michaellangford99/ECE47700/README.md

# ECE47700

Placeholder for eventual Github Pages display of course information
