michaellangford99/ECE47700/docs/status reports/michael_langford/wk15/progress_report_wk15.htm

IMU

This was mostly last week, but I created an algorithm to modify in real time the parameter controlling the relative trust the complementary filter has in the gyro vs. the accelerometer. It works by sensing when the length of the vector comprising the total acceleration felt by the accelerometer is greater in magnitude than 1G, indicating that noise or movement is taking place. The differential is then used to generate a correction factor to apply to the parameter ‘Alpha’ which estimates which measurement is more accurate.

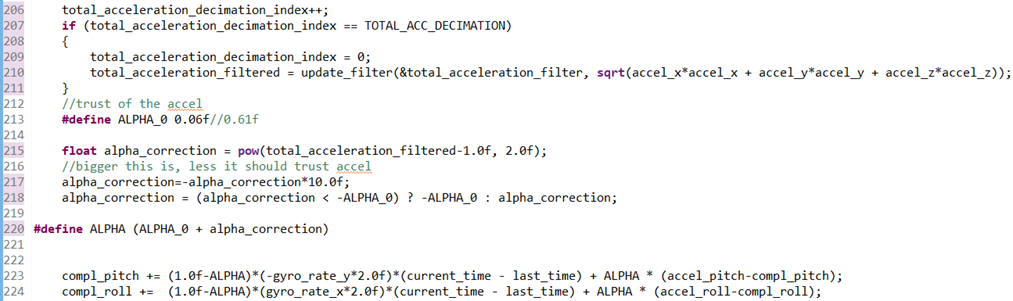
[picture p62: docs/status reports/michael_langford/wk15/progress_report_wk15_files/image002.png]
Text Description automatically generated with medium confidence


Fig. 15- 1. Source code of filter correction algorithm

In addition to the LSM6DSO, there is also an MPU6500 on the PCB, which has not as yet been used. I also wrote driver code for that this week, which wasn’t hard seeing as I already had code for it from an old project. This meant the bulk of the effort was just switching from the previous project’s SPI implementation to the current one. I then cloned the LSM6DSO driver’s calibration and sensor fusion code, and got things nearly working, and then 4

Due to my original code structure, there was no way to change or specify the CS pin, meaning that the SPI bus would blindly use the CS pin it chose on startup, rather than using different ones per device. So I created a structure that holds the IMU data that can be accessed by any other C file, as well as adding functionality and pin setup code to select which CS pin is active at that point in time, and the SPI driver will switch to using that one.

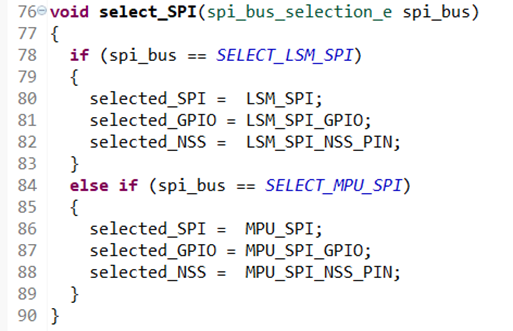
[picture p63: docs/status reports/michael_langford/wk15/progress_report_wk15_files/image004.png]


Fig. 15- 2. SPI bus selection

With this new structure working, I tried running the full PID loop + motor + radio code to test the response of the drone. Unfortunately, I noticed immediately that there was a huge issue with the noise induced in the data by the vibration from the motors running.

I found an application that can perform a real time FFT on incoming serial data, to take a look at the noise spectrum while the motors are running. I was hoping all the noise was high frequency and could be filtered, however it was broadband, and the gyro was hitting it’s max dynamic range as well.

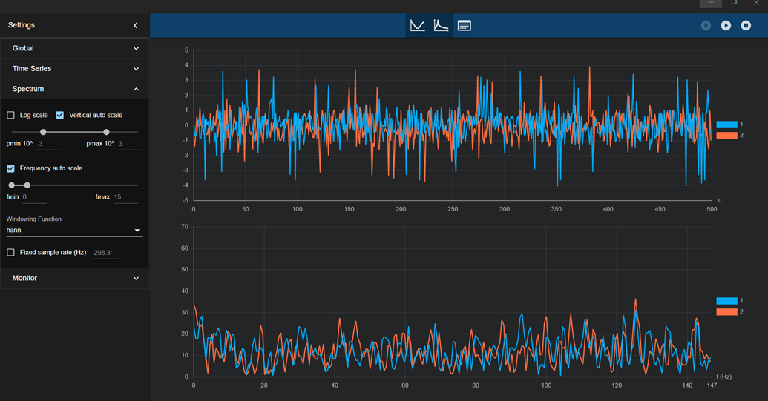
[picture p64: docs/status reports/michael_langford/wk15/progress_report_wk15_files/image006.png]


Fig. 15- 3. Serial Spectrogram

With the motors running and the drone still, the pitch and roll quickly diverged from an accurate measurement of the heading.

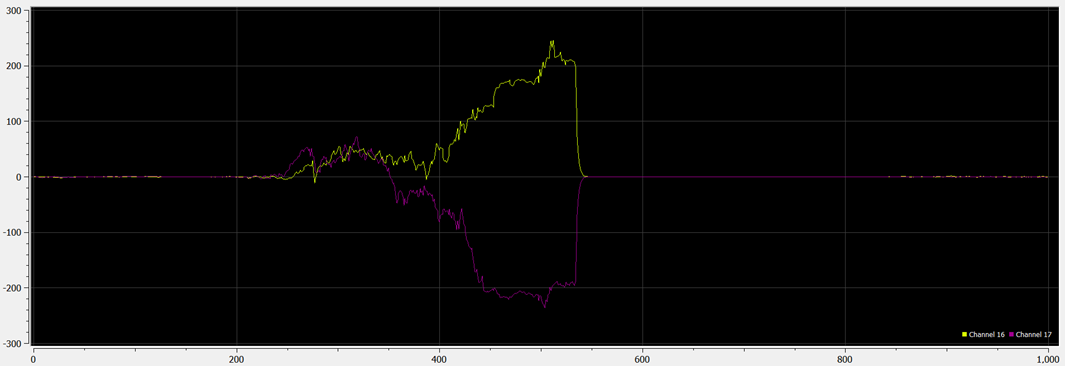
[picture p65: docs/status reports/michael_langford/wk15/progress_report_wk15_files/image008.png]


Fig. 15- 4. Very messed up gyro readings

Mechanical

In order to fix the vibration issues, I had to use an alternate mount to the original rigid mounting setup. I found a piece of soft anti-static foam, and glued the 3D printed mount onto the foam, and then onto the motor controller.

I initially just tried using O-rings at the mount points, however this wasn’t sufficient.

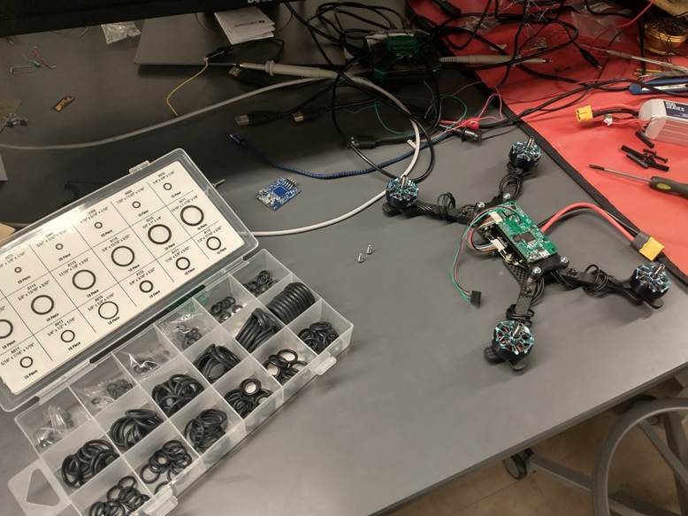
[picture p66: docs/status reports/michael_langford/wk15/progress_report_wk15_files/image010.jpg]


Fig. 15- 5. Trying to use O-rings to damped vibration

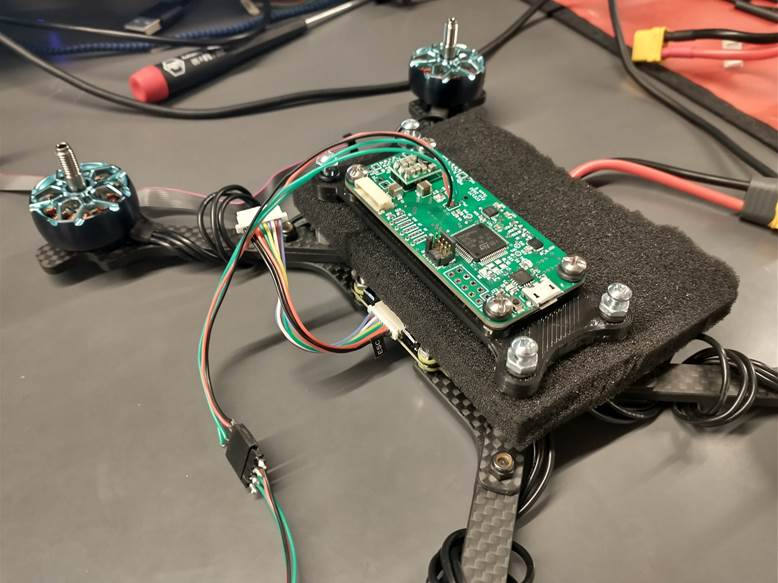
[picture p67: docs/status reports/michael_langford/wk15/progress_report_wk15_files/image011.jpg]
A circuit board with wires Description automatically generated with low confidence


Fig. 15- 6. Trying out foam

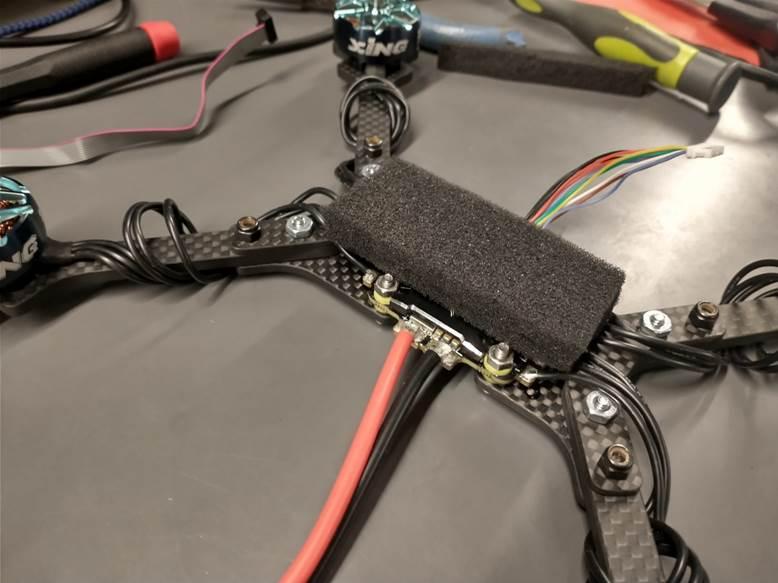
[picture p68: docs/status reports/michael_langford/wk15/progress_report_wk15_files/image012.jpg]


Fig. 15- 7. Foam sized properly

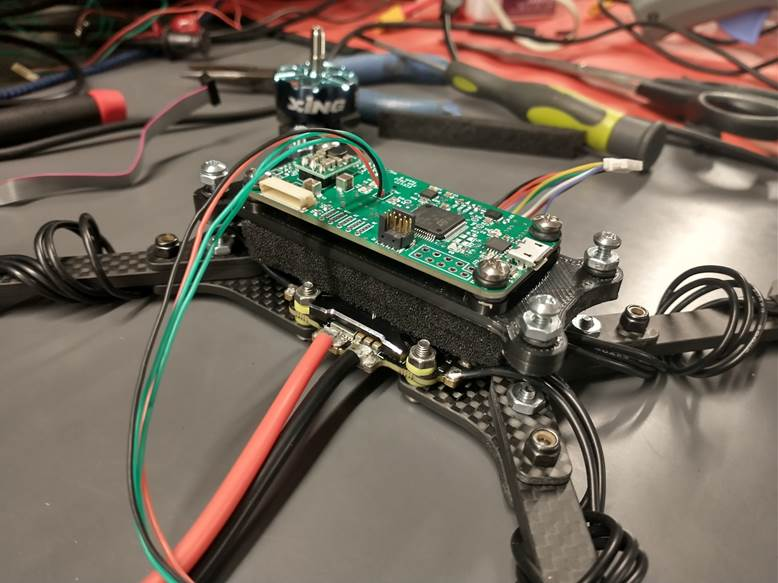
[picture p69: docs/status reports/michael_langford/wk15/progress_report_wk15_files/image014.jpg]


Fig. 15- 8. Trying foam and rubber mounts

Once I mounted the flight controller on the foam, the noise was drastically reduced, almost eliminated. Aside from some resonance rpm rates, the noise stayed within or close to the inherent variance of the sensor.

Battery

In addition to the mechanical work to avoid vibration, I also mounted the battery to the bottom of the drone using some very strong Velcro-ish stuff.

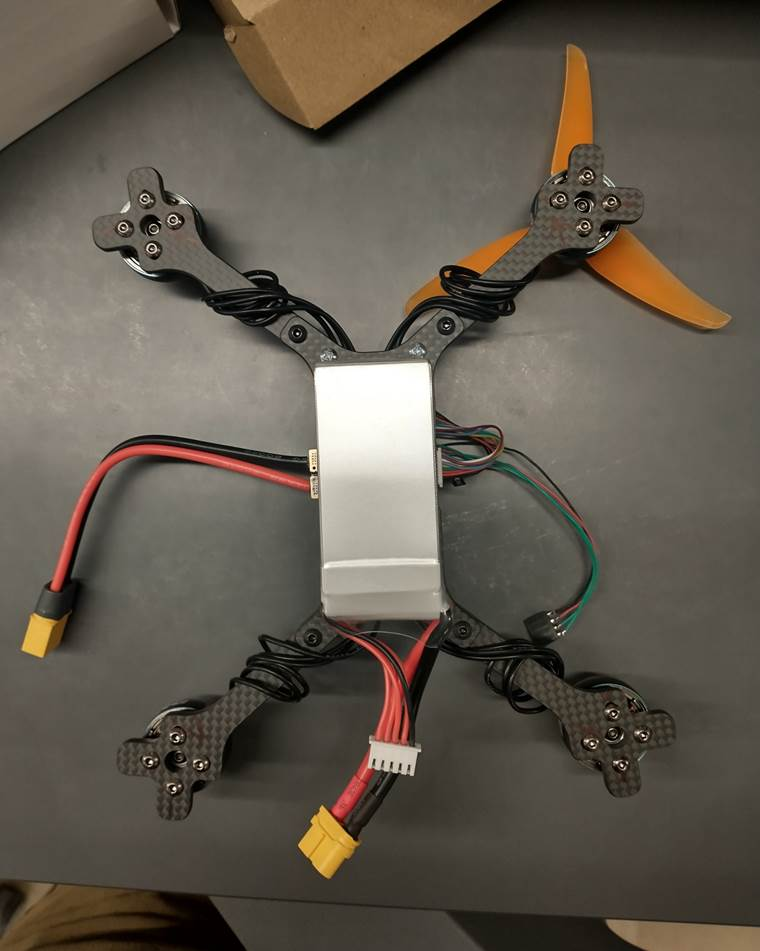
[picture p70: docs/status reports/michael_langford/wk15/progress_report_wk15_files/image015.jpg]


Fig. 15- 9. Battery mounted

As an aside, the usage of the batteries during testing finally necessitated charging, so we used a typical multi-cell LiPo charger to charge them.

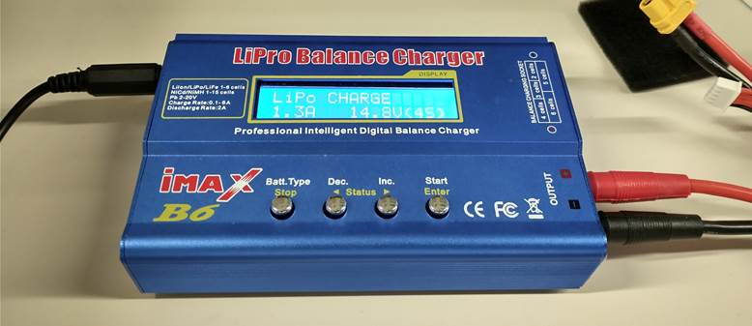
[picture p71: docs/status reports/michael_langford/wk15/progress_report_wk15_files/image016.jpg]


Fig. 15- 10. Just your average neighborhood battery charger

Radio

The radio also had to be permanently mounted, as it had been connected with a temporary connector initially. I detached the original connector and soldered the radio directly to the original wires. I then hot-glued the radio onto a nylon standoff, and glued that onto an unused part of the PCB.

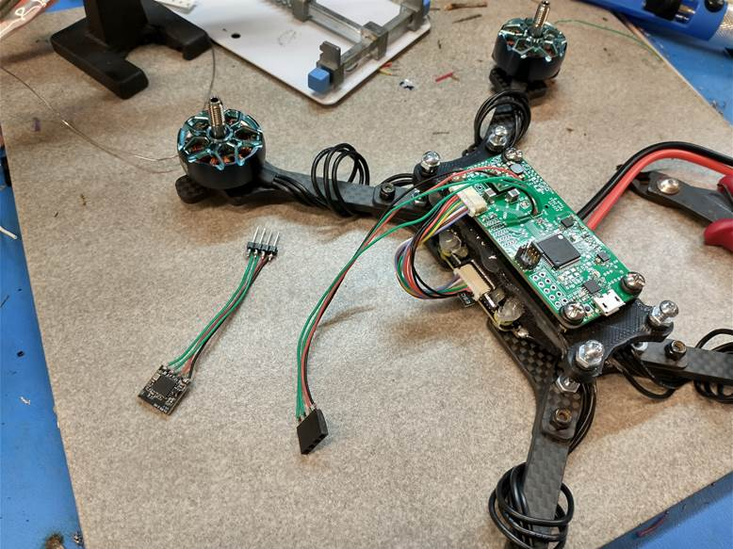
[picture p72: docs/status reports/michael_langford/wk15/progress_report_wk15_files/image017.jpg]


Fig. 15- 11. Radio before

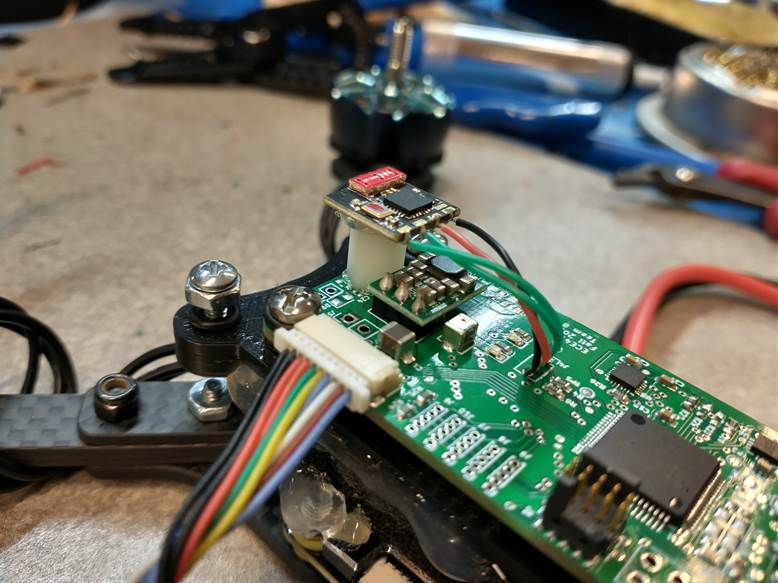
[picture p73: docs/status reports/michael_langford/wk15/progress_report_wk15_files/image018.jpg]


Fig. 15- 12. Radio after

PI UART

On the navigation computer side, Owen has been working on UART comms to and from the flight controller, so on my end I worked on completing the UART code necessary to both transmit IMU data frames as well as interpret LIDAR information and steering commands coming from the PI. We together decided upon a simple binary frame format for the transmission from the PI to the flight controller, to lessen the processing burden of having to parse any stringified data. A predefined start code ‘magic number’, a predefined structured data packet, and a CRC byte makes up the frame. There are 4 LiDAR sensors read by the PI, as well as 3 steering heading commands (yaw, pitch and roll). The LiDAR readings are 16 bits each, so 8 bytes total, and the headings are 32 bit floats, so 12 bytes total for headings. Plus the camera status, start code, and CRC, that makes 23 bytes of data. Or so we thought – the Pi was surprisingly 32 bit aligning the 3 float values sent, so in between there actually 2 bytes of zero-padding, making the actual packet length 25 bytes.



Fig. 15- 13. Pi to flight controller frame format (credit: used https://wavedrom.com/ to draw)

The code to accomplish this was very similar to the radio receiver parsing code, where it looks for valid conditions within a circular buffer. The code automatically adapts to any new definition or change to the internal packet layout, making editing and extension easy.

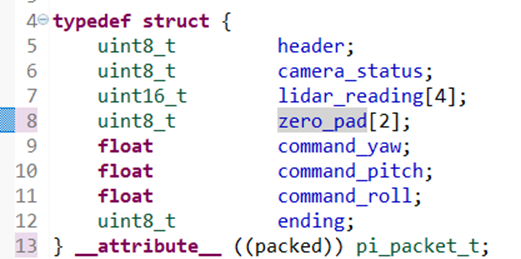
[picture p74: docs/status reports/michael_langford/wk15/progress_report_wk15_files/image030.png]


Fig. 15- 14. Pi to flight controller frame struct

To test this setup, Owen and I wired a cable between his Pi and the flight controller, sharing ground in addition to the UART RX and TX lines. I used the actual pins that will be used for the Pi once it mounts directly, to avoid any issues with changing pins.

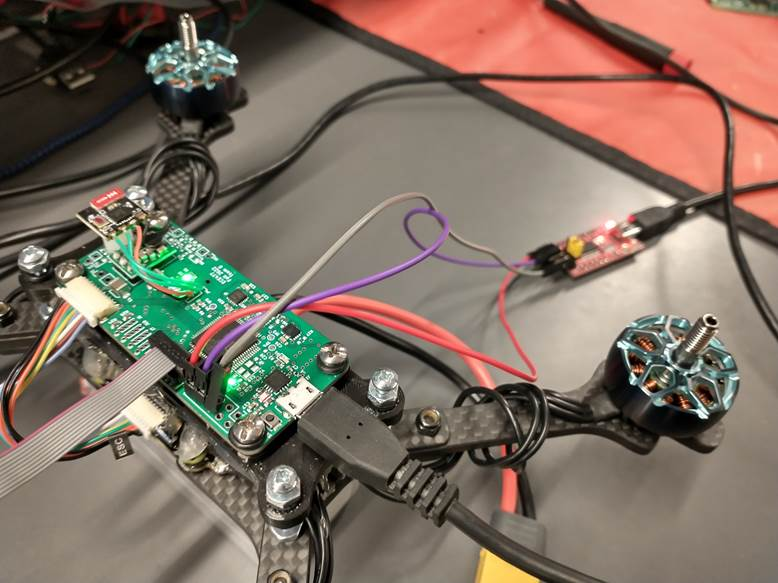
[picture p75: docs/status reports/michael_langford/wk15/progress_report_wk15_files/image031.jpg]


Fig. 15- 15. Testing Pi communication initially with FTDI

For the information transmitted from the flight controller to the Pi, we decided upon a printf string of comma separated values for yaw, pitch, roll, and any other values that become necessary. This text is very easy to for the Pi to parse, especially as it has the necessary computing power needed to parse it quickly.

Before testing with the Pi, I used an FDTI to inspect the outbound data from the Pi, and could inject commands to the flight controller and see if those commands were reflected in the output from the USB UART port.

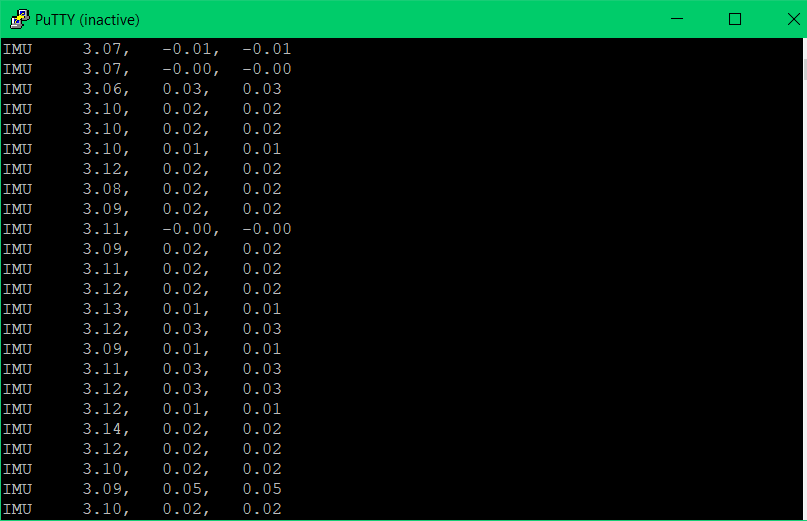
[picture p76: docs/status reports/michael_langford/wk15/progress_report_wk15_files/image032.png]


Fig. 15- 16. IMU frames from flight controller to Pi, recorded via FTDI

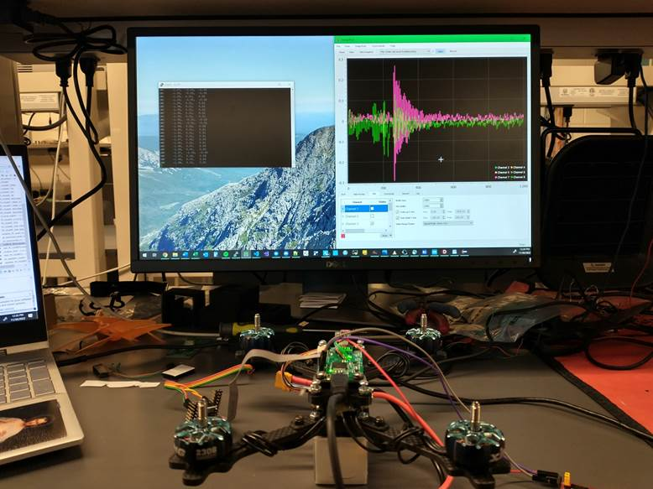
[picture p77: docs/status reports/michael_langford/wk15/progress_report_wk15_files/image033.jpg]


Fig. 15- 17. Testing IMU frame transmission to Pi. Both USB UART log (plot on right) and PI UART are active simultaneously.

Once my side was working, we integrated our hardware with a long cable to carry the serial data from board to board. I kept the FTDI listening in on the communications however to verify functionality.

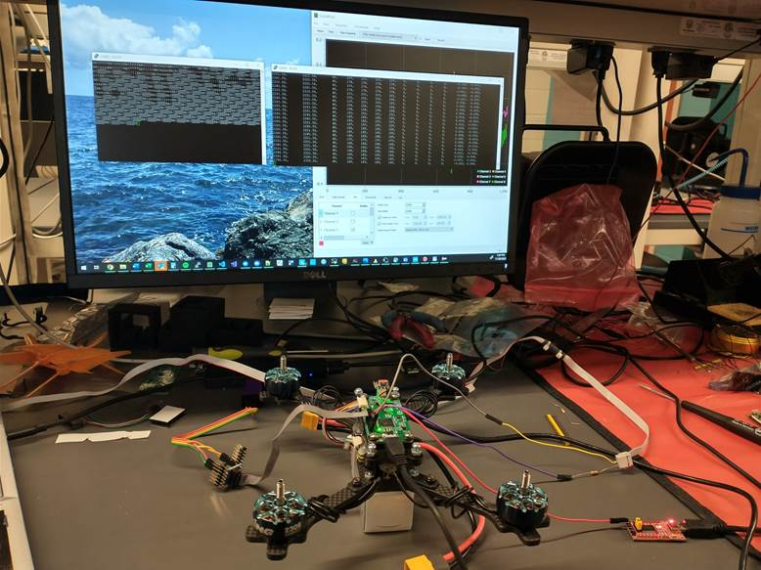
[picture p78: docs/status reports/michael_langford/wk15/progress_report_wk15_files/image034.jpg]


Fig. 15- 18. UARTs side by side. Pi UART (left) shows binary stream from Pi.

After a few kinks were worked out, the LiDAR data streamed over via the serial cable, was interpreted by the Pi UART driver, and recorded. Then this data was printed out via the main log.

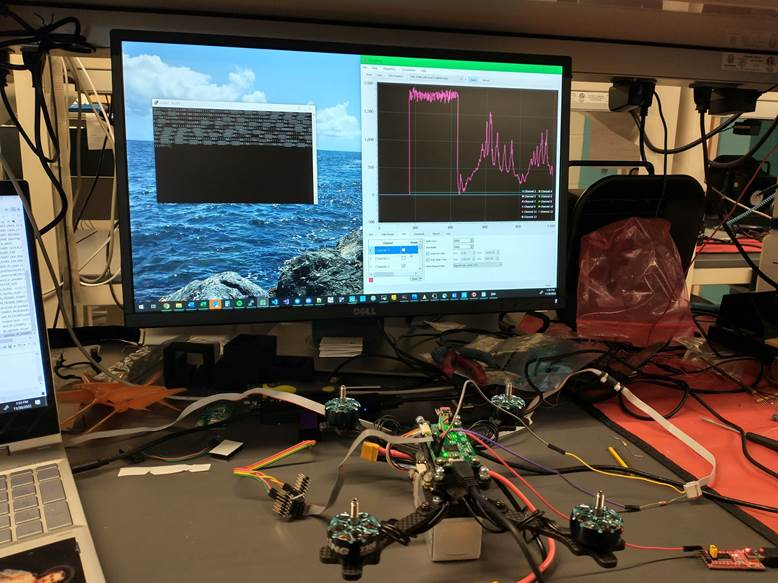
[picture p79: docs/status reports/michael_langford/wk15/progress_report_wk15_files/image038.jpg]


Fig. 15- 19. LiDAR data finally streaming through from PI

Motors

This week I also switched to using OneShot125 correctly and running it at maximum data rate, around 3.8kHz, rather than the previous 400Hz.



Fig. 15- 20. Oneshot125 Timing diagram.

After testing the PID loops with the motors running, and readying the drone for test flights, I needed to ensure that the propellers on the drone were spinning the correct direction. The torque induced from the motors rotating is very significant, and if the motors spin the wrong direction this torque will not be counteracted and will spin the drone out of control.

For this reason, half the motors have to spin counterclockwise and half clockwise. However, if just any two are chosen, then when the drone attempts to counteract an imbalance in pitch or roll, it may change the speeds of the motor pair that spins in the same direction, resulting in a torque differential, and then spin. Thus, it must have the motors on a diagonal with each other spin in the same direction. Thus when any pair of motors on a side changes speeds, both the CCW spinning motor and the CW spinning motor will change speeds equally, resulting in net zero torque.

Switching motor spin direction can be as simple as swapping two wires in the motor hookup, however I wanted to avoid this as I had already had enough of a painful experience soldering the motors the first time.

Instead of soldering again, it is possible to reprogram the ESC settings to change its pulse order so that the motor spins in reverse of its original direction. This is usually a really simple process for people with commercially available flight controllers with popular software onboard, less so for me with a custom flight controller. Most flight controllers have a feature that allows the flight controller to act as a pass-through reprogrammer for the ESC.

As my poor little flight controller can’t do that, I had to dig around online for other solutions. Apparently, it is possible to use an Arduino nano and some prebaked hex files to get it to act as a programmer. This was very poorly documented, so it took a lot of trial and error and hair-pulling.

I want to include the details of this process in this progress report to serve as a more permanent record of how I got this to work.

First, I acquired an Arduino Nano that was in storage. I then installed the necessary CH340 UART to USB drivers, and connected the Nano.

Next, I created a cable to go between the JST ESC connector and the breadboard with the Nano. This was a huge pain with the pitch of the pins, but I got it to work eventually.

I then flashed the Nano via the BLHeli_32 configurator software:

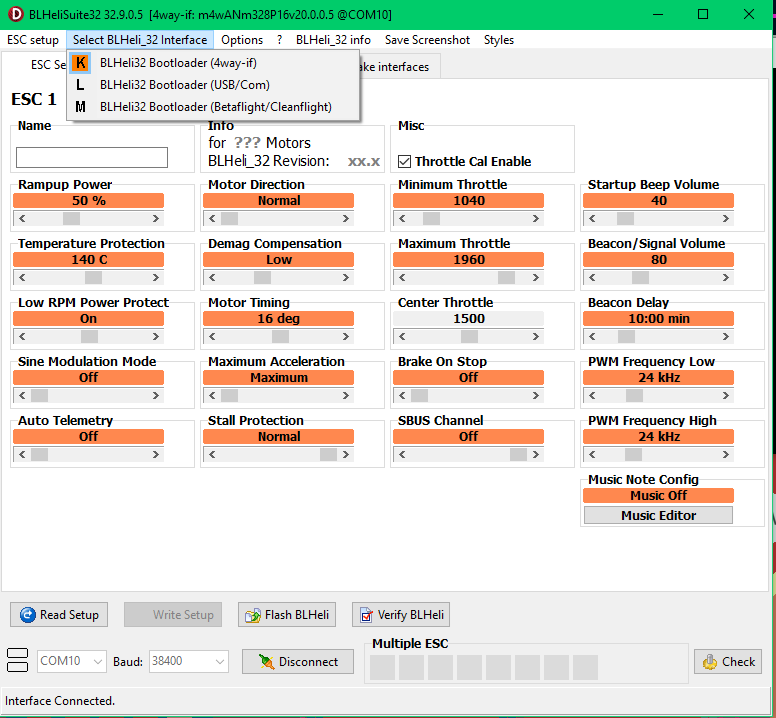
[picture p80: docs/status reports/michael_langford/wk15/progress_report_wk15_files/image042.png]


Fig. 15- 21. BLHeli_32 Configurator

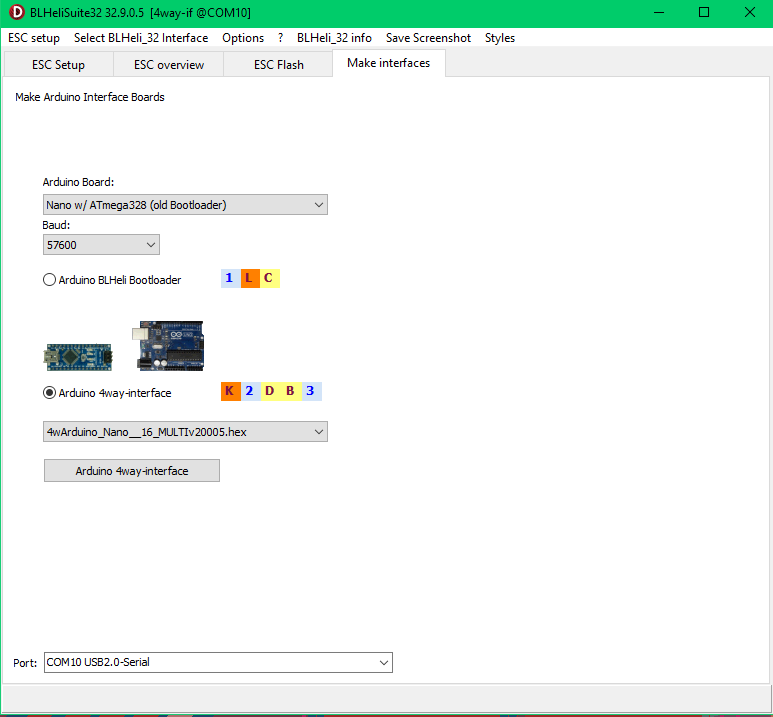
[picture p81: docs/status reports/michael_langford/wk15/progress_report_wk15_files/image044.png]


Fig. 15- 22. Flashing the Nano. Select 'Arduino 4-way-interface' and the correct board.

Next, I had to determine the correct pins on the Nano to hook up the ESC PWM pins to. After (a lot of) hunting around, I found a document identifying for which Arduino board the pins I aught to use, especially for a 4 channel ESC. Seeing as I was using a Nano, this indicated I should use D3,4,5, & 6.

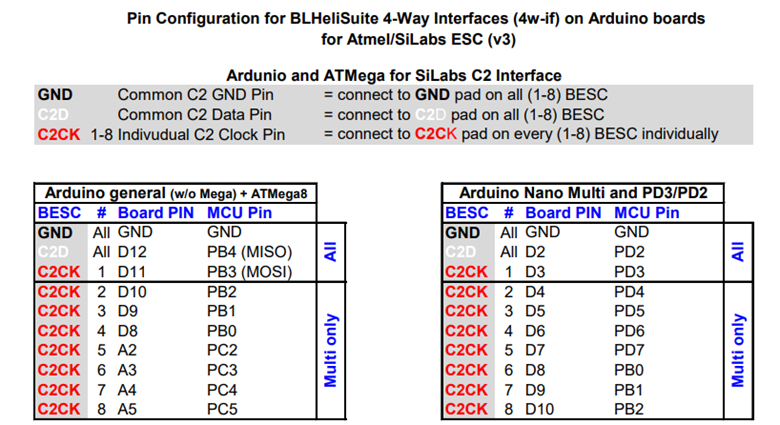
[picture p82: docs/status reports/michael_langford/wk15/progress_report_wk15_files/image048.png]
Table Description automatically generated


Fig. 15- 23. BLHeli32 Pin options for Arduino

After wiring everything up, my setup was as shown.

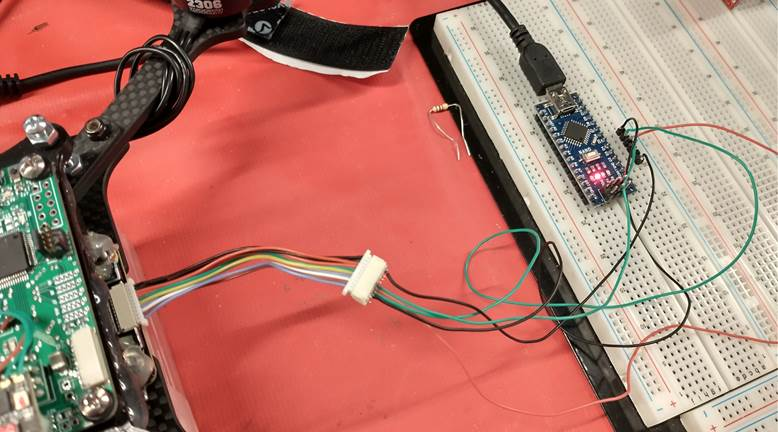
[picture p83: docs/status reports/michael_langford/wk15/progress_report_wk15_files/image050.jpg]


Fig. 15- 24. Connection from ESC to Nano

Once the wiring was set up properly, I was able to connect to the Nano and then to the ESCs.

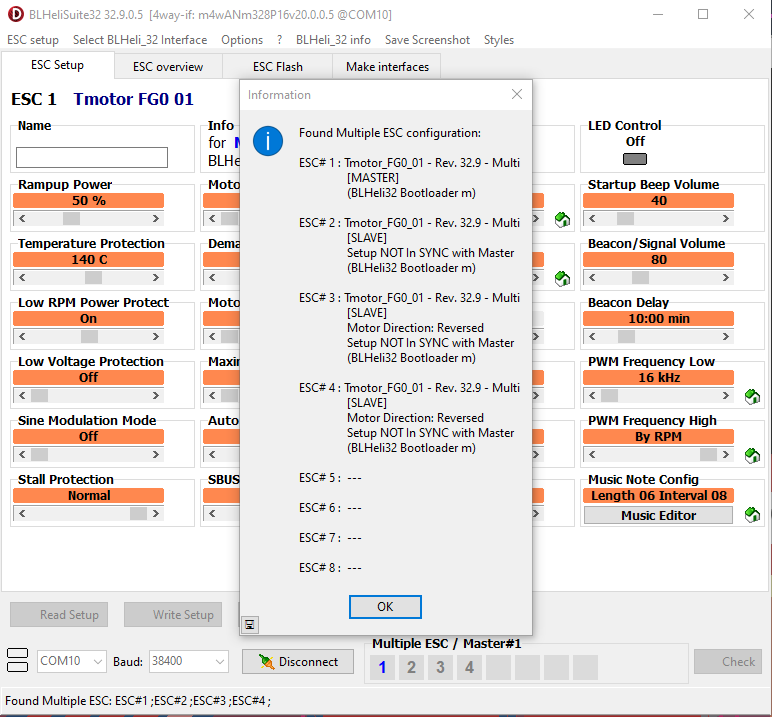
[picture p84: docs/status reports/michael_langford/wk15/progress_report_wk15_files/image052.png]


Fig. 15- 25. BLHeli_32 identifying each of the ESCs on the 4 channel ESC.

With all the ESCs communicating with the configuration software, I was able to identify which motor was connected to which channel, and swap the direction on the needed motor channels.

I then recorded the spin directions on tape to help me keep track of each channel and it’s direction and therefore it’s torque.

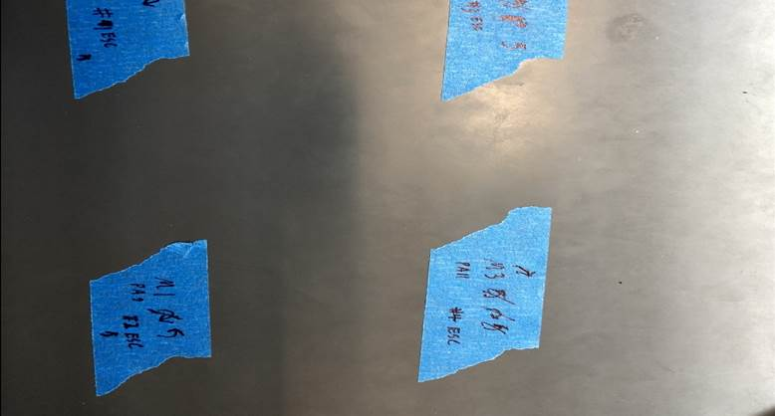
[picture p85: docs/status reports/michael_langford/wk15/progress_report_wk15_files/image060.jpg]


Fig. 15- 26. Recording spin direction

Not mentioned this week due to length:

Safety and arming code

Startup log

PID loop improvements

Motor LPF with hanning window

MATLAB

LIDAR wiring
