michaellangford99/ECE47700/docs/JLCPCB Invoice Team 8.pdf

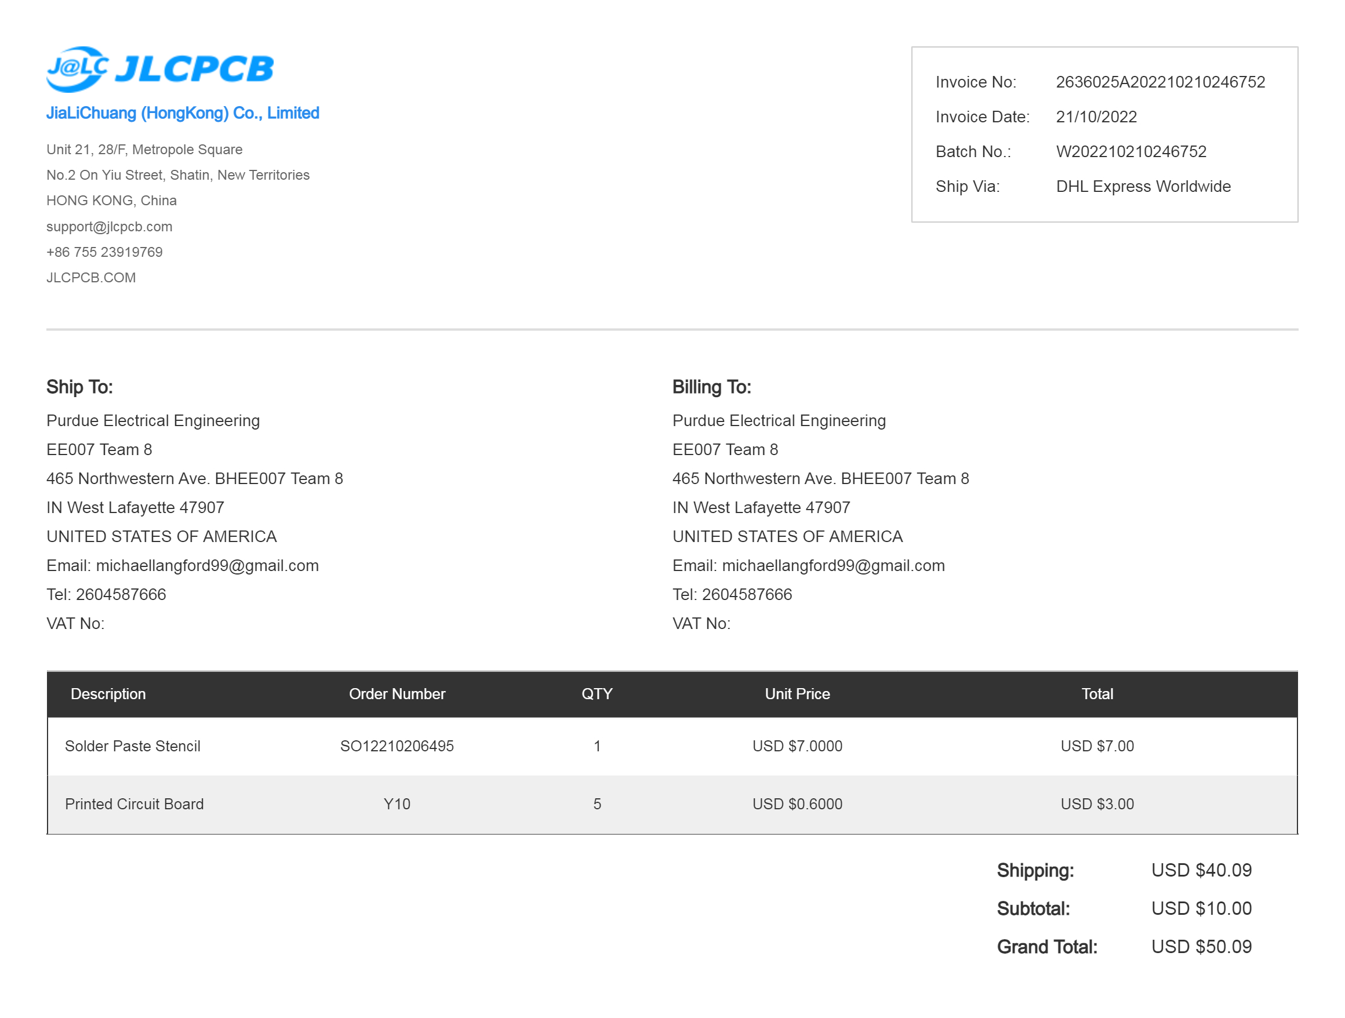
[picture p274: figure]
