michaellangford99/ECE47700/docs/Rough diagram.pdf

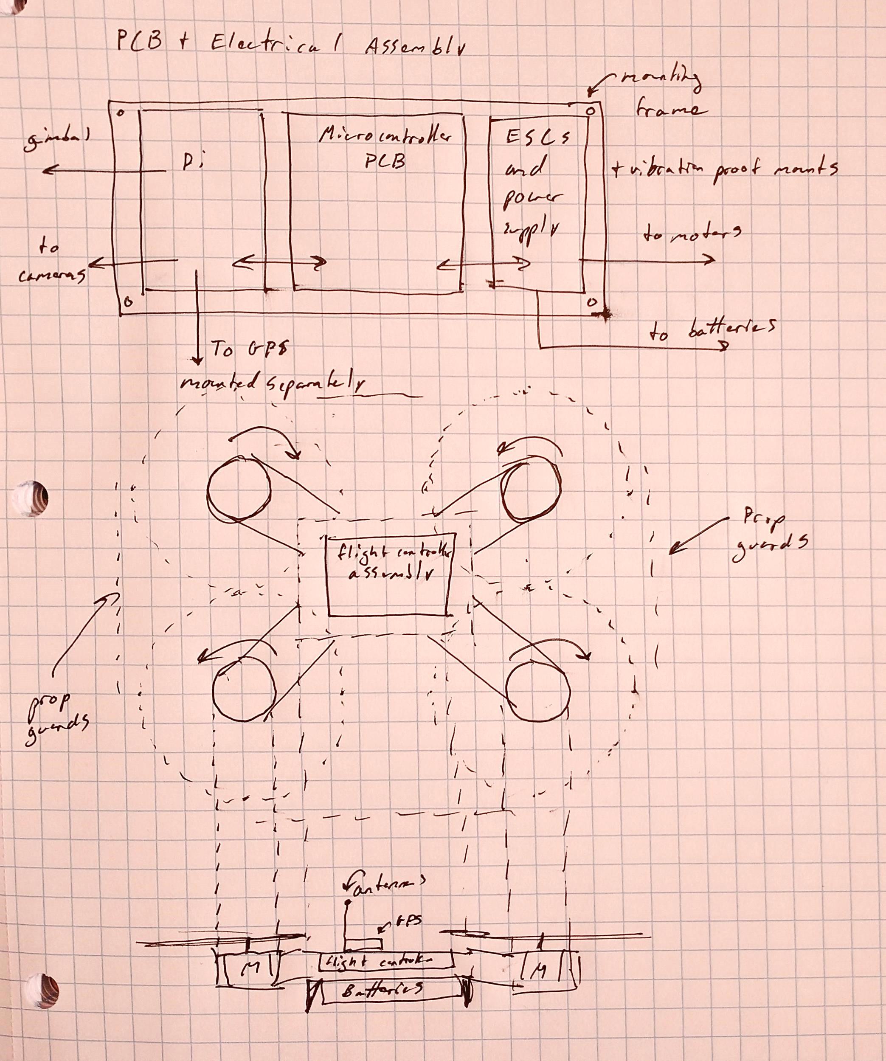
[picture p275: page 1]
