michaellangford99/ECE47700/docs/status reports/michael_langford/schedule.png

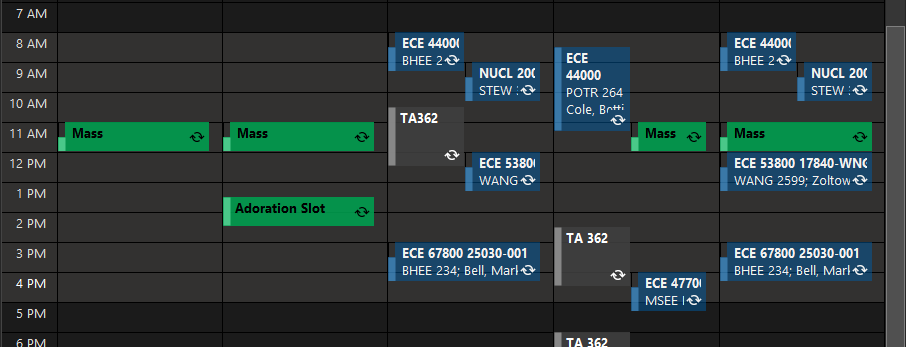
docs/status reports/michael_langford/schedule.png
