michaellangford99/ECE47700/docs/status reports/michael_langford/wk2/pi camera.png

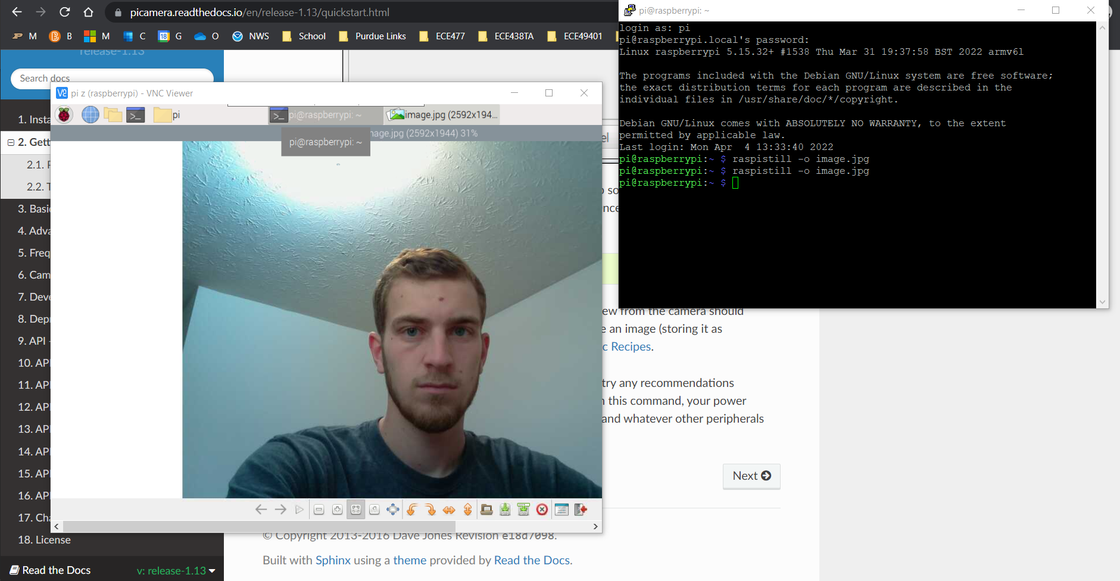
docs/status reports/michael_langford/wk2/pi camera.png
