michaellangford99/ECE47700/docs/status reports/michael_langford/wk3/status_report_wk_3_files/image003.jpg

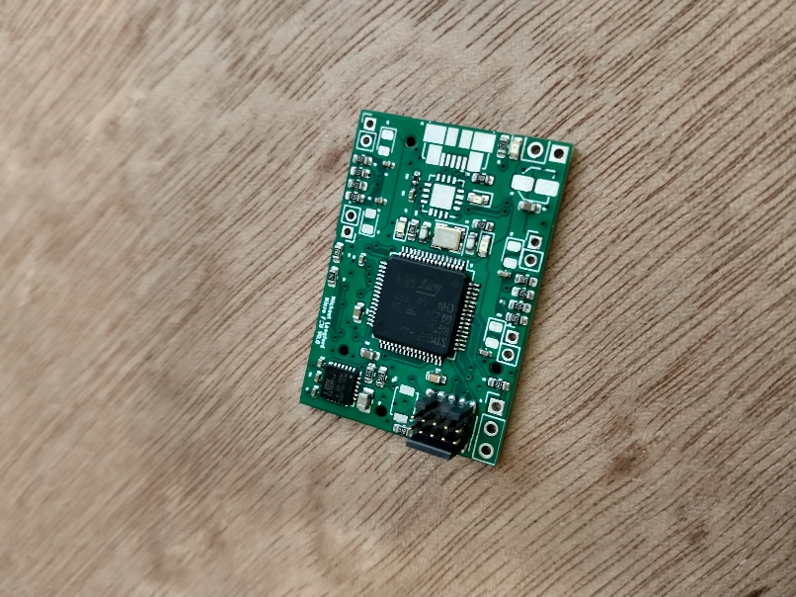
docs/status reports/michael_langford/wk3/status_report_wk_3_files/image003.jpg
