michaellangford99/ECE47700/docs/status reports/michael_langford/wk4/87c77367-0a1b-4ee4-83c8-37e8803b4461.png

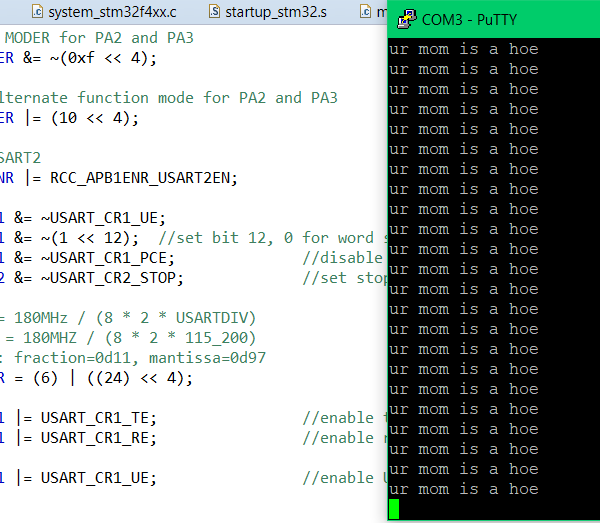
docs/status reports/michael_langford/wk4/87c77367-0a1b-4ee4-83c8-37e8803b4461.png
