michaellangford99/ECE47700/docs/status reports/michael_langford/wk4/progress_report_wk4_files/image013.png

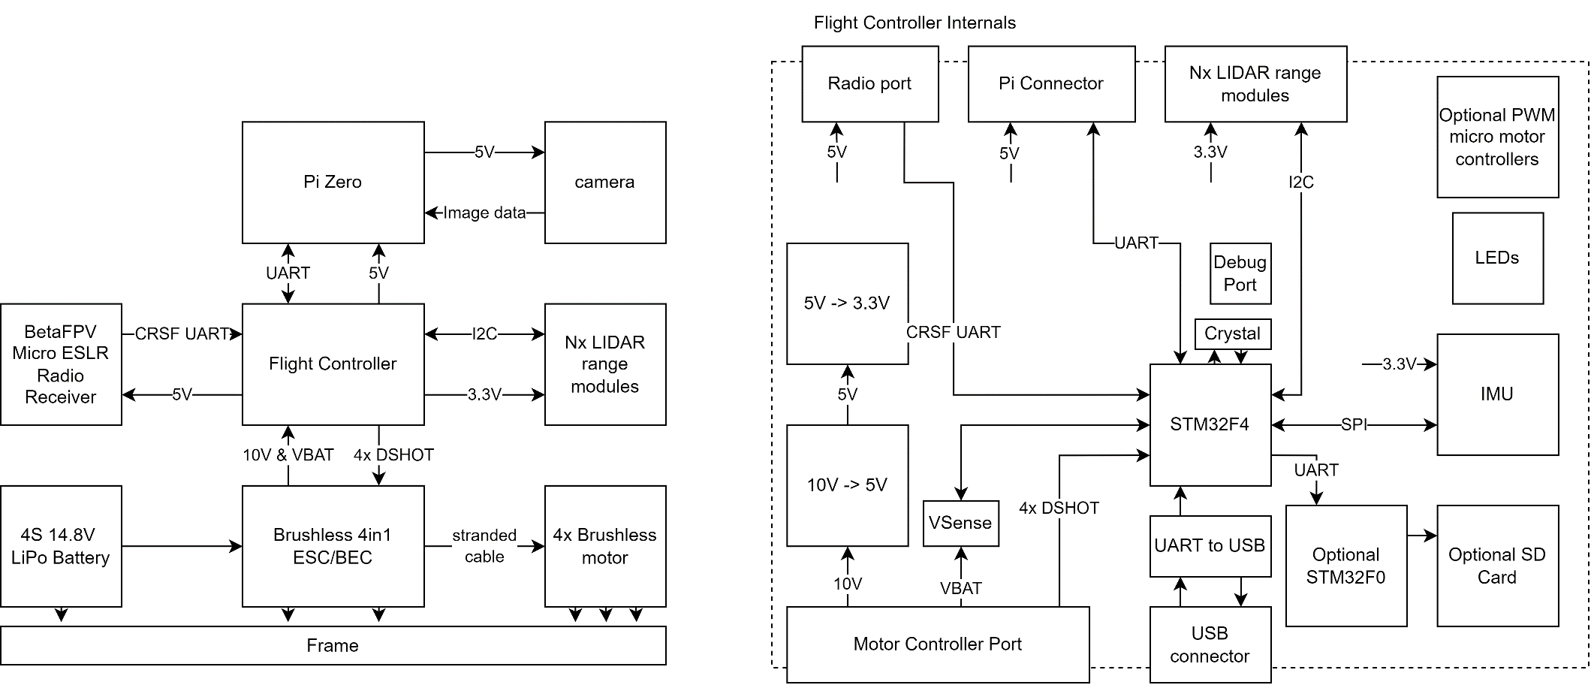
docs/status reports/michael_langford/wk4/progress_report_wk4_files/image013.png
