michaellangford99/ECE47700/docs/status reports/michael_langford/wk5/getting there.png

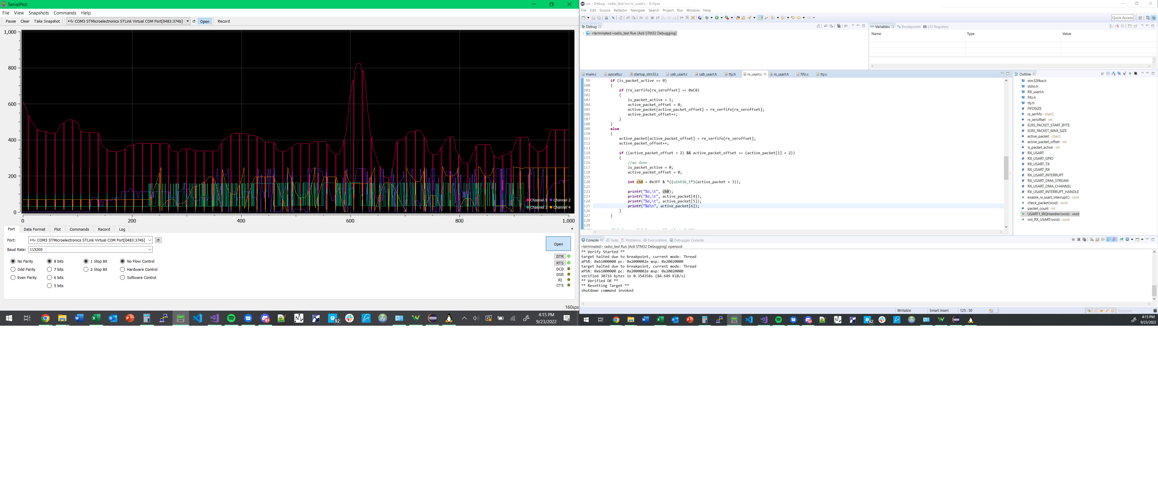
docs/status reports/michael_langford/wk5/getting there.png
