michaellangford99/ECE47700/docs/status reports/michael_langford/wk5/progress_report_wk5_files/image024.jpg

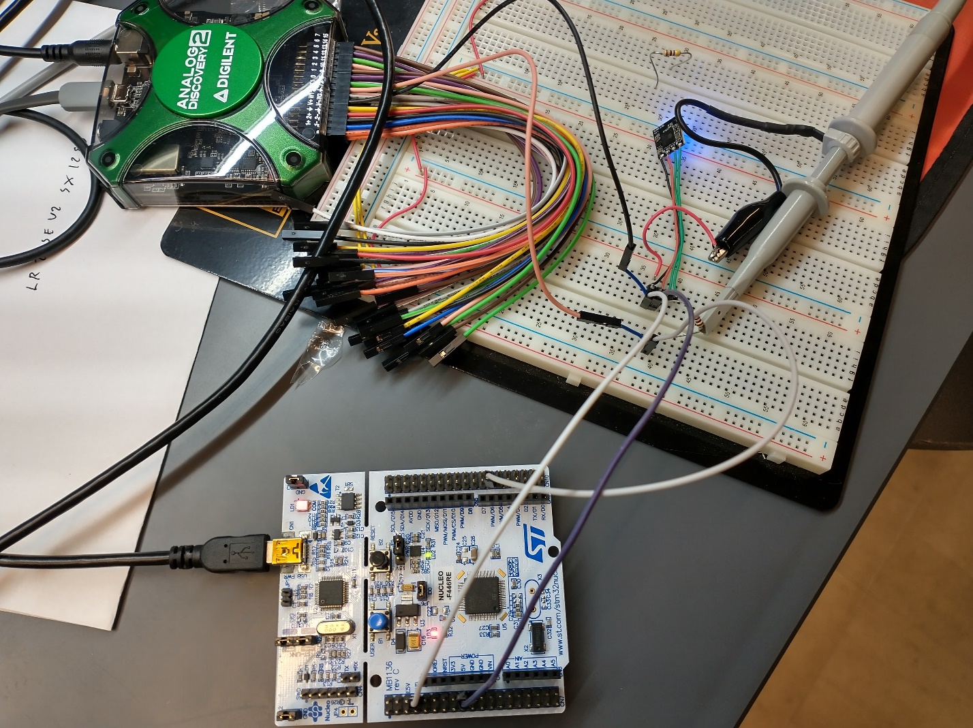
docs/status reports/michael_langford/wk5/progress_report_wk5_files/image024.jpg
