michaellangford99/ECE47700/docs/status reports/michael_langford/wk6/progress_report_wk6_files/image007.jpg

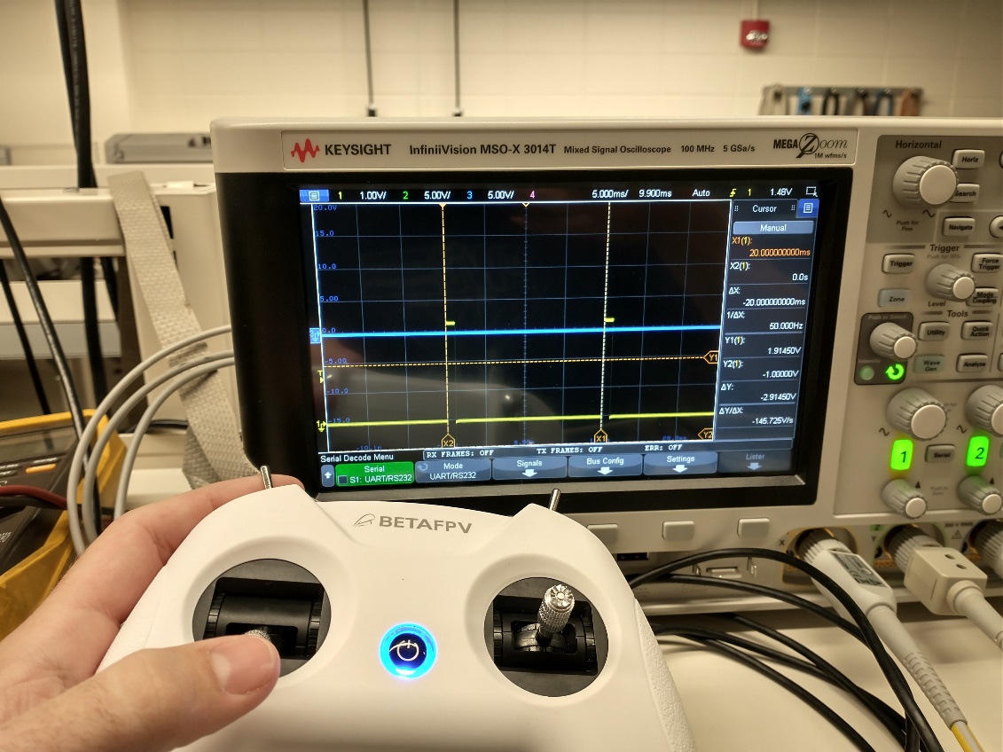
docs/status reports/michael_langford/wk6/progress_report_wk6_files/image007.jpg
