michaellangford99/ECE47700/docs/status reports/michael_langford/wk6/Untitled.png

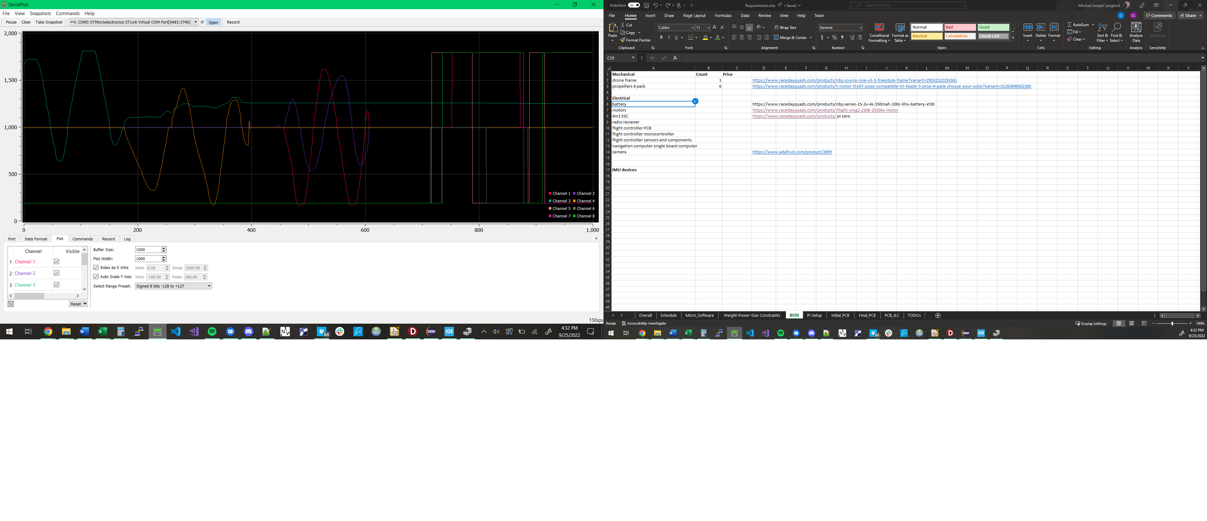
docs/status reports/michael_langford/wk6/Untitled.png
