michaellangford99/ECE47700/docs/status reports/michael_langford/wk10/Screenshot 2022-10-25 192858.png

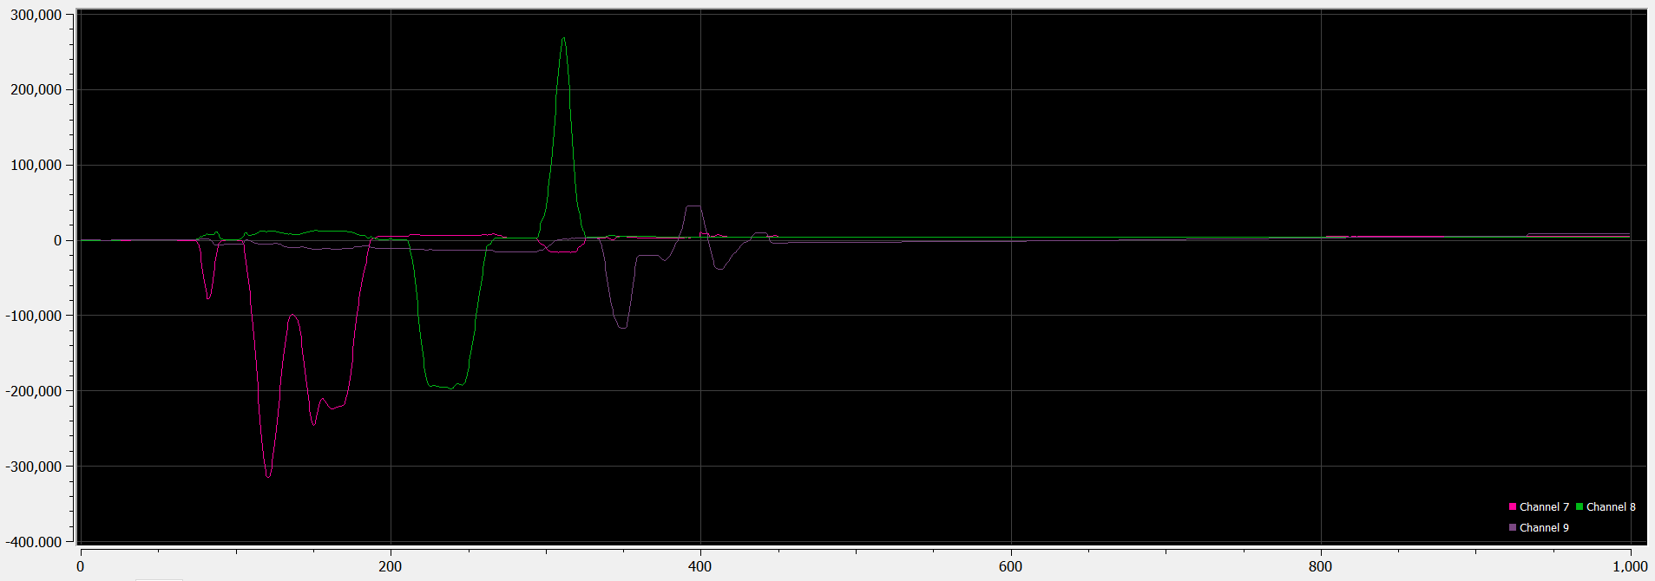
docs/status reports/michael_langford/wk10/Screenshot 2022-10-25 192858.png
