michaellangford99/ECE47700/docs/status reports/michael_langford/wk11/pics/IMG_20221031_231807015_HDR.jpg

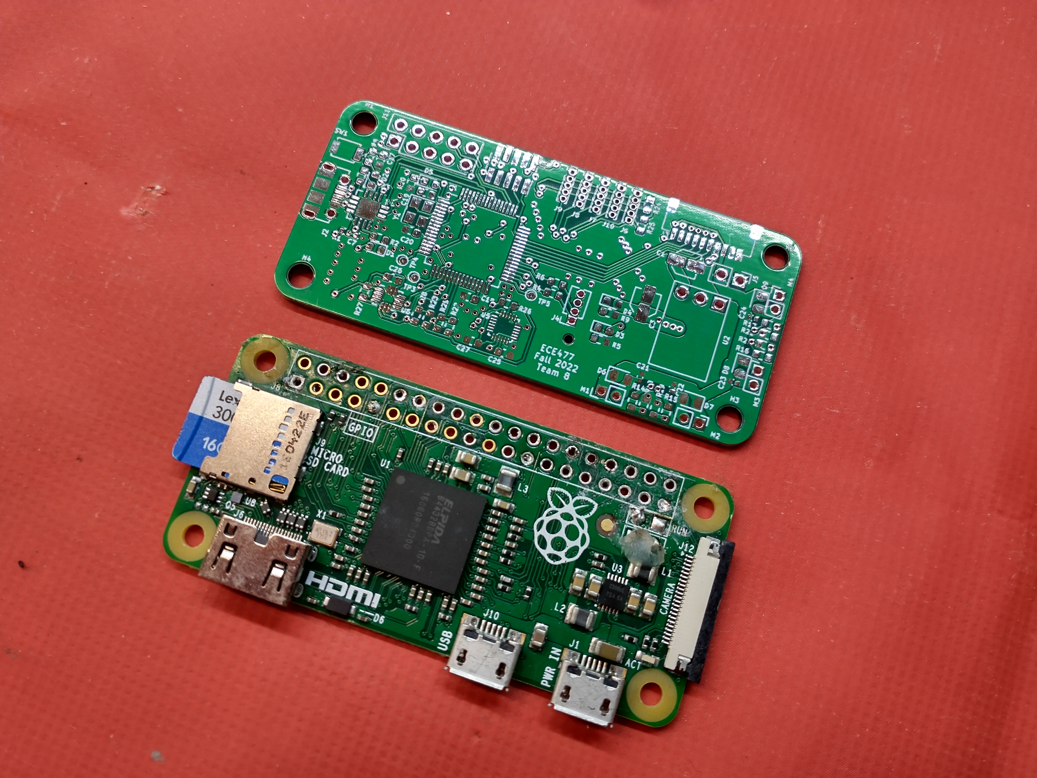
docs/status reports/michael_langford/wk11/pics/IMG_20221031_231807015_HDR.jpg
