michaellangford99/ECE47700/docs/status reports/michael_langford/wk11/pics/IMG_20221101_115827406_HDR.jpg

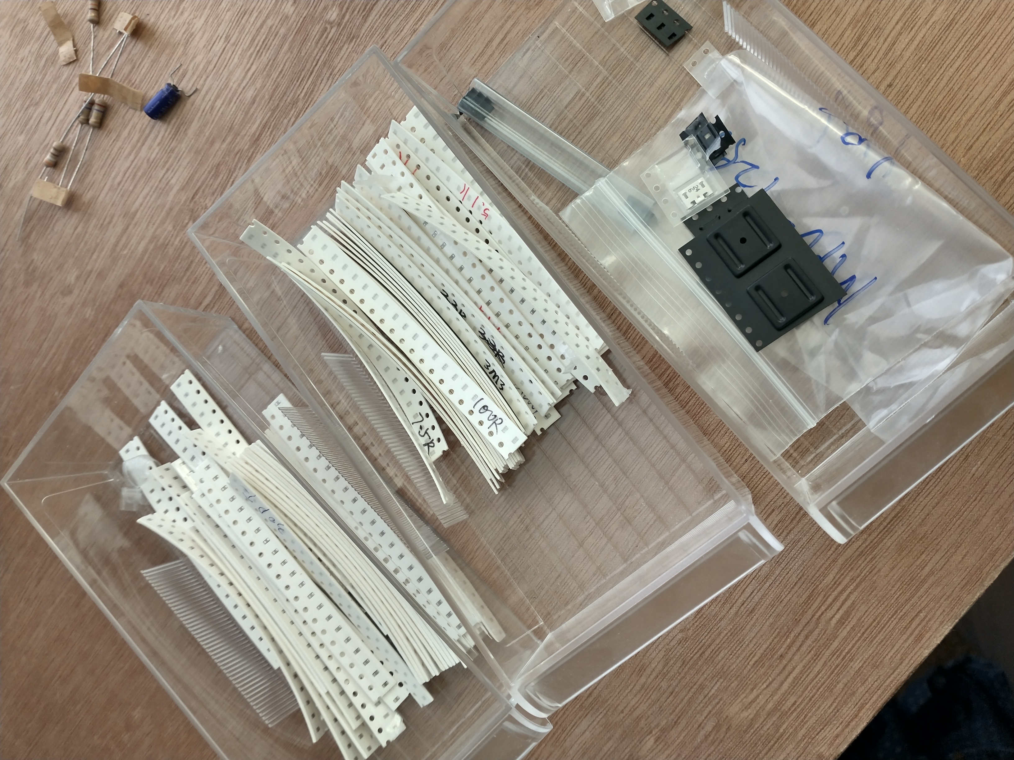
docs/status reports/michael_langford/wk11/pics/IMG_20221101_115827406_HDR.jpg
