michaellangford99/ECE47700/docs/status reports/michael_langford/wk11/pics/IMG_20221101_165526396_HDR.jpg

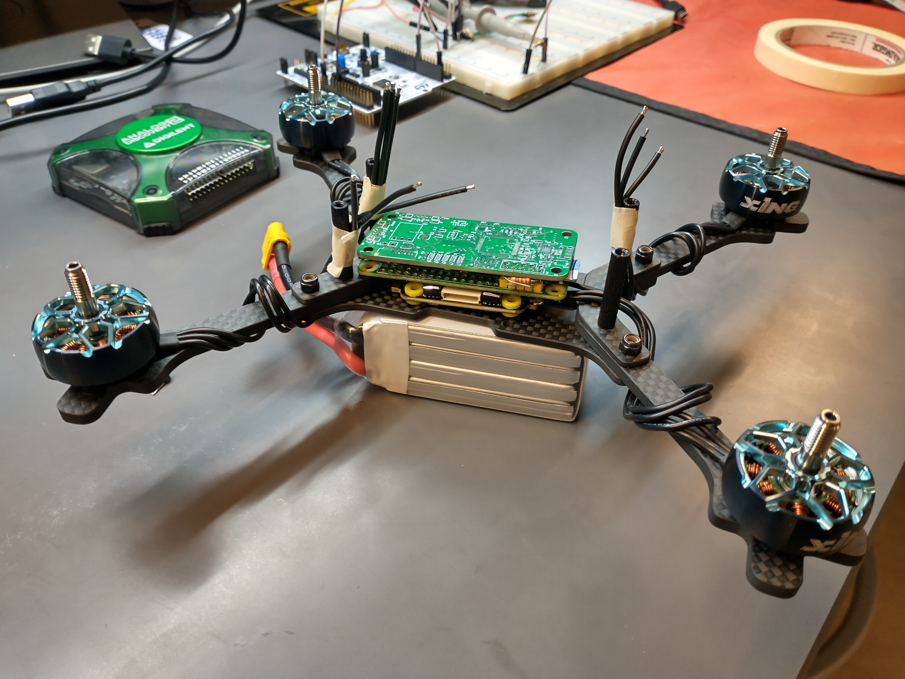
docs/status reports/michael_langford/wk11/pics/IMG_20221101_165526396_HDR.jpg
