michaellangford99/ECE47700/docs/status reports/michael_langford/wk11/progress_report_wk11_files/image011.jpg

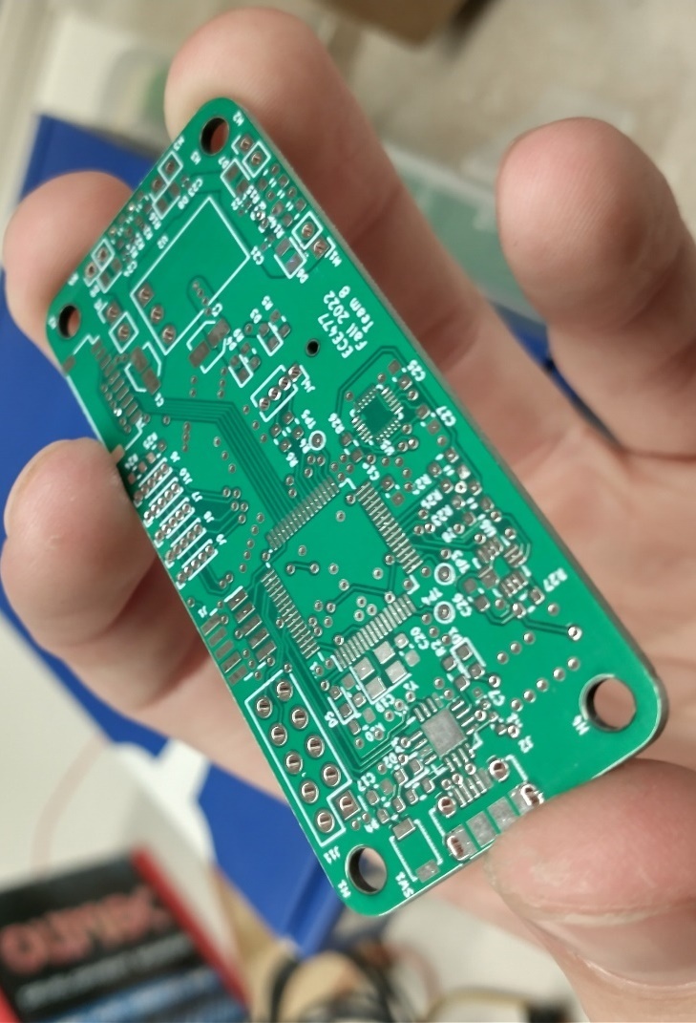
docs/status reports/michael_langford/wk11/progress_report_wk11_files/image011.jpg
