michaellangford99/ECE47700/docs/status reports/michael_langford/wk12/Photos-001 (3)/IMG_20221109_131756544_HDR.jpg

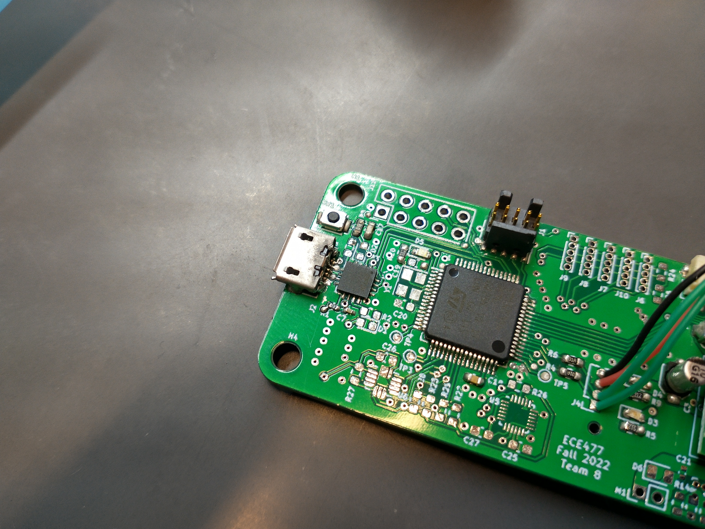
docs/status reports/michael_langford/wk12/Photos-001 (3)/IMG_20221109_131756544_HDR.jpg
