michaellangford99/ECE47700/docs/status reports/michael_langford/wk12/Photos-001 (3)/IMG_20221110_134909605_HDR.jpg

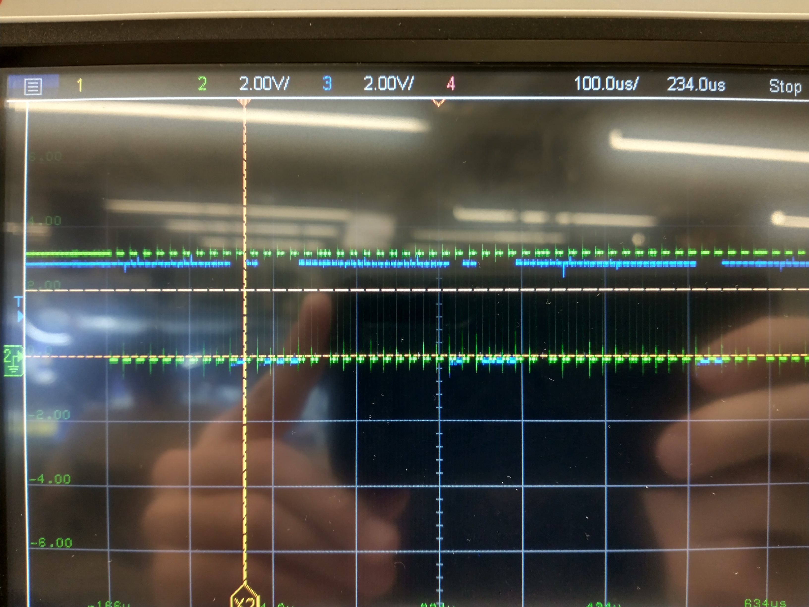
docs/status reports/michael_langford/wk12/Photos-001 (3)/IMG_20221110_134909605_HDR.jpg
