michaellangford99/ECE47700/docs/status reports/michael_langford/wk13/freq_response.png

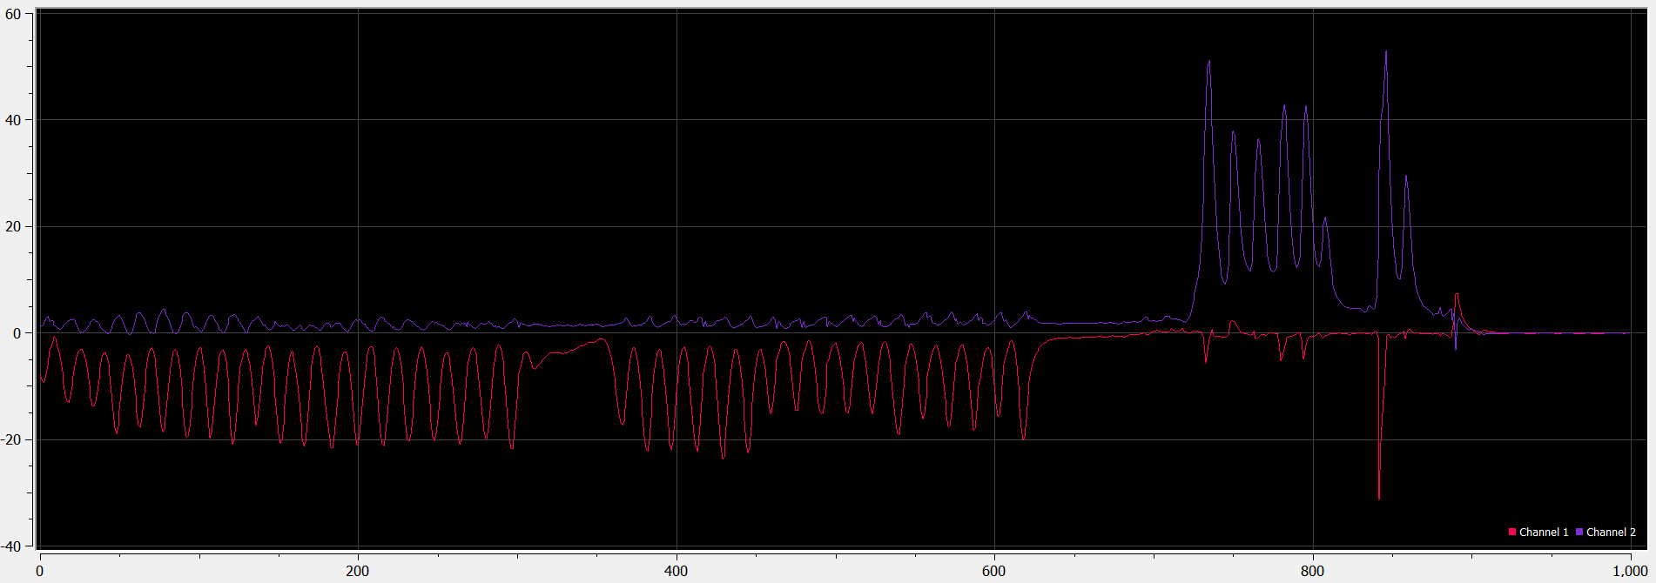
docs/status reports/michael_langford/wk13/freq_response.png
