michaellangford99/ECE47700/docs/status reports/michael_langford/wk13/Photos-001/IMG_20221116_102439111_HDR.jpg

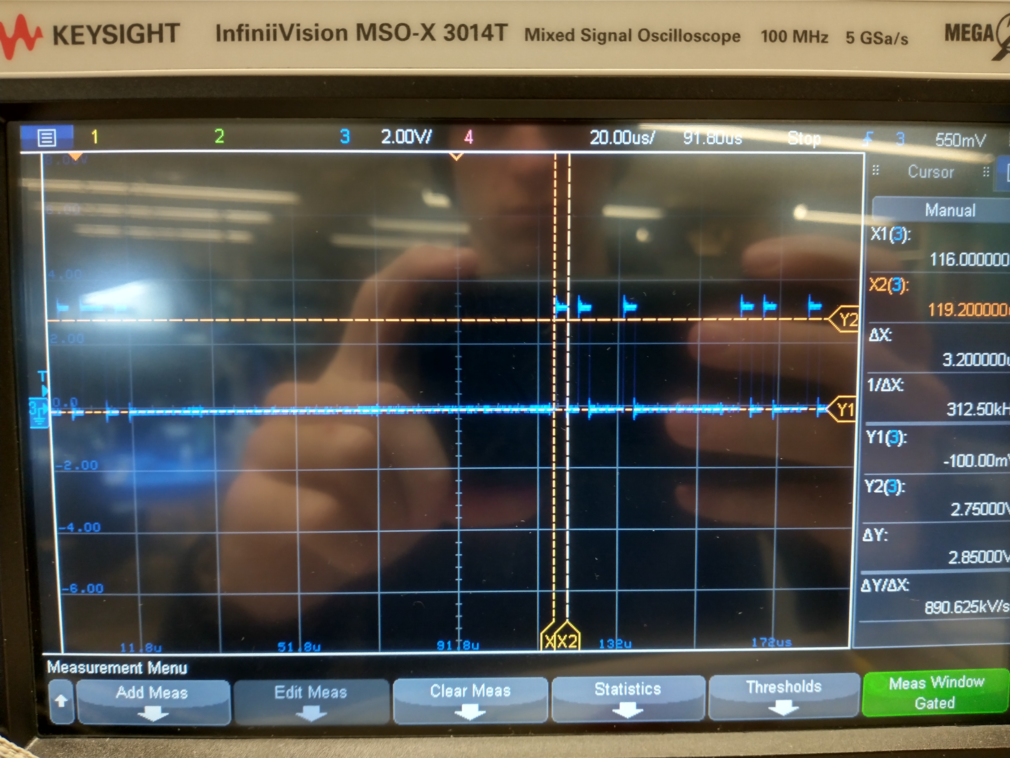
docs/status reports/michael_langford/wk13/Photos-001/IMG_20221116_102439111_HDR.jpg
