michaellangford99/ECE47700/docs/status reports/michael_langford/wk13/Photos-001/IMG_20221116_114551532_HDR.jpg

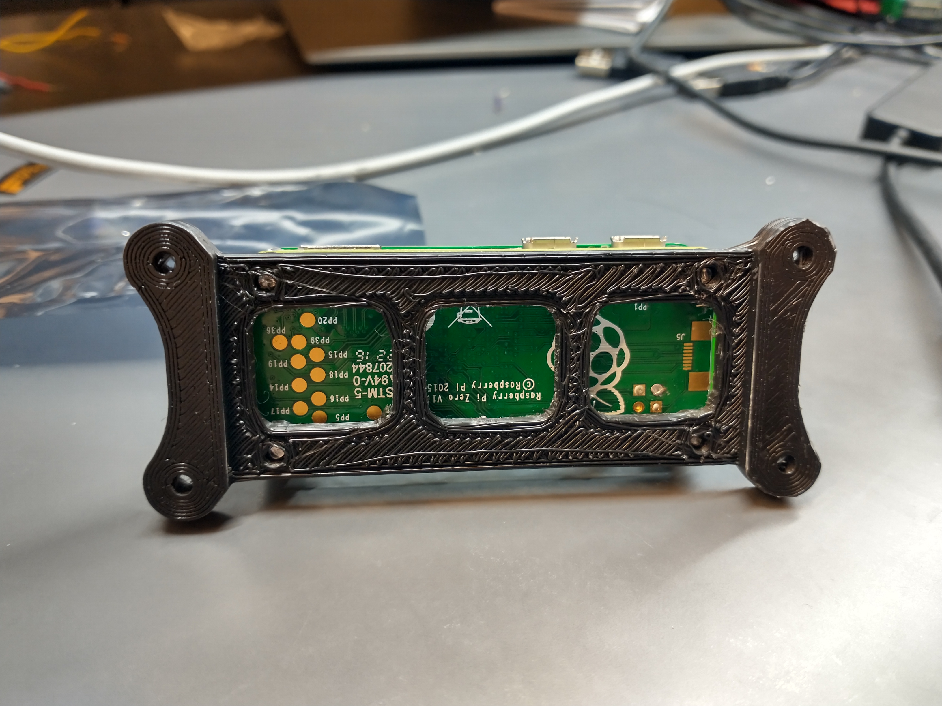
docs/status reports/michael_langford/wk13/Photos-001/IMG_20221116_114551532_HDR.jpg
