michaellangford99/ECE47700/docs/status reports/michael_langford/wk13/progress_report_wk13_files/image025.jpg

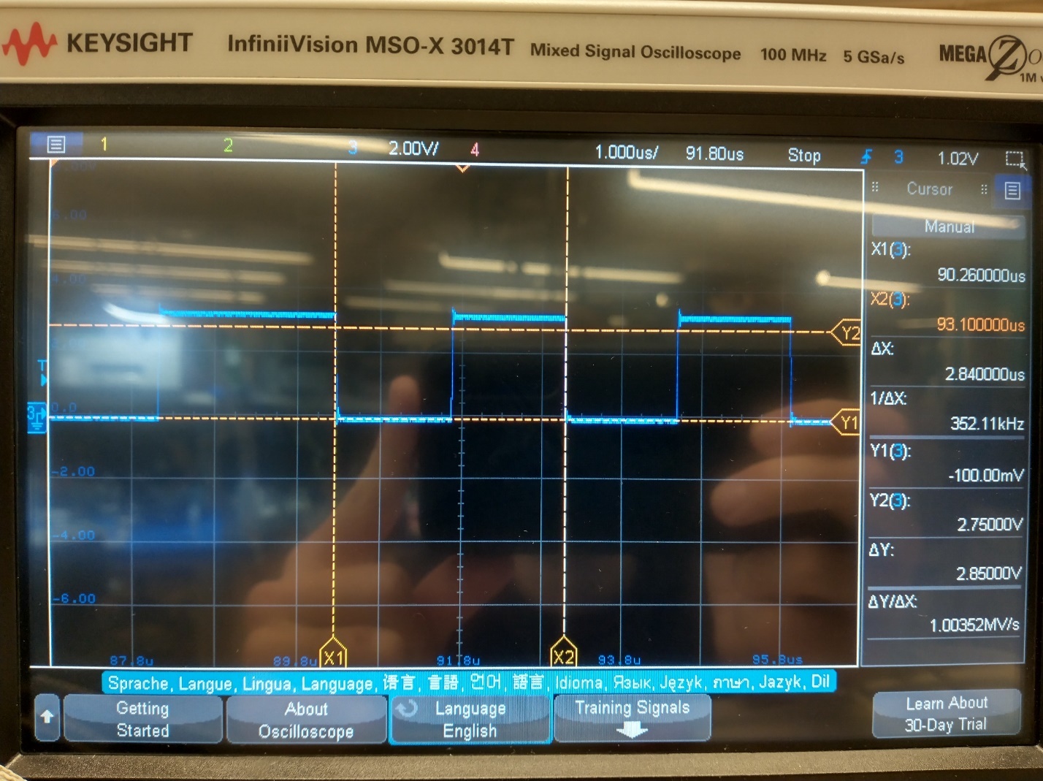
docs/status reports/michael_langford/wk13/progress_report_wk13_files/image025.jpg
