michaellangford99/ECE47700/docs/status reports/michael_langford/wk13/progress_report_wk13_files/image029.png

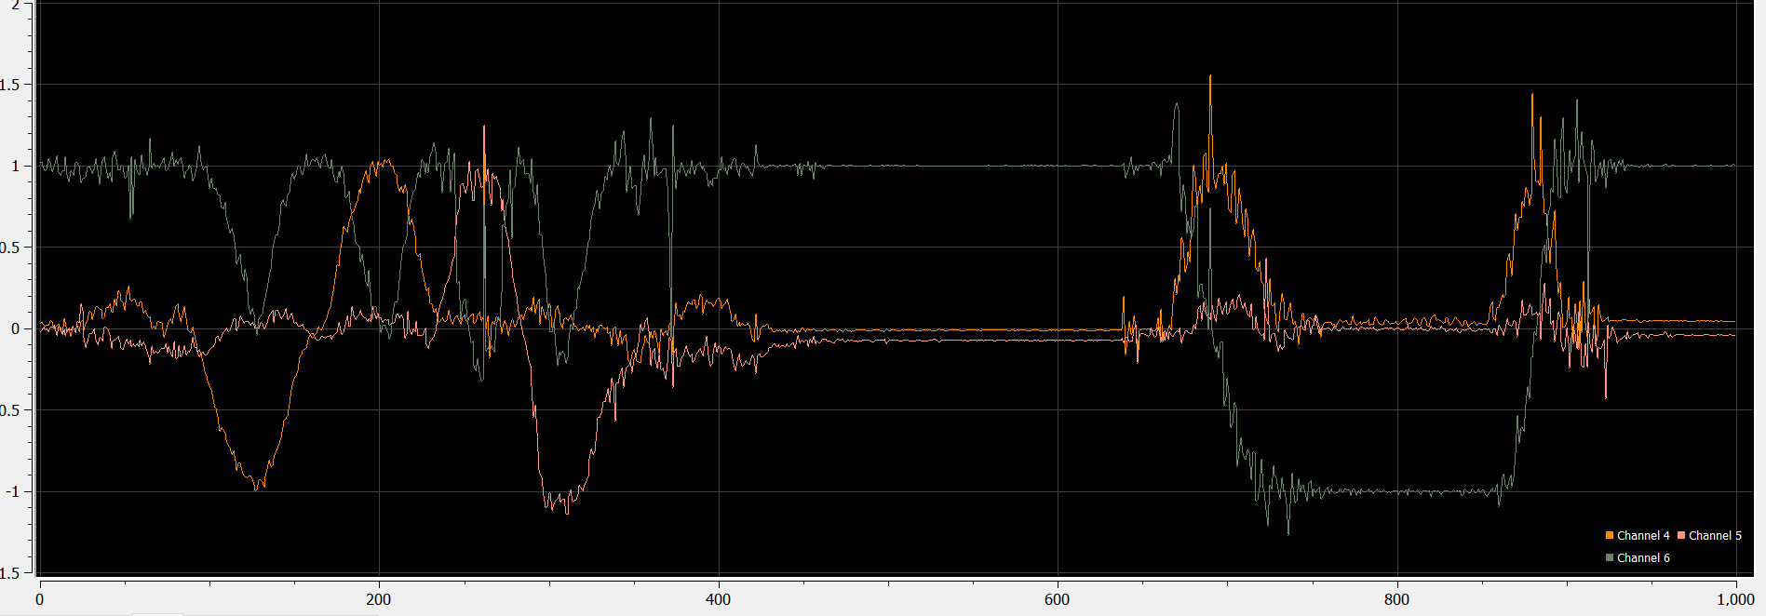
docs/status reports/michael_langford/wk13/progress_report_wk13_files/image029.png
