michaellangford99/ECE47700/docs/status reports/michael_langford/wk15/hanning256.png

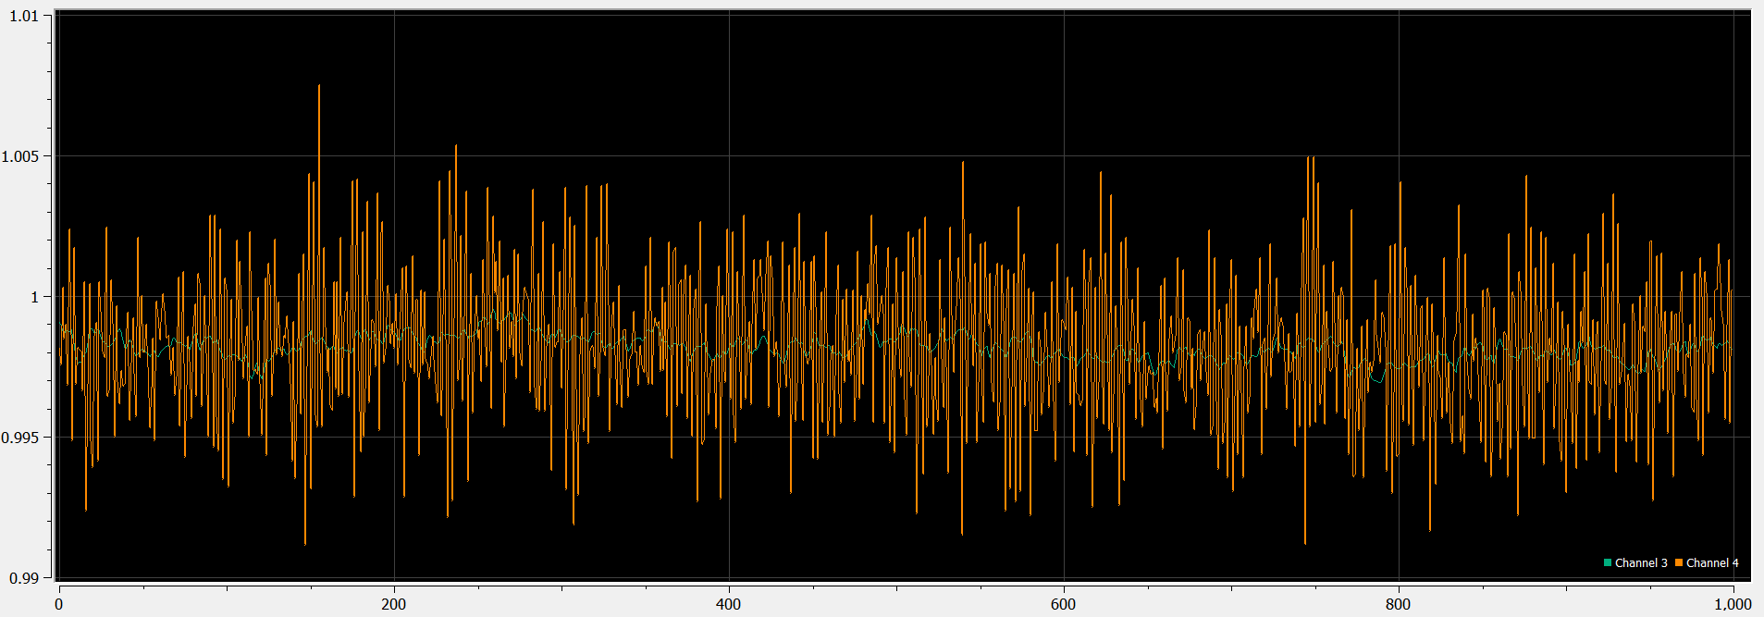
docs/status reports/michael_langford/wk15/hanning256.png
