michaellangford99/ECE47700/docs/status reports/michael_langford/wk15/progress_report_wk15_files/image037.jpg

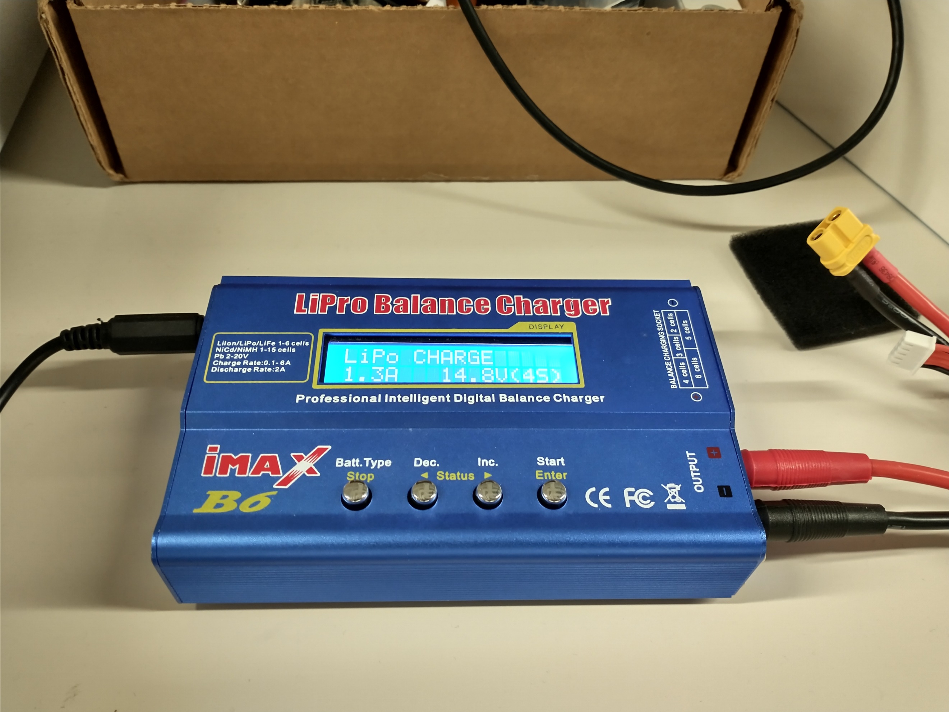
docs/status reports/michael_langford/wk15/progress_report_wk15_files/image037.jpg
