michaellangford99/ECE47700/docs/status reports/michael_langford/wk15/progress_report_wk15_files/image055.png

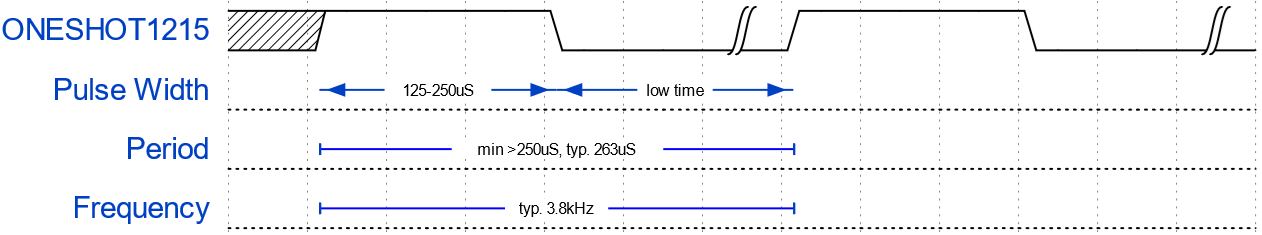
docs/status reports/michael_langford/wk15/progress_report_wk15_files/image055.png
