michaellangford99/ECE47700/docs/status reports/michael_langford/wk15/putty echo.png

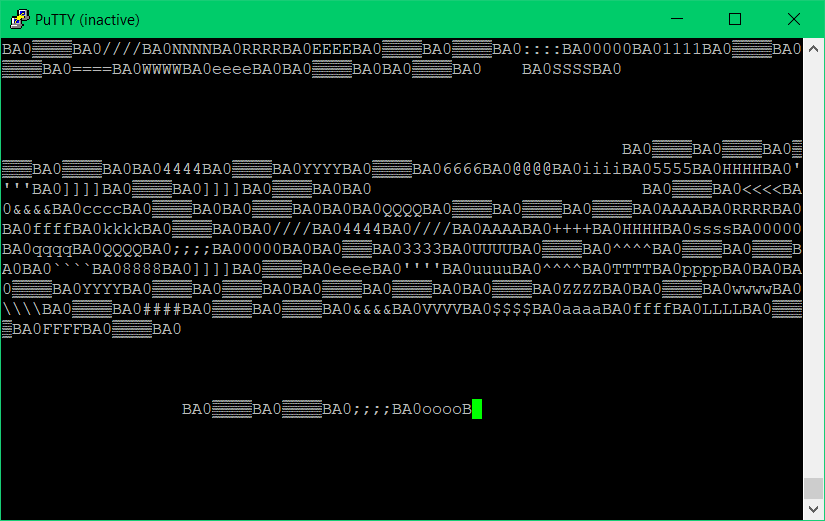
docs/status reports/michael_langford/wk15/putty echo.png
