michaellangford99/ECE47700/docs/status reports/michael_langford/wk15/Screenshot 2022-12-01 173204.png

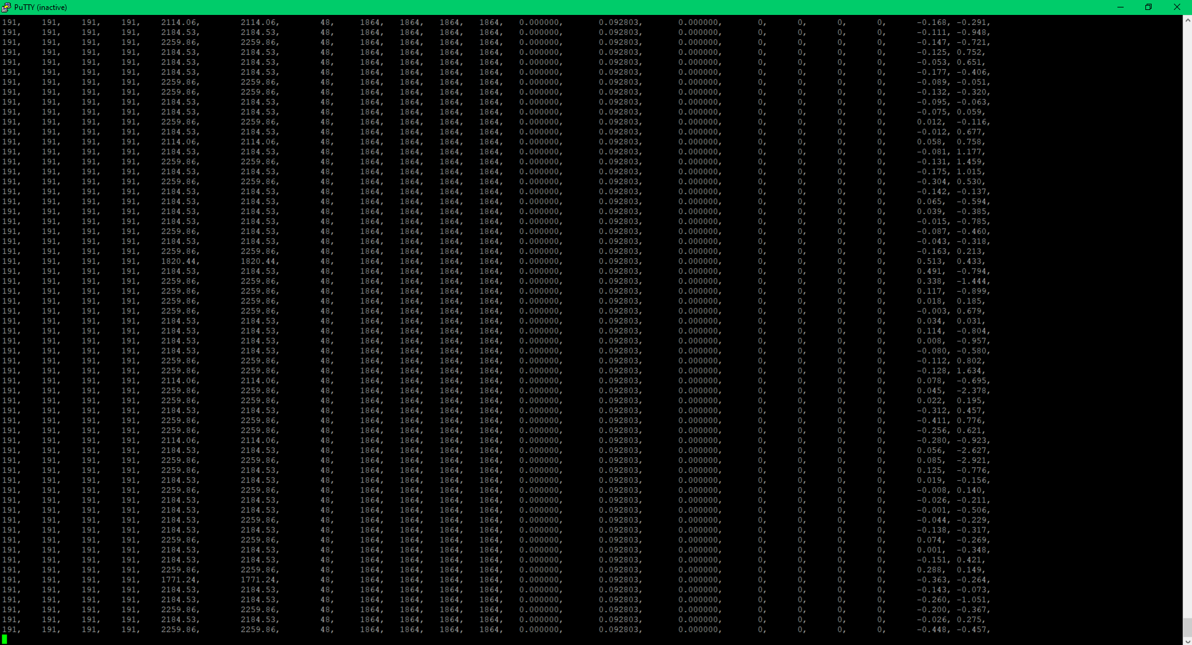
docs/status reports/michael_langford/wk15/Screenshot 2022-12-01 173204.png
