michaellangford99/ECE47700/docs/status reports/michael_langford/wk16/camera and auto working 2.png

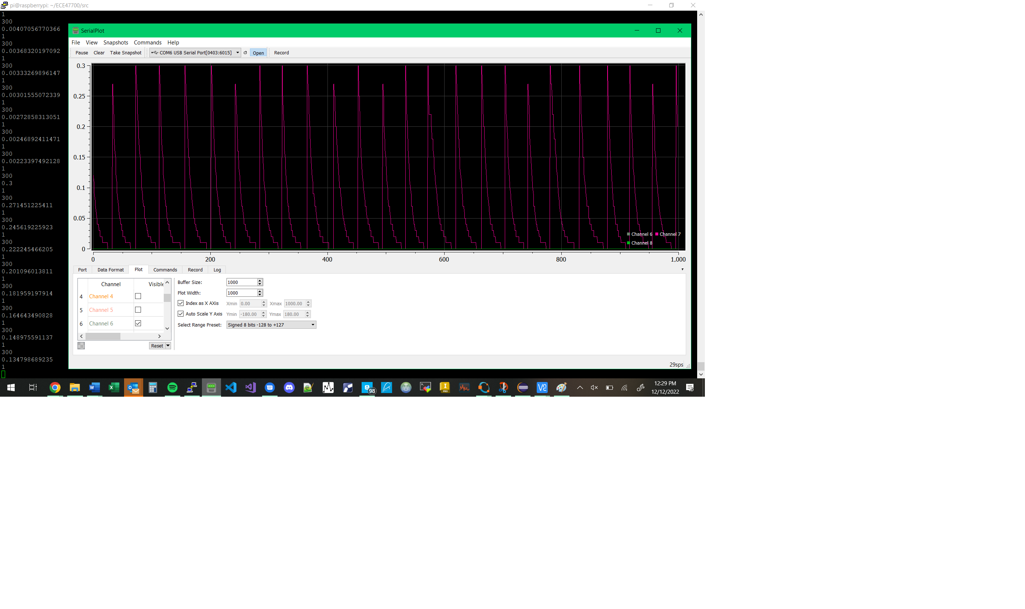
docs/status reports/michael_langford/wk16/camera and auto working 2.png
