michaellangford99/ECE47700/docs/status reports/michael_langford/wk16/img_2022-12-12_16-46-08.jpg

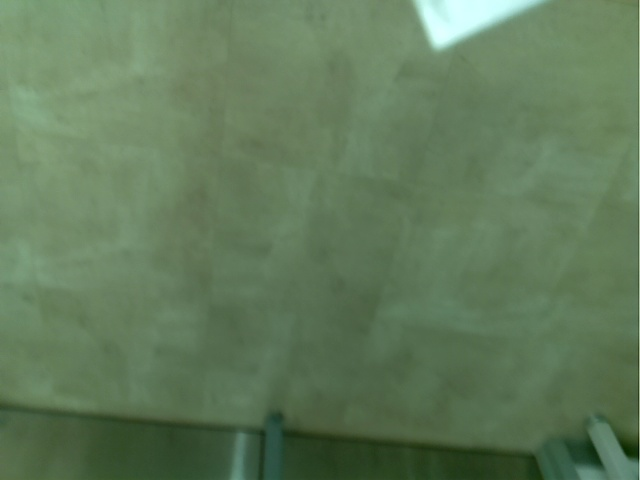
docs/status reports/michael_langford/wk16/img_2022-12-12_16-46-08.jpg
