michaellangford99/ECE47700/docs/status reports/michael_langford/wk16/Photos-001 (2)/IMG_20221202_172928132_HDR.jpg

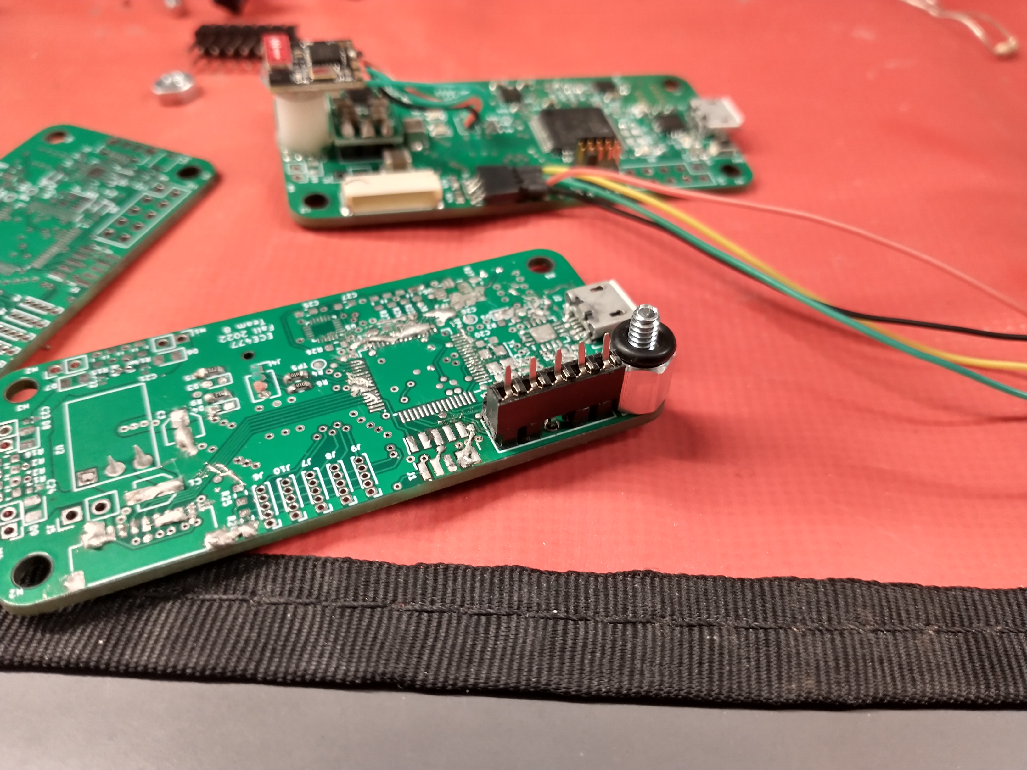
docs/status reports/michael_langford/wk16/Photos-001 (2)/IMG_20221202_172928132_HDR.jpg
