michaellangford99/ECE47700/docs/status reports/michael_langford/wk16/Photos-001 (2)/IMG_20221205_204329299_HDR.jpg

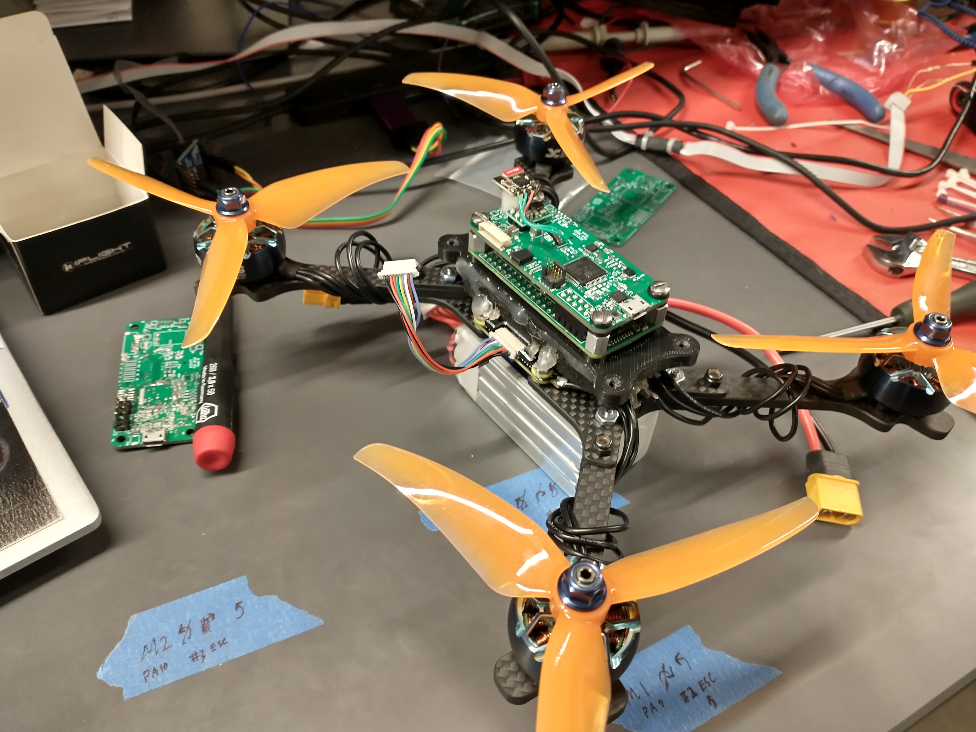
docs/status reports/michael_langford/wk16/Photos-001 (2)/IMG_20221205_204329299_HDR.jpg
