michaellangford99/ECE47700/docs/status reports/michael_langford/wk16/progress_report_wk16_files/image017.jpg

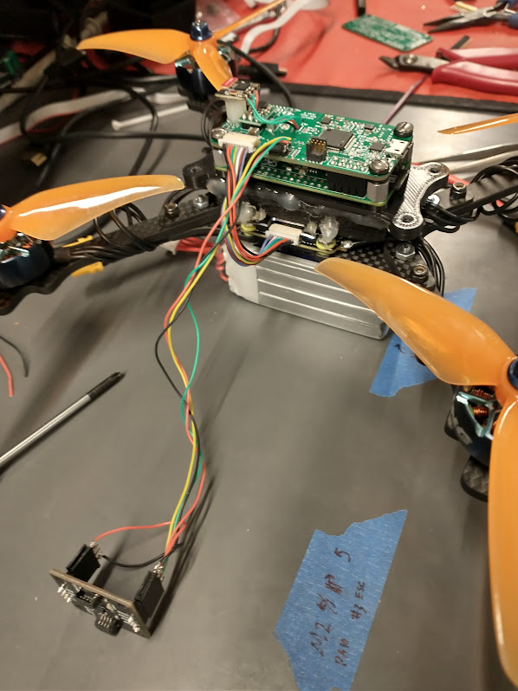
docs/status reports/michael_langford/wk16/progress_report_wk16_files/image017.jpg
