michaellangford99/ECE47700/docs/status reports/michael_langford/wk16/progress_report_wk16_files/image019.png

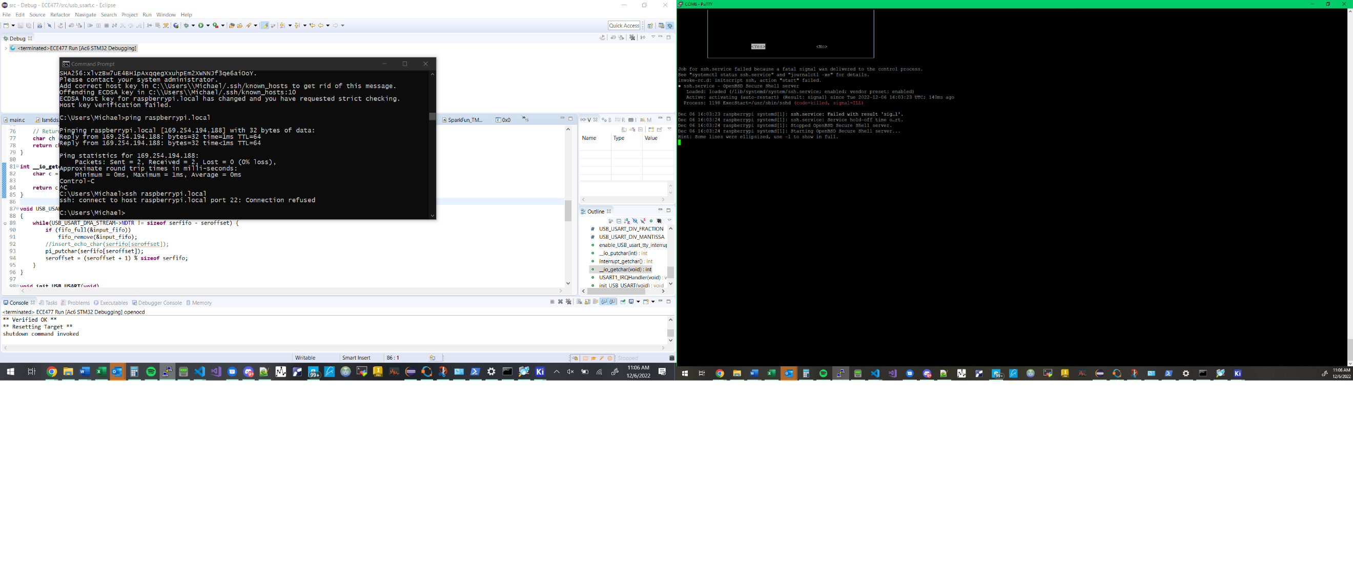
docs/status reports/michael_langford/wk16/progress_report_wk16_files/image019.png
