michaellangford99/ECE47700/docs/status reports/michael_langford/wk16/Screenshot 2022-12-12 123314.png

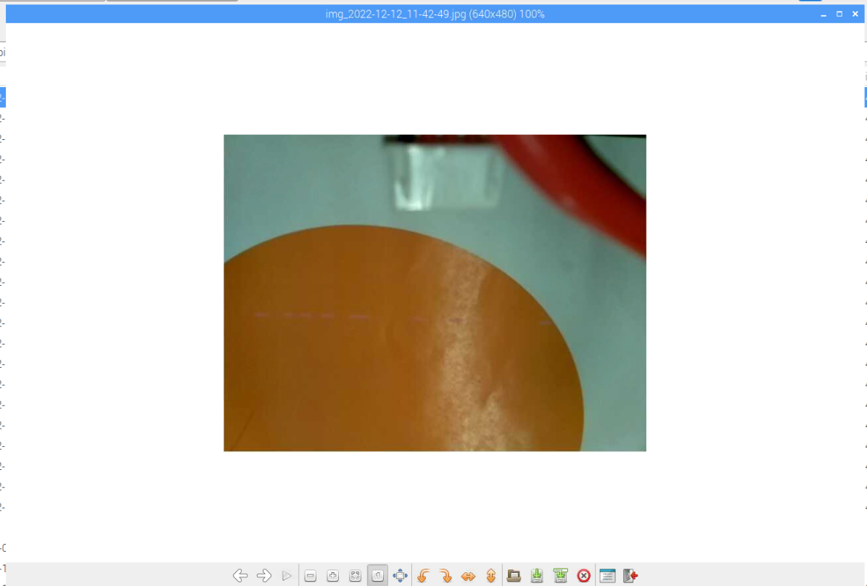
docs/status reports/michael_langford/wk16/Screenshot 2022-12-12 123314.png
