michaellangford99/ECE47700/docs/status reports/michael_langford/wk16/vnc 2.png

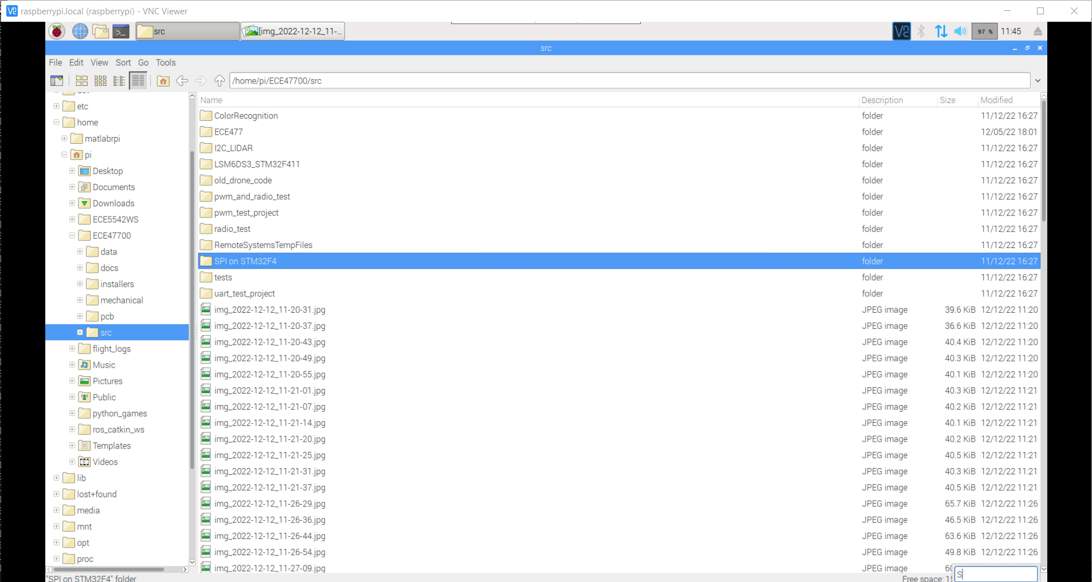
docs/status reports/michael_langford/wk16/vnc 2.png
