michaellangford99/ECE47700/docs/proposal documents/Bill of Materials.xlsx

ECE477 Bill of Materials v1.0
Year: | 2022 | Semester: |  | Fall | Project Name: | Hermes
Author: | Michael Langford
Created: | 2022-09-24
Last Modified: | 2022-10-12
Project_Component |  |  |  |  |  |  |  | Qty:
Description | ID | Qty | Value | Package | Manufacturer | Mfg. Part # | Supplier | Supplier Part #
Drone Frame |  | 1 |  |  | RaceDayQuads |  | RaceDayQuads
Propellers |  | 24 |  |  | T-Motor |  | RaceDayQuads
Brushless Motor |  | 4 |  |  | T-Motor |  | RaceDayQuads
LiPo Battery |  | 1 |  |  | RaceDayQuads |  | RaceDayQuads
Brushless ESC |  | 1 |  |  | T-Motor |  | RaceDayQuads
ESC control cable |  | 1 |  |  | T-Motor |  | RaceDayQuads
XT-60 Male connector |  | 1 |  |  |  |  | RaceDayQuads
Pi Zero Micro Camera |  | 1 |  |  | Adafruit |  | Adafruit
Pi Zero |  | 1 |  |  | Raspberry Pi Foundation |  | Adafruit
BetaFPV 2.4GHz ELRS Receiver |  | 1 |  |  | BetaFPV |  | Amazon
Flight controller bare PCB |  | 5 |  |  | me |  | PCBWay
LIDAR ToF Range Sensor bare PCB |  | 1 |  |  | me |  | PCBWay
3D printed PCB mount |  | 1 |  |  | me |  | Purdue
3D printed camera mount |  | 1 |  |  | me |  | Purdue
Micro SD Card |  | 2
0.1uF 2V Cap |  | 1 | 0.1uF 2V | C_0402_1005Metric |  |  | DigiKey
Micro SD Card Slot |  | 1 | Micro_SD_Card_Det | microSD_HC_Hirose_DM3D-SF | Hirose |  | DigiKey
LSM6DSL IMU |  | 1 | LSM6DSL | InvenSense_QFN-24_4x4mm_P0.5mm | ST Microelectronics |  | WinSource
2K Resistor |  | 2 | 2K | R_0603_1608Metric |  |  | DigiKey
STM32F446RET6 |  | 1 | STM32F446RETx | LQFP-64_10x10mm_P0.5mm | ST Microelectronics |  | WinSource
FT230XQ |  | 1 | FT230XQ | QFN-16-1EP_4x4mm_P0.65mm_EP2.5x2.5mm | FTDI Inc. |  | WinSource
220 Resistor |  | 1 | 220 | R_0603_1608Metric |  |  | DigiKey
IRLML6244TR |  | 4 | IRLML6244TR | SOT-23_Handsoldering | Infineon |  | DigiKey
12pF Cap |  | 2 | 12pF | C_0603_1608Metric |  |  | DigiKey
4.7K Resistor |  | 6 | 4.7K | R_0603_1608Metric |  |  | DigiKey
Motor Controller connector |  | 1 |  | PinHeader_1x08_P1.25mm_Vertical |  |  | DigiKey
USB Micro B connector |  | 1 | USB_B_Micro | USB_Micro-B_Molex_47346-0001 | Molex |  | DigiKey
10V Diode |  | 4 | 10V | D_0805_2012Metric |  |  | DigiKey
1uF Cap |  | 2 | 1uF | C_0603_1608Metric |  |  | DigiKey
2.2uF Cap |  | 1 | 2.2uF | C_0603_1608Metric |  |  | DigiKey
4.7uF Cap |  | 1 | 4.7uF | C_1210_3225Metric |  |  | DigiKey
Indicator LED |  | 2 |  | LED_0603_1608Metric |  |  | DigiKey
Brushed DC Motor connector |  | 4 |  | PinHeader_1x02_P2.00mm_Vertical |  |  | DigiKey
33 Resistor |  | 4 | 33 | R_0603_1608Metric |  |  | DigiKey
4.7k Resistor |  | 2 | 4.7k | R_0603_1608Metric |  |  | DigiKey
1K Resistor |  | 1 | 1K | R_0603_1608Metric |  |  | DigiKey
Reset button |  | 1 | SW_Push | SW_SPST_B3U-1000P |  |  | DigiKey
100uF Resistor |  | 1 | 100uF | C_Elec_3x5.4 |  |  | DigiKey
10nF Resistor |  | 1 | 10nF | C_0603_1608Metric |  |  | DigiKey
AMS1117-3.3 LDO regulator |  | 1 | AMS1117-3.3 | SOT-223-3_TabPin2 |  |  | DigiKey
Radio receiver connector |  | 1 |  | PinHeader_1x03_P1.25mm_Vertical |  |  | DigiKey
30K Resistor |  | 1 | 30K | R_0603_1608Metric |  |  | DigiKey
100K Resistor |  | 1 | 100K | R_0603_1608Metric |  |  | DigiKey
SWD header |  | 1 |  | PinSocket_2x05_P1.27mm_Vertical_SMD |  |  | DigiKey
16MHz Crystal |  | 1 | 16MHz X322516MLB4SI | Crystal_SMD_3225-4Pin_3.2x2.5mm |  |  | DigiKey
22 Resistor |  | 1 | 22 | R_0402_1005Metric |  |  | DigiKey
0.1uF Capacitor |  | 4 | 0.1uF | C_0402_1005Metric |  |  | DigiKey
0.1uF 4V Capacitor |  | 1 | 0.1uF 4V | C_0402_1005Metric |  |  | DigiKey
100nF Capacitor |  | 2 | 100nF | C_0402_1005Metric |  |  | DigiKey
10nF, 4V Capacitor |  | 1 | 10nF, 4V | C_0402_1005Metric |  |  | DigiKey
2.2nF, 50V Capacitor |  | 1 | 2.2nF, 50V | C_0805_2012Metric |  |  | DigiKey
5V Step-Up/Step-Down Voltage Regulator |  | 1 | S7V7F5 | PinHeader_1x03_P2.54mm_Vertical | Pololu | 2119 | Pololu | 2119 | https://www.pololu.com/product/2119
VL53L1X LIDAR ToF range sensor |  | 5 | VL53L1X | special | ST Microelectronics |  | Mouser
