michaellangford99/ECE47700/docs/Requirements.xlsx

Sheet: Overall
The success of the project will be determined by the following:
1. An ability to read axis channel values from incoming signal from off the shelf radio receiver (via PPM)
2. An ability to send and receive navigation command and IMU sensor data between an onboard single-board computer and flight controller microcontroller
3. An ability to send signals to a motor controller and control speed of all 4 motors simultaneously (via DSHOT)
4. An ability to communicate with and read sensor data off a gyroscope & accelerometer (via SPI)
5. An ability to measure distance to walls or floor from LIDAR proximity sensor (vis I2C)
Transmitter | ELRS | Radio Receiver | CRSF | Flight Controller
 |  | Accelerometer | SPI
 |  | Gyroscope | SPI
Battery | 3.7V | 5V boost | Power
 |  | 3.3V regulator | Power
 |  | LIDAR | I2C
 |  | Motor Controllers | PWM
 |  | or ESC | DSHOT
 |  | Navigation Computer | Serial Frames

Sheet: Schedule
 |  |  | Week 4 | Week 5 | Week 6 | Week 7 | Week 8 | Week 9 | Week 10 | Week 11 | Week 12 | Week 13 | Week 14 | Week 15 | Week 16
Interfacing
 | Protocols
 |  | SPI | 1
 |  | I2C | 1 | 1
 |  | UART | 1 | 1
 |  | PWM | 1 | 1
 |  | Analog Read
 | Drivers
 |  | Motor PWM |  | 1 | 1
 |  | Radio |  | 1 | 1
 |  | MPU9250
 |  | LSM6DSOWTR |  | 1
 |  | ~~ICM20948~~
 |  | VL53L1X
 |  | Pi communication |  | 1
 |  | Battery monitor
 |  | Driver integration
Algorithms
 | Sensor Fusion
 | PID Loop
 | Push to motors
 | Calibration
Prototyping
 | Assemble prototype board
 | Physical drone assembly
 | 3D printed mounts
PCB Design
 | Schematic Design |  | 1 | 1
 | PCB Layout |  |  | 1 | 1 | 1
 | Verify / Order PCB
 | Assemble PCB
 | Unit test PCB hardware
 | Install PCB

Sheet: Purchase Log
Description | Vendor | Date | Cost
Chips | LCSC | 2022-08-31 | $75.23
Sensor & Camera | Adafruit | 2022-09-13 | $75.23
Frame & Motors | RaceDayQuads | 2022-09-12 | $189.17
Connectors | Newark | 2022-10-04 | $13.73
Batteries | RaceDayQuads | 2022-10-11 | $76.23
Voltage regulators | Pololu | 2022-10-13 | $27.61
Anti-Vibration mounts | RaceDayQuads | 2022-11-24 | $15.27
LiDAR Sensors | Adafruit | 2022-11-26 | $55.48
TOTAL |  |  | -$527.95
Budget |  |  | $450.00
Remaining |  |  | -$77.95

Sheet: Micro_Software
safety features are paramount
arming procedure can't somehow happen with stuff disconnected
configurable debug data controlled via #defines in software so easily changeable
all configuration parameters and constants stored in NVM (prefereably with a CRC)
SPI based high speed comms,
comms with PI can be I2C
if this micro also has to control gimbal, it should be aware of loop time
blackbox nice
switch mode power supply modules allowed as final hardware
task breakdown
ppm driver
ppm reciever
spi driver
i2c driver
serial driver |  |  |  | Drivers Needed
filtering testbench |  |  |  | UART DMA
dsp acceleration |  |  |  | SPI DMA
 |  |  |  | I2C DMA
 |  |  |  | PWM DMA
prototyping first tasks
get simple driver with servo (PWM) |  |  |  | CRSF
look at clock tree setup to ensure fastest clock speed |  |  |  | MPU9250
 |  |  |  | ST acc/gyro
USART clock speed calculation |  | PWM PSC & ARR |  | LIDAR
baudrate | 420000 | period | 0.0025 | DSHOT
Fclk | 16000000 | Fclk | 16000000
USARTDIV | 2.38 | freq | 400
DIV_Fraction | 6.10 | PSC | 1
DIV_Mantissa | 2.00 | ARR | 19999.00
 |  | freq_out | 400
working backwards: |  | period_out | 0.0025
USARTDIV | 2.38 | period_ms | 2.5
Fclk | 15993600
Referenced sources:
tty.h, tty.c
fifo.c, fifo.h

Sheet: Weight-Power-Size Constraints
Minimum Flight Time | 120 | seconds
frame weight | 100 | grams | https://www.racedayquads.com/products/rdq-source-one-v3-5-freestyle-frame?variant=29592522293361
motor weight | 126.4 | grams | https://www.racedayquads.com/products/iflight-xing2-2306-2555kv-motor
propellers | 4 | grams | https://www.racedayquads.com/products/t-motor-t5147-popo-compatible-tri-blade-5-prop-4-pack-choose-your-color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
4in1 ESC weight | 21 | grams | https://store.tmotor.com/goods.php?id=1014
radio reciever | 2 | grams
single-board computer | 10 | grams | pi zero
flight controller | 20
camera | 4 |  | https://www.adafruit.com/product/3099
Typical 4S 1200mAh battery | 164 | grams
additional wiring | 20 | grams
total weight | 471.4 | grams |  | -15.96359737 | 0.1591549431
 |  |  |  | -18.97389732 | 0.1125395395
thrust from chosen 2306 brushless | 1526 | grams |  | 3.010299957 | 1.414213562 | 2
amps at above thrust | 51.3 | A
amp/g thrust | 0.03361730013 | A/grams |  | Supply | Device | Current Typ [mA] | Current Min [mA] | Current Max [mA]
 |  |  |  | 4S Battery | Motor controller(ESC) | 400 | 400 | 400
total thrust necessary | 1414.2 | grams (3x drone weight) |  |  | Motors | 26000 | 13000 | 38000
thrust per motor | 353.55 | grams |  |  | 10V Supply | 439.6 | 184.2 | 567.6
current at given thrust | 11.88539646 | A |  | 10V Supply | 5V Supply | 424.6 | 169.2 | 552.6
processor and nav current | 1 | A |  |  | Power LED | 15 | 15 | 15
total current | 48.54158585 | (4x motor current, +FC current) |  | 5V Supply | Radio Receiver | 3.4 | 3.4 | 3.4
 |  |  |  |  | Pi Zero | 200 | 50 | 250
hours of flight time | 0.03333333333 | h |  |  | Camera | 100 | 50 | 150
 |  |  |  |  | Power LED | 15 | 15 | 15
mAh necessary | 1618.052862 | mAh |  |  | 3.3V Supply | 106.2 | 50.8 | 134.2
 |  |  |  | 3.3V Supply | STM32 Microcontroller | 80 | 30 | 100
 |  |  |  |  | LSM6DSR 6-axis IMU | 1.2 | 0.8 | 1.2
micro options: |  |  |  |  | FT230XQ UART to USB | 8 | 5 | 8
Minimum Flight Time | 120 | seconds |  |  | Power LED | 15 | 15 | 15
 |  |  |  |  | RX/TX LED | 2 | 0 | 10
frame weight | 14 | grams | http://www.planfab.eu/ | Total Current [mA] |  | 26839.6 | 13584.2 | 38967.6
motor weight | 19.6 | grams |  | Total Current [A] |  | 26.84 | 13.58 | 38.97
propellers | 1.2 | grams
4in1 ESC weight | 0 | grams
radio reciever | 2 | grams
single-board computer | 10 | grams
flight controller | 10
camera | 4
Typical 4S 1200mAh battery | 15 | grams
additional wiring | 10 | grams
total weight | 85.8 | grams
thrust from chosen 2306 brushless | 35 | grams
amps at above thrust | 2.7 | A
amp/g thrust | 0.07714285714 | A/grams
total thrust necessary | 257.4 | grams (3x drone weight)
thrust per motor | 64.35 | grams
current at given thrust | 1.654714286 | A
processor and nav current | 2 | A
total current | 8.618857143 | (4x motor current, +FC current)
hours of flight time | 0.03333333333 | h
mAh necessary | 287.2952381 | mAh

Sheet: BOM
Mechanical | Count | Price
drone frame | 1 |  | https://www.racedayquads.com/products/rdq-source-one-v3-5-freestyle-frame?variant=29592522293361
propellers 4 pack | 6 |  | https://www.racedayquads.com/products/t-motor-t5147-popo-compatible-tri-blade-5-prop-4-pack-choose-your-color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
Electrical
battery |  |  | https://www.racedayquads.com/products/rdq-series-15-2v-4s-550mah-100c-lihv-battery-xt30 |  | https://www.racedayquads.com/products/rdq-series-14-8v-4s-1300mah-100c-lipo-battery-3-pack-xt60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
motors |  |  | https://www.racedayquads.com/products/iflight-xing2-2306-2555kv-motor
4in1 ESC |  |  | https://www.racedayquads.com/products/t-motor-velox-45a-32bit-3-6s-30x30-4in1-esc-1?variant=32293091115121 | pi zero
radio reciever
flight controller PCB
flight controller microcontroller
flight controller sensors and components
navigation computer single board computer
camera |  |  | https://www.adafruit.com/product/3099
IMU devices

Sheet: Pi Setup
Install image on SD Card
create 'ssh' file in root directory
add this to end of config.txt | dtoverlay=dwc2
add this directly after rootwait in cmdline.txt | modules-load=dwc2,g_ether
https://desertbot.io/blog/ssh-into-pi-zero-over-usb
May need to manually change DNS to 8.8.8.8
To generate new username and password
create file 'userconf.txt'
generate password on linux machine via: | echo 'enter password here' | openssl passwd -6 -stdin
take that encrypted text and paste into userconf.txt: | desiredusername:encryptedtext
sudo raspi-config
enable vnc, camera
ssh ip: 128.46.96.237
not sure username/psswrd tho

Sheet: PCB
General Requirements | Power Supply |  |  | overall electrical blocks |  | excellent power conditioning circuitry
 | switched mode power input, take from 15V+ to <6V |  |  | battery |  | power monitoring
spacious layout | LDO from 6V to 5V |  |  | ESC / BEC |  | redundancy / robustness
simple | LDO from 5V to 3.3V |  |  | motors |  | secure pin and connectors
hand solderable, all components | LDO from 3.3V to 1.8V |  |  | flight controller |  | safe power up sequence
no bga | low current indicator LED for each regulator |  |  | nav computer |  | test points
form factor not a big matter, needs to be relatively small but not that bad | 150uF total bulk capacitance for battery input and 3.3V |  |  | camera |  | debug ports
 | 100uF total bulk for 1.8V? |  |  |  |  | optional breakout connectors
SD card or external nvm |  |  |  | flight controller |  | vibration damping mounting ability
no onboard programmer | IMU options |  |  |  | switching power supply | extra GPIO pins
simple programmer connection | ISM330DHCXTR |  |  |  | esp8266 remote serial | support HSE and HSI
offload externa complexity | LSM6DSL |  |  |  | pwm to motors
USB is a want, with serial interface, but not a need | ICM20948 |  |  |  | imu SPI
power conditioning important | MPU6050 |  |  |  | imu power
CPU hopefully over 120MHz | MPU9250 |  |  |  | lidar power
ICM20948 IMU | FXOS8700 | FXAS21002 |  |  | lidar
Mounting holes, 4 corners |  |  |  |  | usb connector
power over USB |  |  |  |  | ft230xq
USB FTDI communication | Test PCB pinouts
small F0 for black box if desired | Debug LED | PA13 |  | Put footprint for both chosen and backup IMU on the PCB
SD card either slot or solder-in | USB UART | UART1 | PB7 RX, PB6 TX | and their respective support circuitry and supply voltages
battery and indicator LEDs
switched mode power supply then regulated via LDO to 3.3V |  |  |  | PARTS TO VERIFY
LDO 1.8V for ICM20948 | existing mistakes in board |  |  | Reset button
nothing smaller than 0805 if we want to use theirs | RX and TX wires for UART are crossed |  |  | Crystal
hand solderable | programming connector wires reversed |  |  | caps for crystal
extra peripherals broken out | programming connector orientation not desireable |  |  | regulator
programming header for ST-link | reset button not great |  |  | imu
labelled peripherals |  |  |  | imu
wide board traces for power |  |  |  | esc connector
all connectors at board edge |  |  |  | usb connector
single sided population |  |  |  | board mounting hole clearance
battery voltage detection
communication between boards
level shifter for SBC to microcontroller
servo outputs
USB connectors should have through hole mountings or large solder pads for strength
use programmer from lab
watch out for crystal pinouts being weird
programming header try pogo pin / quick connect thingy

Sheet: PCB_JLC
Mounting holes, 4 corners
power over USB
USB FTDI communication
DSMX either solder on space or connector
SD card either slot or solder-in
MPU9250
battery and indicator LEDs
Motor outputs
small, precise form factor
nothing smaller than 0603
hand solderable
extra peripherals broken out
programming header for ST-link
labelled peripherals
SMD motor pads?
all connectors at board edge
populate both sides
all tall parts on top side
battery voltage detection
communication between boards
radio, eventually onboard
servo outputs
camera input
gps connector
all bottom components easy to solder, simple
or just keep bottom blank and extend board size
actually if we just minimize parts on opposite side to only regulators and caps we can do ourselves that's fine
Keep difficult parts on top such as FT230XQ, put already hand soldering parts on bottom like Vregs and power mosfets
also could put level shifters on bottom as well. Also just use v dividers for CS and SCK?
add a crap ton of 1206 caps of various capacity to bottom of board later
as many as possible are simple
using ICM20948 because MPU6050 has no SPI bus
level shifter IC in use is merely N-channel MOSFET with sufficiently low Gate threshold voltage
switched crystal to 16MHz oscillator referenced in video
Use MPU6050? If it's in stock we might as well deal with lack of SPI bus. Depends on difficulty of I2c implementation.
I2C is 3 wire which works to our advantage. Removes need for Level shifting circuitry and 1.8V parts
parts not in database at all:
ICM20948
tactile reset switch (unless we use an extended part)
SD card connector
USB connector
motor control MOSFET
all connectors
parts not basic:
STM32F446RET6
FT230XQ
1.8V regulator
attempt to group bottom and top motor control outputs together to prevent voltage drop on traces and leave room on right side for digital traces
trying to hook up additional pininto SWD but not sure where it goes yet lol
you will on the next board need to abandon the 1x1.5" form factor to allow for mounting holes and ESC connector blocks
eliminate electrolytic from SMD parts because JLC doesn't have that footprint type in any form factor as basic part.
Also through a but ton of 1210 caps on the bottom of the board so it lies flat
eliminate 10v+ ESD diodes from SMD parts because they don't have any 0805 or similar form factor. Consider switching to a DPAK
next switch over to more commonly used STM32F4
HINT: downloaded script to generate JLCPCB BOM from github. https://github.com/wokwi/kicad-jlcpcb-bom-plugin
change LCSC to LCSC Part # ?
apparently they have neither the FT230XQ nor the STM32F446RET6 in stock… so….
watch out for position/rotation errors
select 'selected location' for JLC part number
I’ll buy current board because I still have parts
next one will be with different MCU and USB chip (maybe)
ESC control circuit for later :PCA9685PW

Sheet: Integration
Ensure each driver works on correct pins for future hardware on the F446 dev board |  |  | Test data
Create and debug full system on f446 |  |  | 5V LED resistor: 2.5V drop
Verify pinouts: |  |  | 3.3V LED resistor: 1V drop
 | IMU SPI
 | LSM6DS3 CS | 1
 | MPU9250 CS
 | PI USART | 1
 | USB USART | 1
 | RX USART | 1
 | LIDAR I2C | sort of
 | Status LED | 1
 | Motor PWM | 1
need max and min definitions on radio channels
need motor output range definitions
channel definitions (ch0 = throttle, etc.)
debug dump at boot of all register and #define evaluated definition
need motor throttle calibration
