michaellangford99/ECE47700/mechanical/raspberry-pi-zero-2.snapshot.9/PiZero/RapberryPiZero.SLDASM

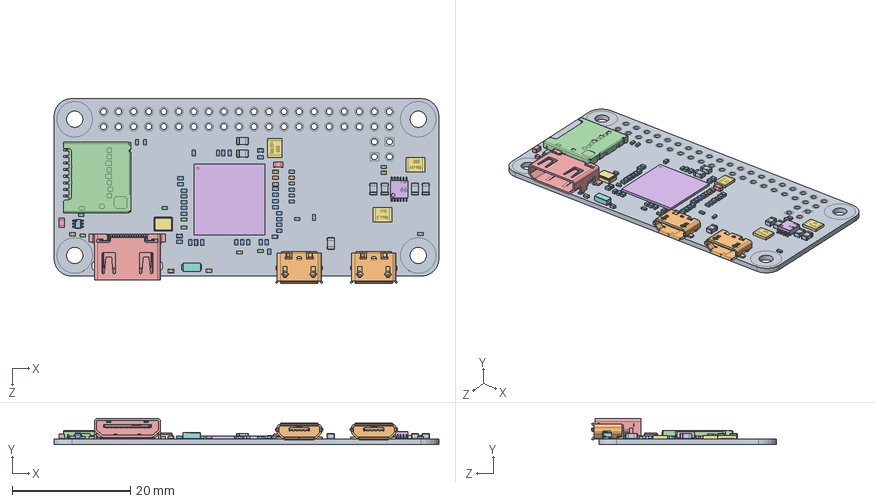
[picture p369: CAD file, 2022-11-10]
mechanical/raspberry-pi-zero-2.snapshot.9/PiZero/RapberryPiZero.SLDASM
65.0 x 4.45 x 31.2 mm
Raspberry_pizero_PCB
Micro USB_input_female (short)-SMT x 2
0204 - Capacitor x 34
0204- Resistor x 17
CAP-0306 x 2
Raspberry_pizero_BCM2835 with VC4
Crystal 3.4x2.4mm
32,768 Khz Crystal
0805- Capacitor x 7
0204 - Capacitor Brown x 8
6-Pin SOT
micro sd molex
hdmi type C
Voltage Regulator 3x3mm 12-Pin
1210 inductor x 3
