michaellangford99/ECE47700/data/5v-step-up-step-down-regulator-s13vxf5/5v-1.5a-step-up-step-down-voltage-regulator-s13v15f5.step

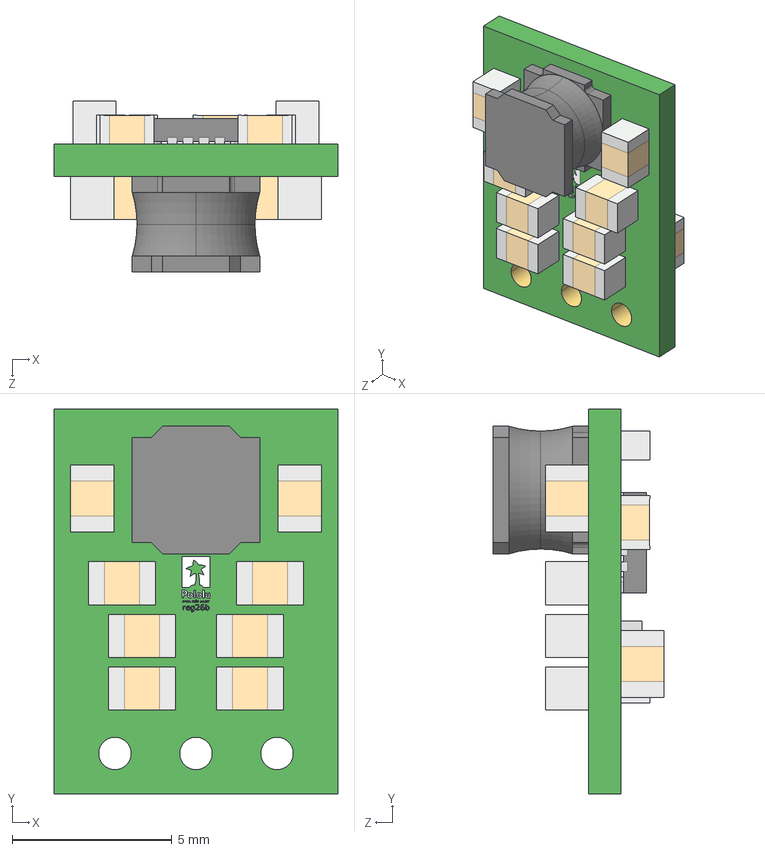
[picture p370: CAD file, 2022-10-27]
data/5v-step-up-step-down-regulator-s13vxf5/5v-1.5a-step-up-step-down-voltage-regulator-s13v15f5.step
8.89 x 12.1 x 5.37 mm
