michaellangford99/ECE47700/data/BM10B-SRSS-TB/BM10B-SRSS-TB.STEP

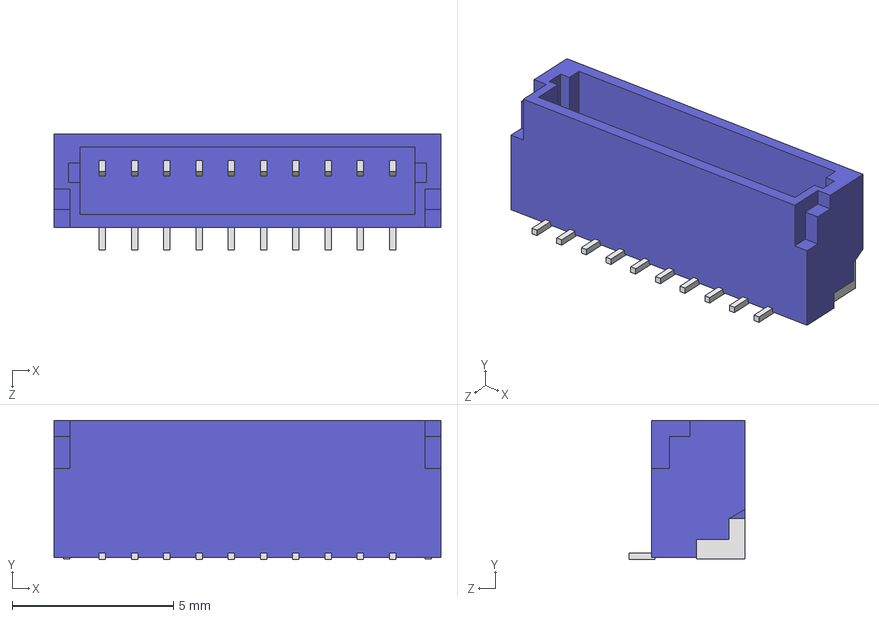
[picture p371: CAD file, 2022-11-29]
data/BM10B-SRSS-TB/BM10B-SRSS-TB.STEP
12.0 x 4.32 x 3.60 mm
