michaellangford99/ECE47700/data/SM10B-SRSS-TB/SM10B-SRSS-TB.STEP

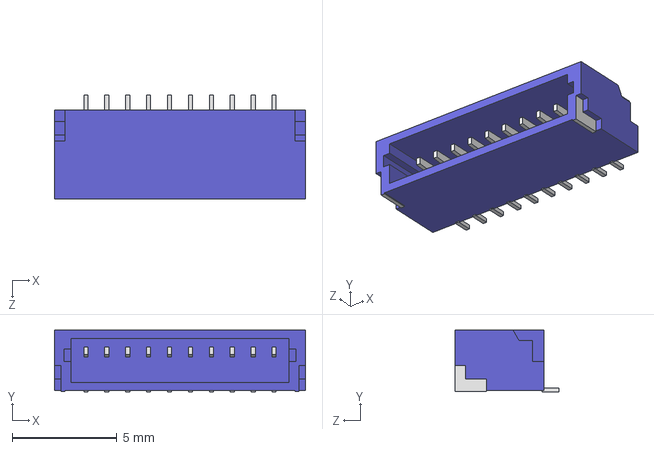
[picture p372: CAD file, 2022-11-29]
data/SM10B-SRSS-TB/SM10B-SRSS-TB.STEP
12.0 x 2.96 x 4.95 mm
