michaellangford99/ECE47700/mechanical/landing_gear_and_lidar_mounts/stls/sidemount2.stl

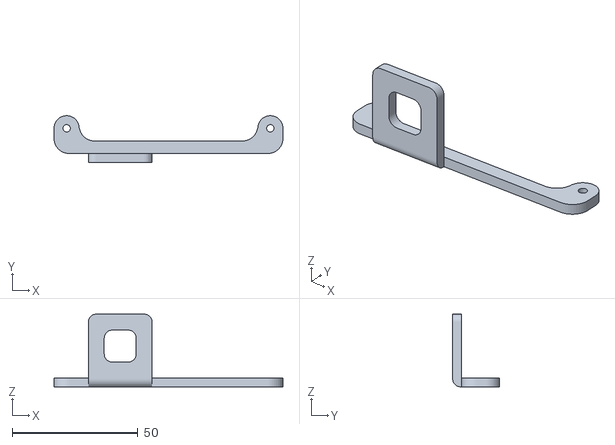
[picture p373: CAD file, 2022-12-16]
mechanical/landing_gear_and_lidar_mounts/stls/sidemount2.stl
91.0 x 18.5 x 28.9
