michaellangford99/ECE47700/mechanical/raspberry-pi-zero-2.snapshot.9/PiZero/32,768 Khz Crystal.SLDPRT

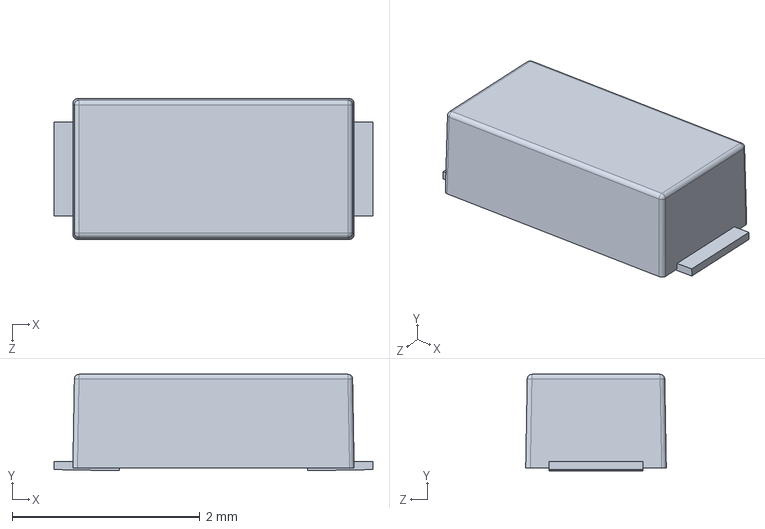
[picture p374: CAD file, 2022-11-10]
mechanical/raspberry-pi-zero-2.snapshot.9/PiZero/32,768 Khz Crystal.SLDPRT
3.40 x 1.03 x 1.50 mm
