michaellangford99/ECE47700/mechanical/raspberry-pi-zero-2.snapshot.9/RapberryPiZero.STL

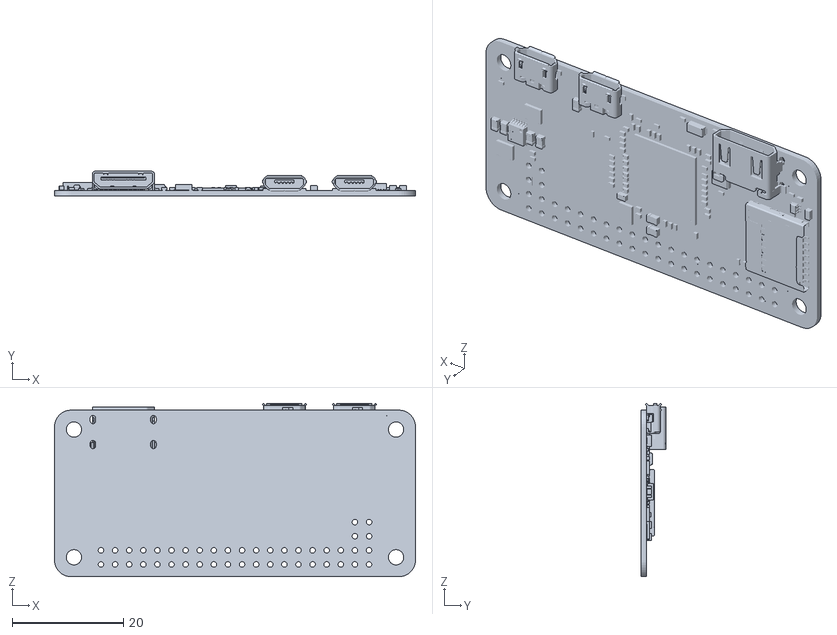
[picture p375: CAD file, 2022-11-10]
mechanical/raspberry-pi-zero-2.snapshot.9/RapberryPiZero.STL
65.0 x 4.45 x 31.2
