michaellangford99/ECE47700/mechanical/SO_v4_5inch_arm_4mm_4x.dxf

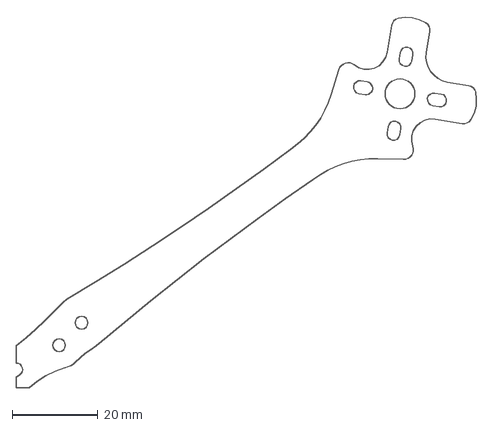
[picture p376: CAD file, 2022-09-15]
mechanical/SO_v4_5inch_arm_4mm_4x.dxf
107.9 x 86.9 mm
