michaellangford99/ECE47700/mechanical/stls/Flight Controller Mount v2.stl

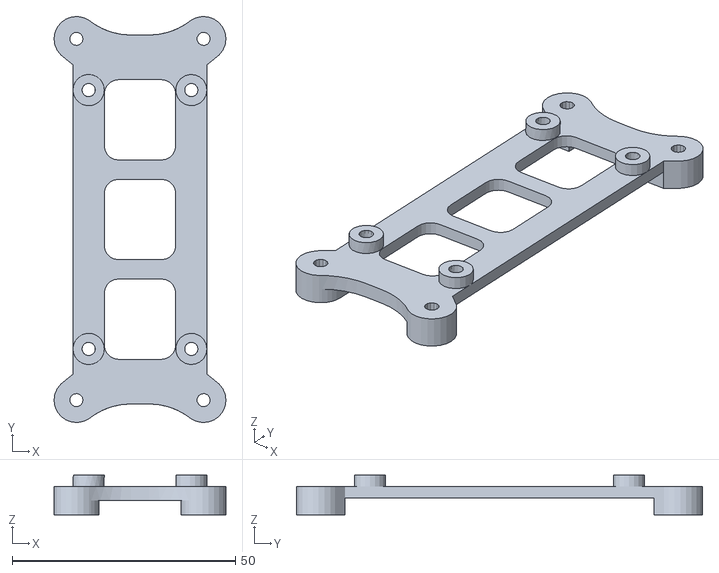
[picture p377: CAD file, 2022-11-18]
mechanical/stls/Flight Controller Mount v2.stl
38.5 x 91.0 x 8.89
