michaellangford99/ECE47700/mechanical/landing_gear_and_lidar_mounts/stls/frontbackmountlidar.stl

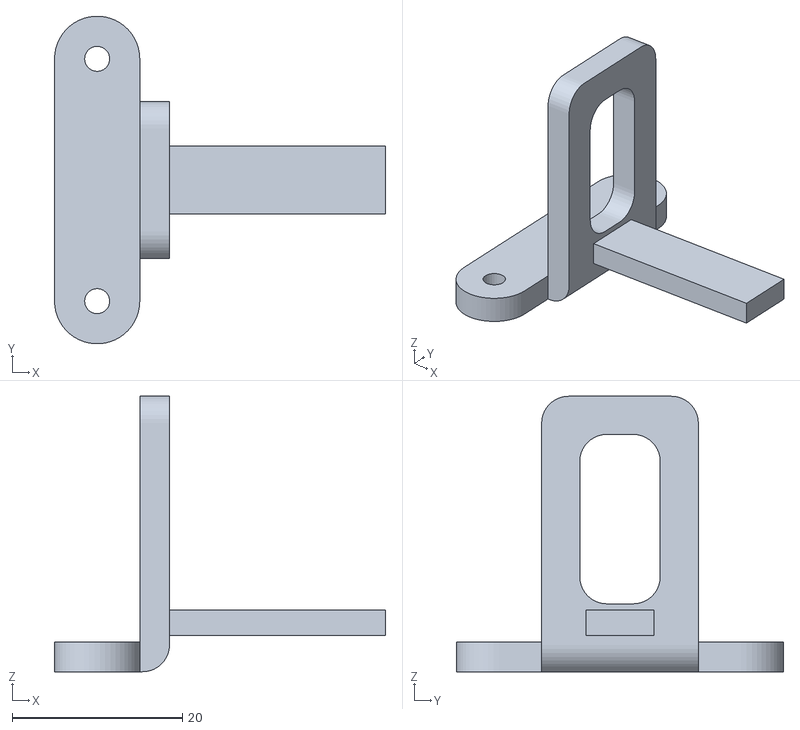
[picture p378: CAD file, 2022-12-16]
mechanical/landing_gear_and_lidar_mounts/stls/frontbackmountlidar.stl
38.9 x 38.5 x 32.4
