michaellangford99/ECE47700/data/5v-step-up-step-down-regulator-s13vxf5/5v-1a-step-up-step-down-voltage-regulator-s13v10f5.step

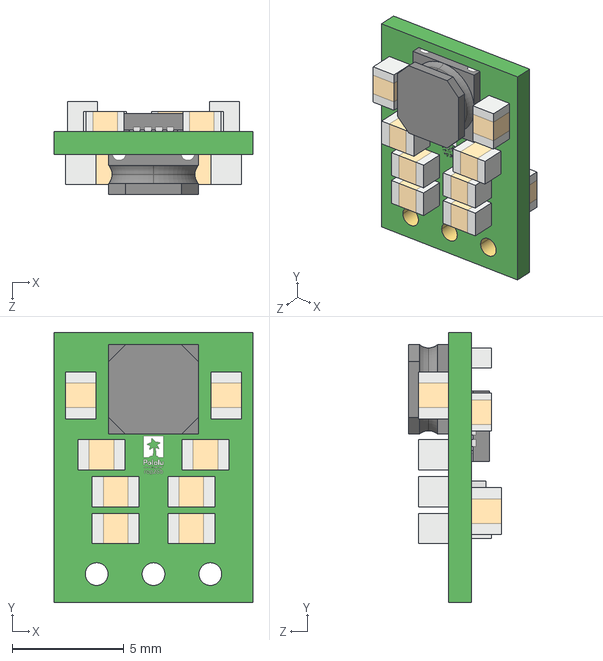
[picture p379: CAD file, 2022-10-27]
data/5v-step-up-step-down-regulator-s13vxf5/5v-1a-step-up-step-down-voltage-regulator-s13v10f5.step
8.89 x 12.1 x 4.17 mm
