michaellangford99/ECE47700/mechanical/landing_gear_and_lidar_mounts/stls/landing.stl

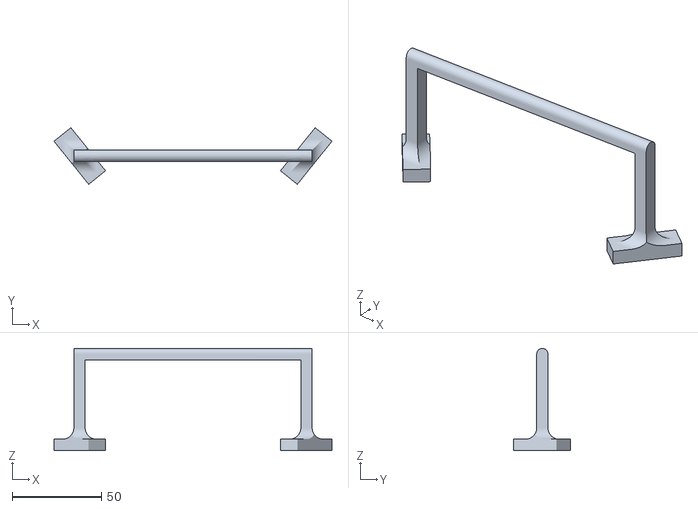
[picture p380: CAD file, 2022-12-16]
mechanical/landing_gear_and_lidar_mounts/stls/landing.stl
155.5 x 31.7 x 57.2
