michaellangford99/ECE47700/mechanical/raspberry-pi-zero-2.snapshot.9/PiZero/0204 - Capacitor Brown.SLDPRT

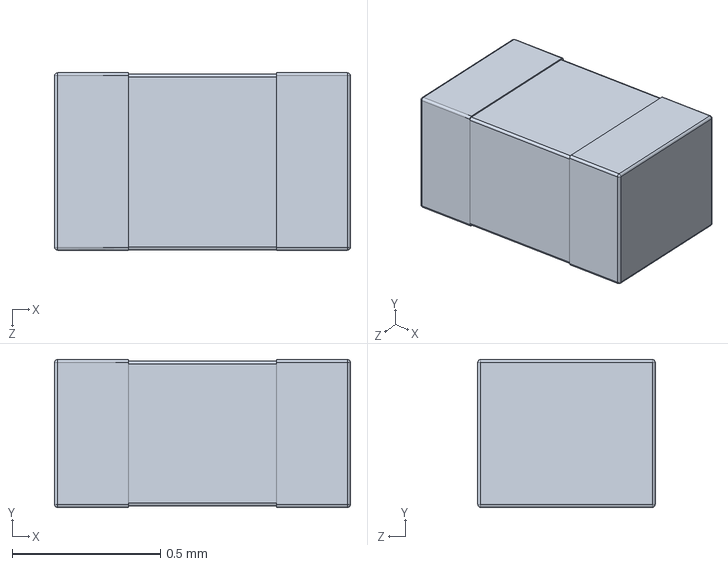
[picture p381: CAD file, 2022-11-10]
mechanical/raspberry-pi-zero-2.snapshot.9/PiZero/0204 - Capacitor Brown.SLDPRT
1.00 x 0.5 x 0.6 mm
