michaellangford99/ECE47700/mechanical/landing_gear_and_lidar_mounts/stls/frontbackmountpi.stl

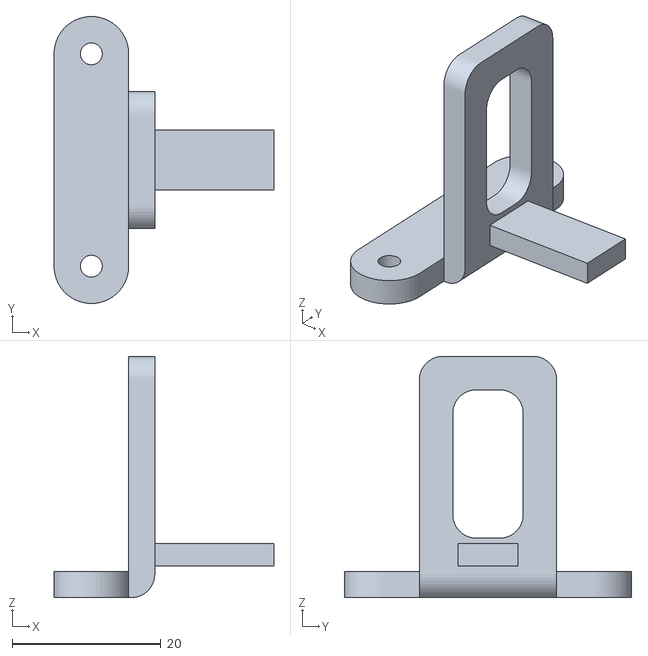
[picture p382: CAD file, 2022-12-16]
mechanical/landing_gear_and_lidar_mounts/stls/frontbackmountpi.stl
29.5 x 38.5 x 32.4
