michaellangford99/ECE47700/mechanical/raspberry-pi-zero-2.snapshot.9/PiZero/CAP-0306.SLDPRT

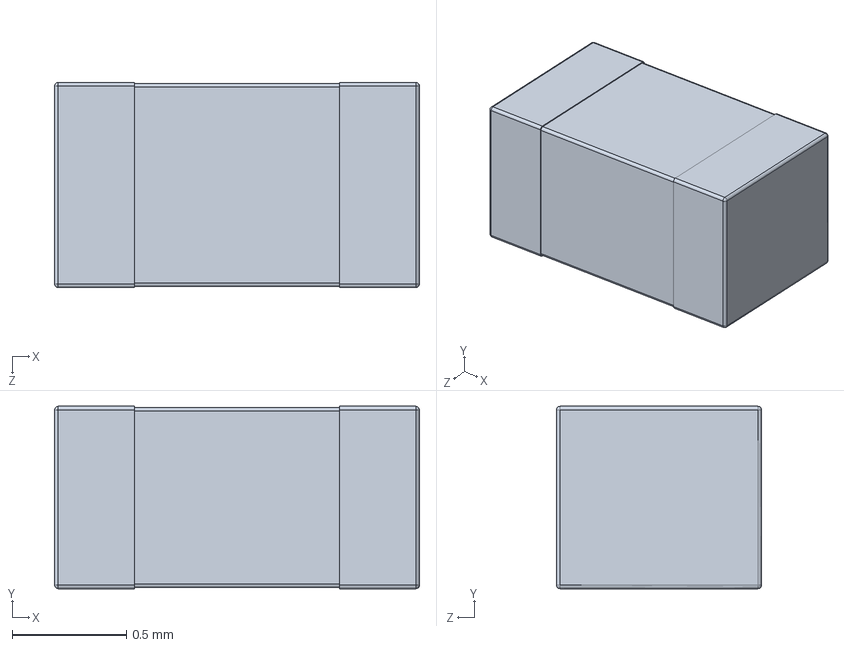
[picture p383: CAD file, 2022-11-10]
mechanical/raspberry-pi-zero-2.snapshot.9/PiZero/CAP-0306.SLDPRT
1.60 x 0.8 x 0.9 mm
