michaellangford99/ECE47700/mechanical/raspberry-pi-zero-2.snapshot.9/PiZero/0805- Capacitor.SLDPRT

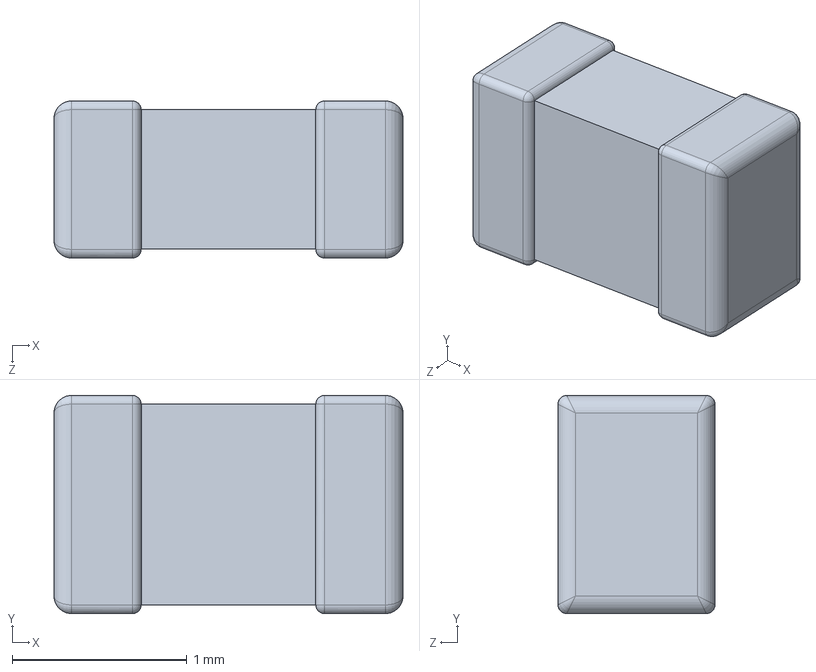
[picture p384: CAD file, 2022-11-10]
mechanical/raspberry-pi-zero-2.snapshot.9/PiZero/0805- Capacitor.SLDPRT
2.00 x 1.25 x 0.9 mm
