michaellangford99/ECE47700/mechanical/landing_gear_and_lidar_mounts/stls/land3.stl

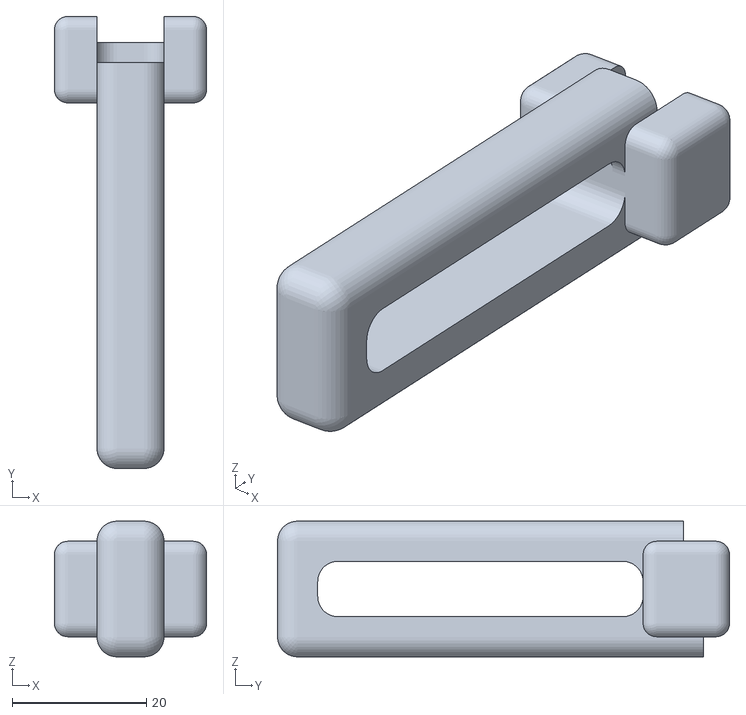
[picture p385: CAD file, 2022-12-16]
mechanical/landing_gear_and_lidar_mounts/stls/land3.stl
22.7 x 67.4 x 20.2
