michaellangford99/ECE47700/mechanical/raspberry-pi-zero-2.snapshot.9/PiZero/Voltage Regulator 3x3mm 12-Pin.SLDPRT

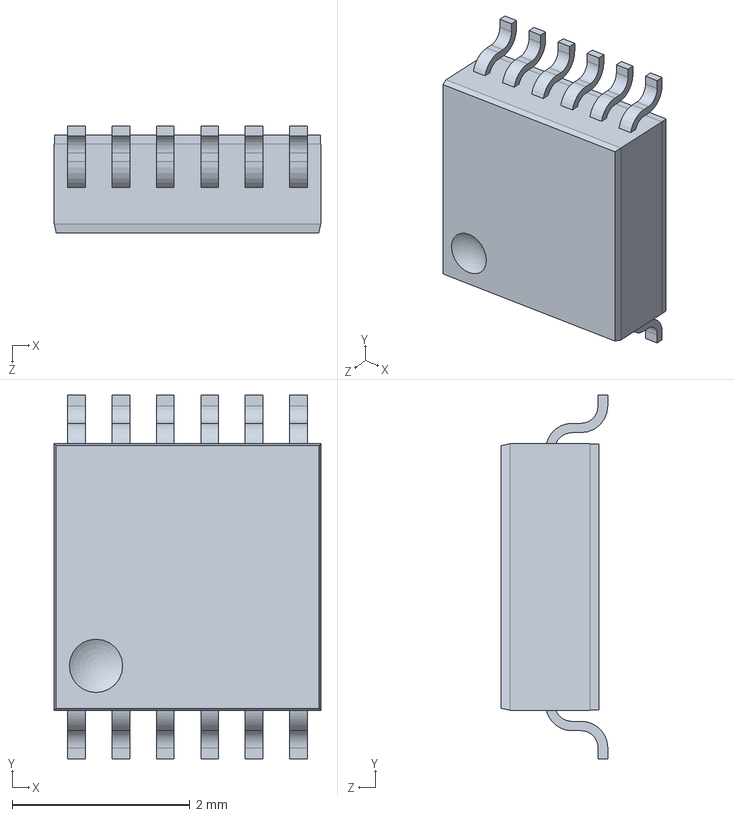
[picture p386: CAD file, 2022-11-10]
mechanical/raspberry-pi-zero-2.snapshot.9/PiZero/Voltage Regulator 3x3mm 12-Pin.SLDPRT
3.00 x 4.10 x 1.20 mm
