michaellangford99/ECE47700/mechanical/raspberry-pi-zero-2.snapshot.9/PiZero/6-Pin SOT.SLDPRT

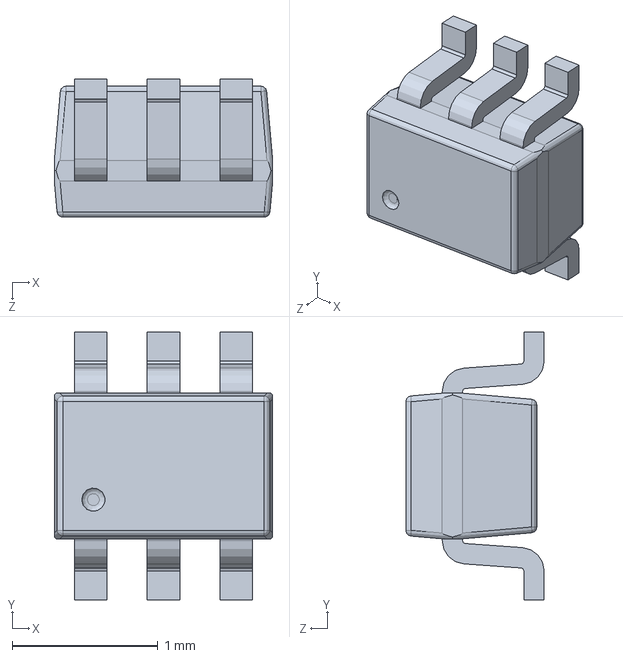
[picture p387: CAD file, 2022-11-10]
mechanical/raspberry-pi-zero-2.snapshot.9/PiZero/6-Pin SOT.SLDPRT
1.50 x 1.84 x 0.95 mm
