michaellangford99/ECE47700/mechanical/raspberry-pi-zero-2.snapshot.9/PiZero/1210 inductor.SLDPRT

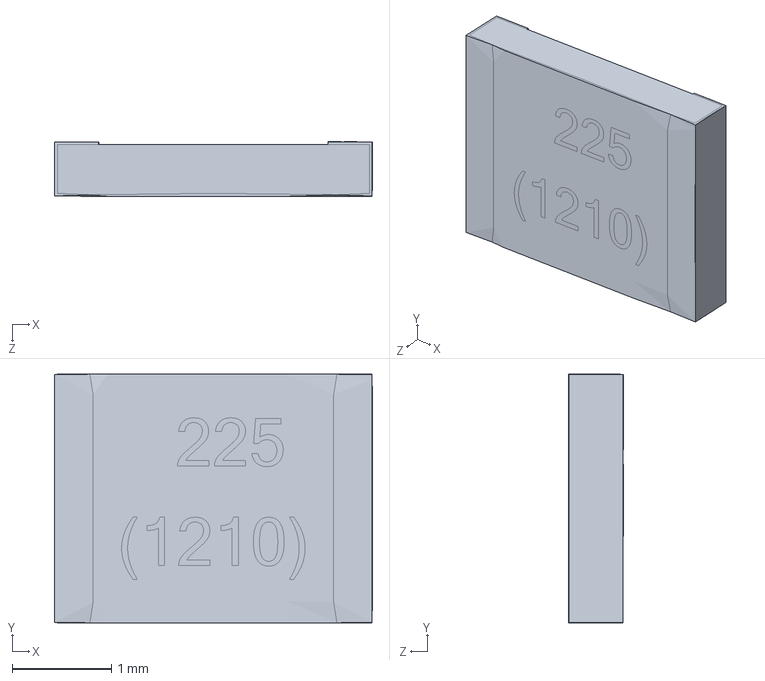
[picture p388: CAD file, 2022-11-10]
mechanical/raspberry-pi-zero-2.snapshot.9/PiZero/1210 inductor.SLDPRT
3.20 x 2.50 x 0.55 mm
