michaellangford99/ECE47700/mechanical/raspberry-pi-zero-2.snapshot.9/PiZero/Crystal 3.4x2.4mm.SLDPRT

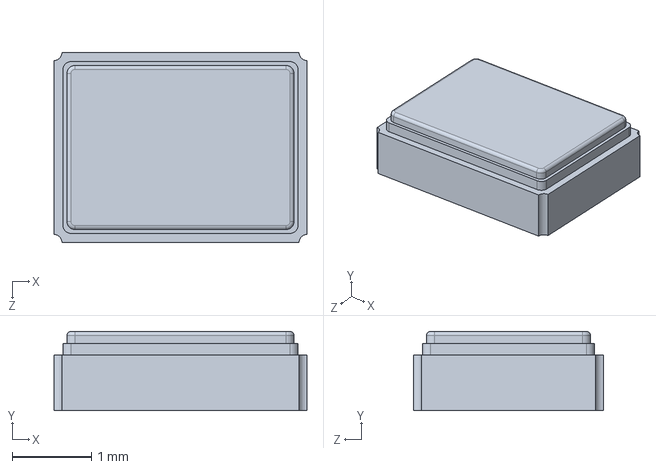
[picture p389: CAD file, 2022-11-10]
mechanical/raspberry-pi-zero-2.snapshot.9/PiZero/Crystal 3.4x2.4mm.SLDPRT
3.20 x 1.00 x 2.40 mm
