michaellangford99/ECE47700/mechanical/raspberry-pi-zero-2.snapshot.9/PiZero/hdmi type C.SLDPRT

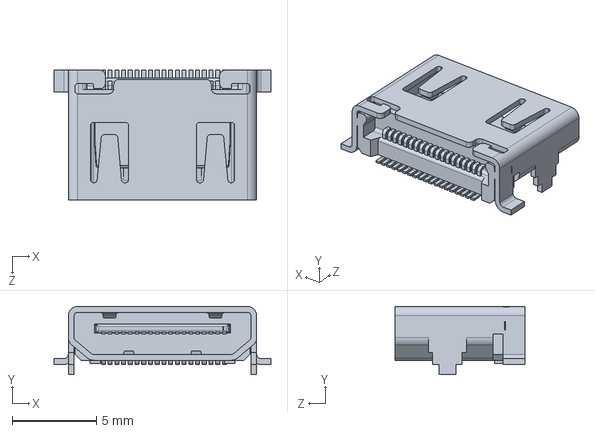
[picture p390: CAD file, 2022-11-10]
mechanical/raspberry-pi-zero-2.snapshot.9/PiZero/hdmi type C.SLDPRT
12.9 x 4.05 x 7.70 mm
