michaellangford99/ECE47700/mechanical/raspberry-pi-zero-2.snapshot.9/PiZero/Raspberry_pizero_BCM2835 with VC4.SLDPRT

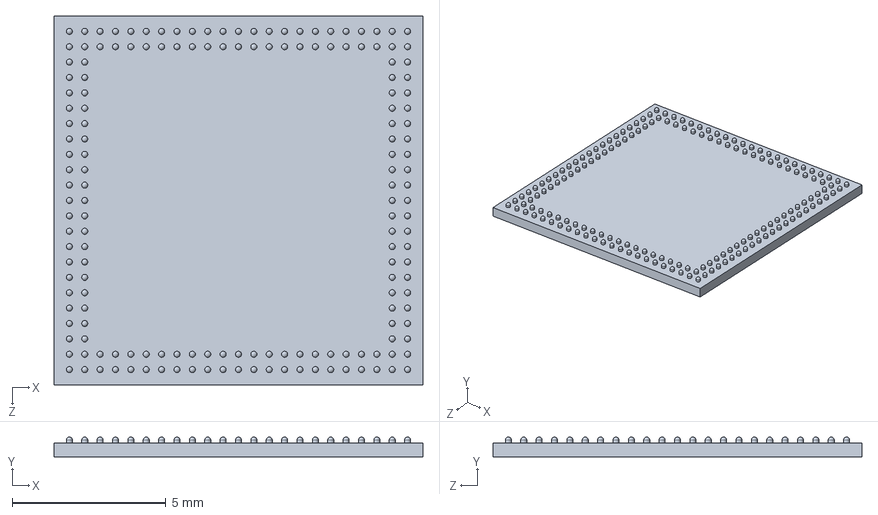
[picture p391: CAD file, 2022-11-10]
mechanical/raspberry-pi-zero-2.snapshot.9/PiZero/Raspberry_pizero_BCM2835 with VC4.SLDPRT
12.0 x 0.65 x 12.0 mm
