michaellangford99/ECE47700/mechanical/raspberry-pi-zero-2.snapshot.9/PiZero/Micro USB_input_female (short)-SMT.SLDPRT

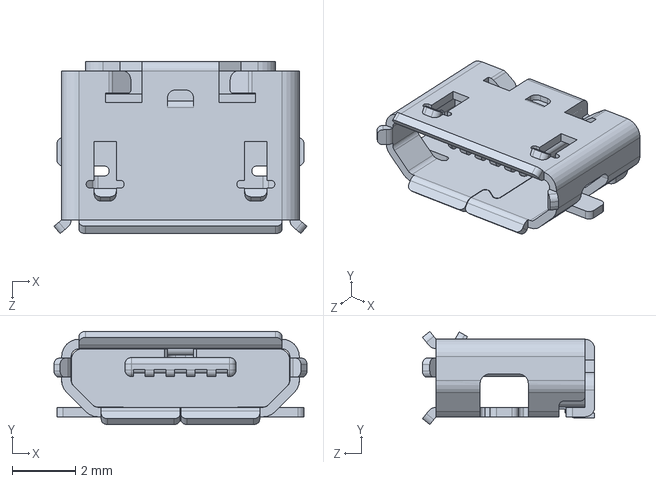
[picture p392: CAD file, 2022-11-10]
mechanical/raspberry-pi-zero-2.snapshot.9/PiZero/Micro USB_input_female (short)-SMT.SLDPRT
7.98 x 2.94 x 5.43 mm
