michaellangford99/ECE47700/mechanical/raspberry-pi-zero-2.snapshot.9/PiZero/micro sd molex.SLDPRT

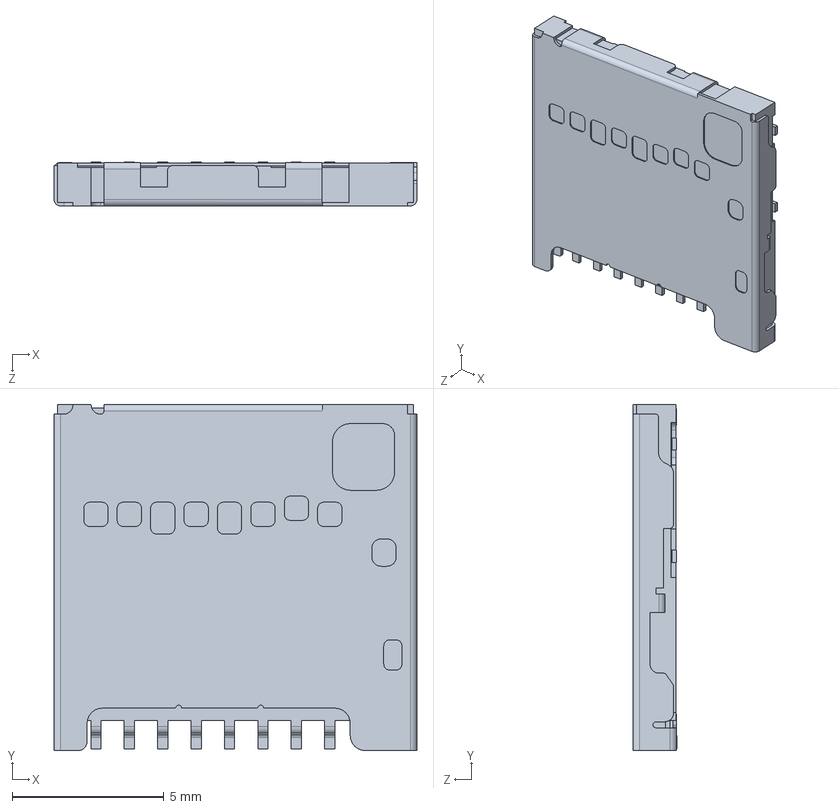
[picture p393: CAD file, 2022-11-10]
mechanical/raspberry-pi-zero-2.snapshot.9/PiZero/micro sd molex.SLDPRT
12.0 x 11.4 x 1.45 mm
