michaellangford99/ECE47700/mechanical/raspberry-pi-zero-2.snapshot.9/PiZero/0204- Resistor.SLDPRT

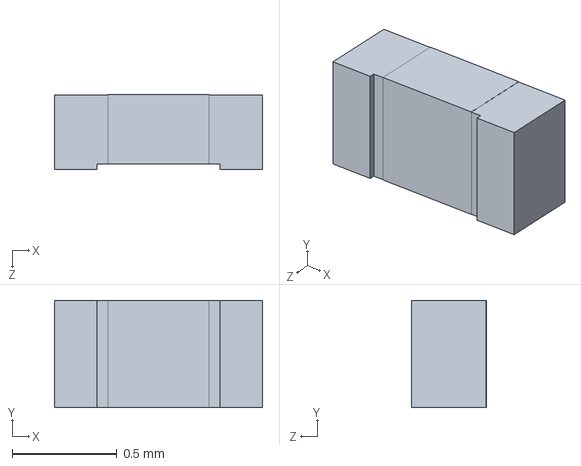
[picture p394: CAD file, 2022-11-10]
mechanical/raspberry-pi-zero-2.snapshot.9/PiZero/0204- Resistor.SLDPRT
0.991 x 0.51 x 0.357 mm
