michaellangford99/ECE47700/mechanical/raspberry-pi-zero-2.snapshot.9/PiZero/Raspberry_pizero_PCB.SLDPRT

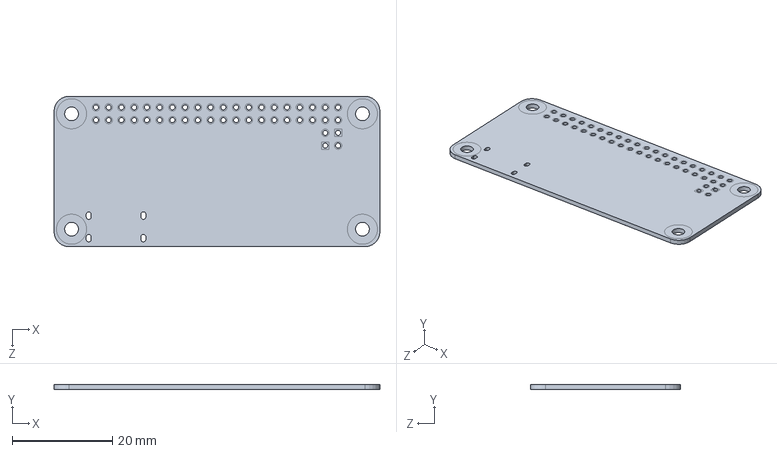
[picture p395: CAD file, 2022-11-10]
mechanical/raspberry-pi-zero-2.snapshot.9/PiZero/Raspberry_pizero_PCB.SLDPRT
65.0 x 1.00 x 30.0 mm
