michaellangford99/ECE47700/(list of files, cad)

Other CAD files:
pcb/ECE477_PCB/ECE477_PCB.iges
data/5v-step-up-step-down-regulator-s13vxf5/5v-2a-step-up-step-down-voltage-regulator-s13v20f5.step
mechanical/landing_gear_and_lidar_mounts/stls/sidemount1.stl
mechanical/raspberry-pi-zero-2.snapshot.9/PiZero/0204 - Capacitor.SLDPRT
mechanical/COMPOUND.ipt
mechanical/C_0402_1005Metric.iam
mechanical/C_0603_1608Metric.iam
mechanical/C_1206_3216Metric.iam
mechanical/C_1210_3225Metric.iam
mechanical/C_Elec_3x5.4.iam
mechanical/Crystal_SMD_3225-4Pin_3.2x2.5mm.iam
mechanical/D_0805_2012Metric.iam
mechanical/ECE477.iam
mechanical/ECE477_PCB (1).iam
mechanical/ECE477_PCB PCB.ipt
mechanical/Flight Controller Mount.ipt
mechanical/LED_0603_1608Metric.iam
mechanical/LGA-14_3x2.5mm_P0.5mm_LayoutBorder3x4y.iam
mechanical/LQFP-64_10x10mm_P0.5mm.iam
mechanical/OldVersions/ECE477.0018.iam
mechanical/OldVersions/Flight Controller Mount.0007.ipt
mechanical/OldVersions/RapberryPiZero.0002.iam
mechanical/PinHeader_1x02_P2.00mm_Vertical.iam
mechanical/PinHeader_1x02_P2.54mm_Vertical.iam
mechanical/PinHeader_1x03_P2.54mm_Horizontal.iam
mechanical/PinHeader_1x05_P1.00mm_Vertical.iam
mechanical/PinHeader_2x05_P2.54mm_Vertical.iam
mechanical/PinSocket_1x04_P1.27mm_Vertical.iam
mechanical/PinSocket_2x05_P1.27mm_Vertical_SMD.iam
mechanical/QFN-16-1EP_4x4mm_P0.65mm_EP2.5x2.5mm.iam
mechanical/R_0402_1005Metric.iam
mechanical/R_0603_1608Metric.iam
mechanical/RapberryPiZero.iam
mechanical/SOLID.ipt
mechanical/SOLID_1.ipt
mechanical/SOLID_10.ipt
mechanical/SOLID_11.ipt
mechanical/SOLID_12.ipt
mechanical/SOLID_13.ipt
mechanical/SOLID_14.ipt
mechanical/SOLID_15.ipt
mechanical/SOLID_16.ipt
mechanical/SOLID_17.ipt
mechanical/SOLID_18.ipt
mechanical/SOLID_19.ipt
mechanical/SOLID_2.ipt
mechanical/SOLID_20.ipt
mechanical/SOLID_21.ipt
mechanical/SOLID_3.ipt
mechanical/SOLID_4.ipt
mechanical/SOLID_5.ipt
mechanical/SOLID_6.ipt
mechanical/SOLID_7.ipt
mechanical/SOLID_8.ipt
mechanical/SOLID_9.ipt
mechanical/SOT-223.iam
mechanical/SOT-23.iam
mechanical/SW_SPST_B3U-1000P.iam
mechanical/Velox ESC.ipt
mechanical/landing_gear_and_lidar_mounts/frontbackmount.ipt
mechanical/landing_gear_and_lidar_mounts/frontbackmountlidar.ipt
mechanical/landing_gear_and_lidar_mounts/frontbackmountpi.ipt
mechanical/landing_gear_and_lidar_mounts/land.ipt
mechanical/landing_gear_and_lidar_mounts/land3.ipt
mechanical/landing_gear_and_lidar_mounts/landing.ipt
mechanical/landing_gear_and_lidar_mounts/landingclasp.ipt
mechanical/landing_gear_and_lidar_mounts/sidemount.ipt
mechanical/landing_gear_and_lidar_mounts/sidemount1.ipt
mechanical/landing_gear_and_lidar_mounts/sidemount2.ipt
mechanical/landing_gear_and_lidar_mounts/sidemount3.ipt
mechanical/raspberry-pi-zero-2.snapshot.9/0204 - Capacitor Brown.ipt
mechanical/raspberry-pi-zero-2.snapshot.9/0204 - Capacitor.ipt
mechanical/raspberry-pi-zero-2.snapshot.9/0204- Resistor.ipt
mechanical/raspberry-pi-zero-2.snapshot.9/0805- Capacitor.ipt
mechanical/raspberry-pi-zero-2.snapshot.9/1210 inductor.ipt
mechanical/raspberry-pi-zero-2.snapshot.9/32,768 Khz Crystal.ipt
mechanical/raspberry-pi-zero-2.snapshot.9/6-Pin SOT.ipt
mechanical/raspberry-pi-zero-2.snapshot.9/CAP-0306.ipt
mechanical/raspberry-pi-zero-2.snapshot.9/Crystal 3.4x2.4mm.ipt
mechanical/raspberry-pi-zero-2.snapshot.9/Micro USB_input_female (short)-SMT.ipt
mechanical/raspberry-pi-zero-2.snapshot.9/RapberryPiZero.iam
mechanical/raspberry-pi-zero-2.snapshot.9/Raspberry_pizero_BCM2835 with VC4.ipt
mechanical/raspberry-pi-zero-2.snapshot.9/Raspberry_pizero_PCB.ipt
mechanical/raspberry-pi-zero-2.snapshot.9/Voltage Regulator 3x3mm 12-Pin.ipt
mechanical/raspberry-pi-zero-2.snapshot.9/hdmi type C.ipt
mechanical/raspberry-pi-zero-2.snapshot.9/micro sd molex.ipt
mechanical/stls/Flight Controller Mount.stl
pcb/ECE477_PCB/ECE477_PCB.dxf
