michaellangford99/ECE47700/pcb/ECE477_PCB/Printouts/top_drill_mark-10-6-2022.pdf

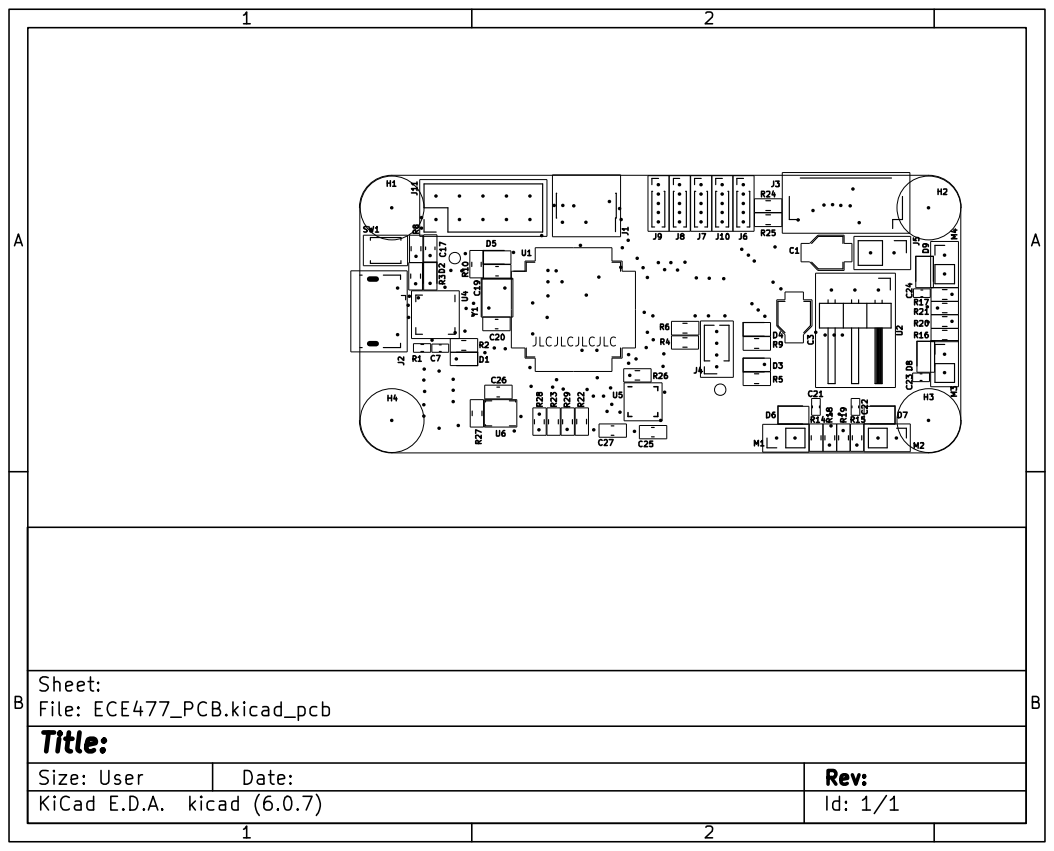
[picture p396: page 1]
