michaellangford99/ECE47700/pcb/ECE477_PCB/Printouts/bottom-10-5-2022.pdf

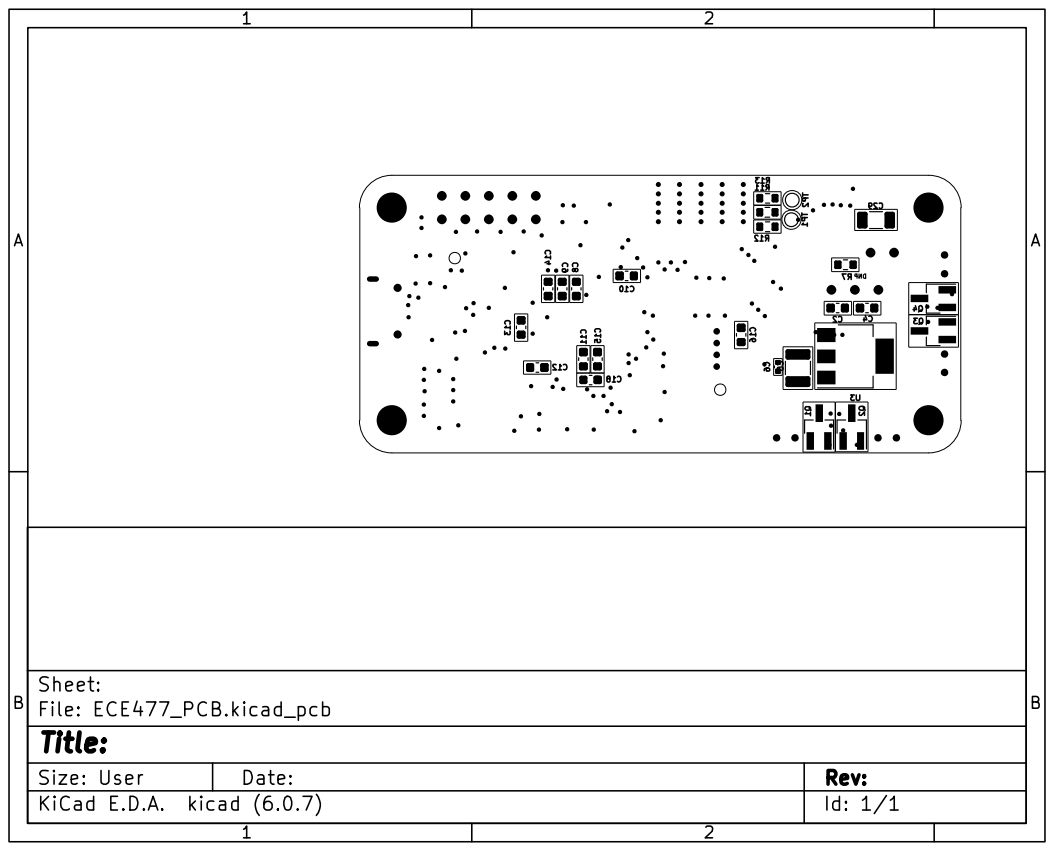
[picture p397: page 1]
