michaellangford99/ECE47700/pcb/ECE477_PCB/Printouts/schematic_page_1-10-5-2022.pdf

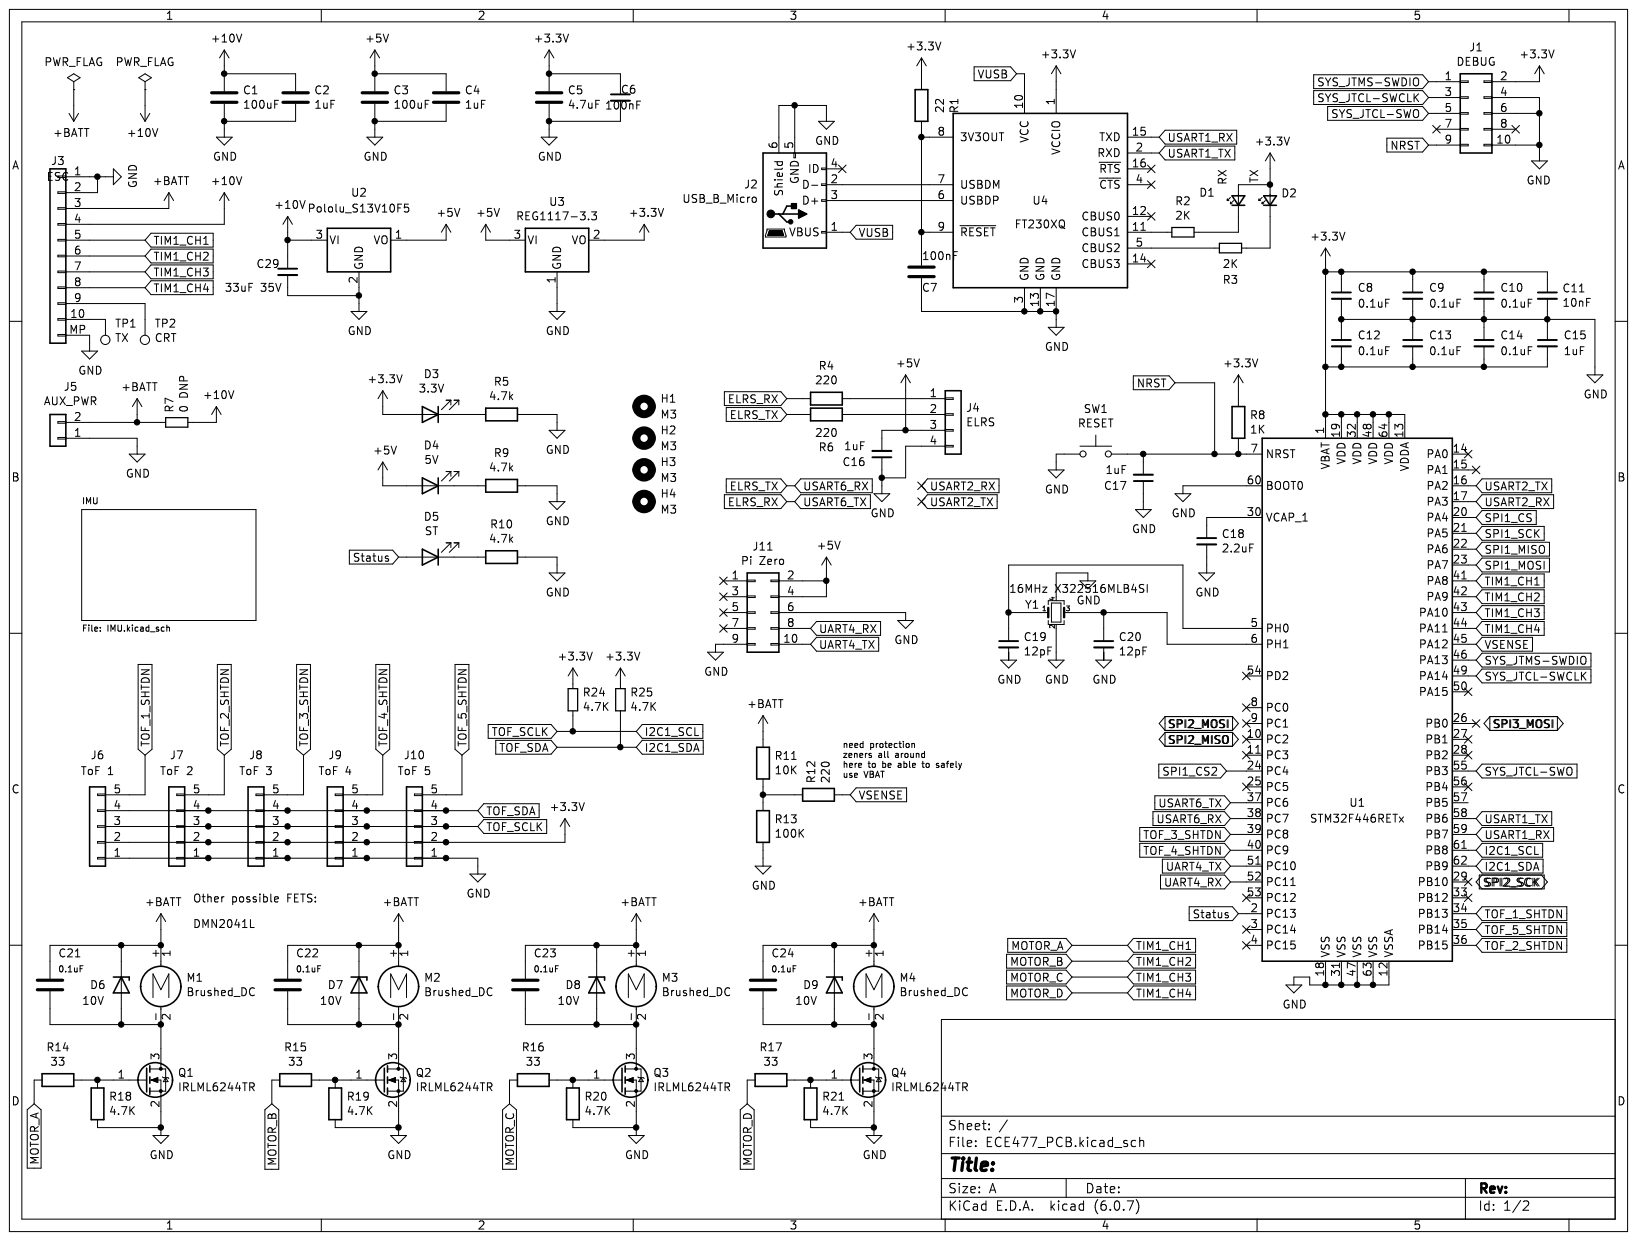
[picture p398: page 1]

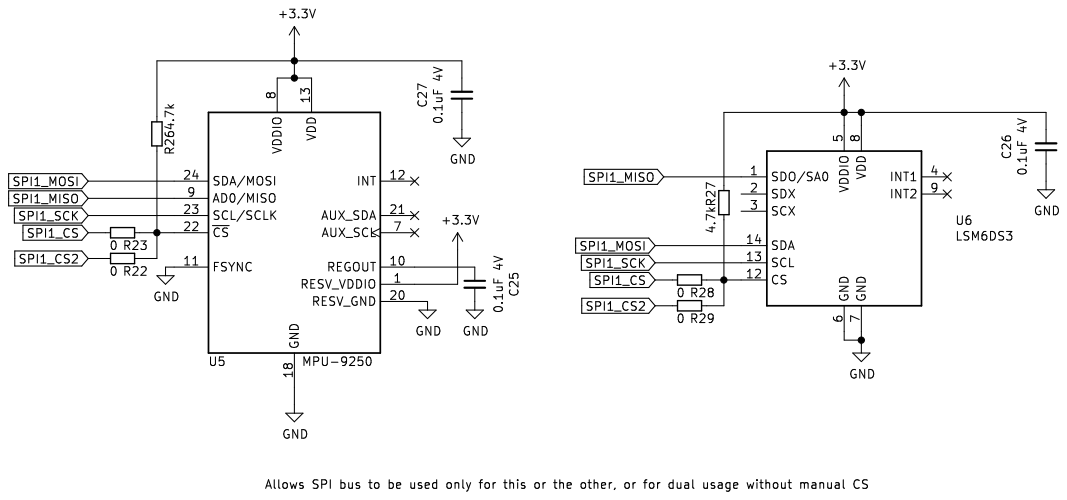
[picture p399: page 2]
