michaellangford99/ECE47700/pcb/ECE477_PCB/Printouts/schematic_page_2-10-5-2022.pdf

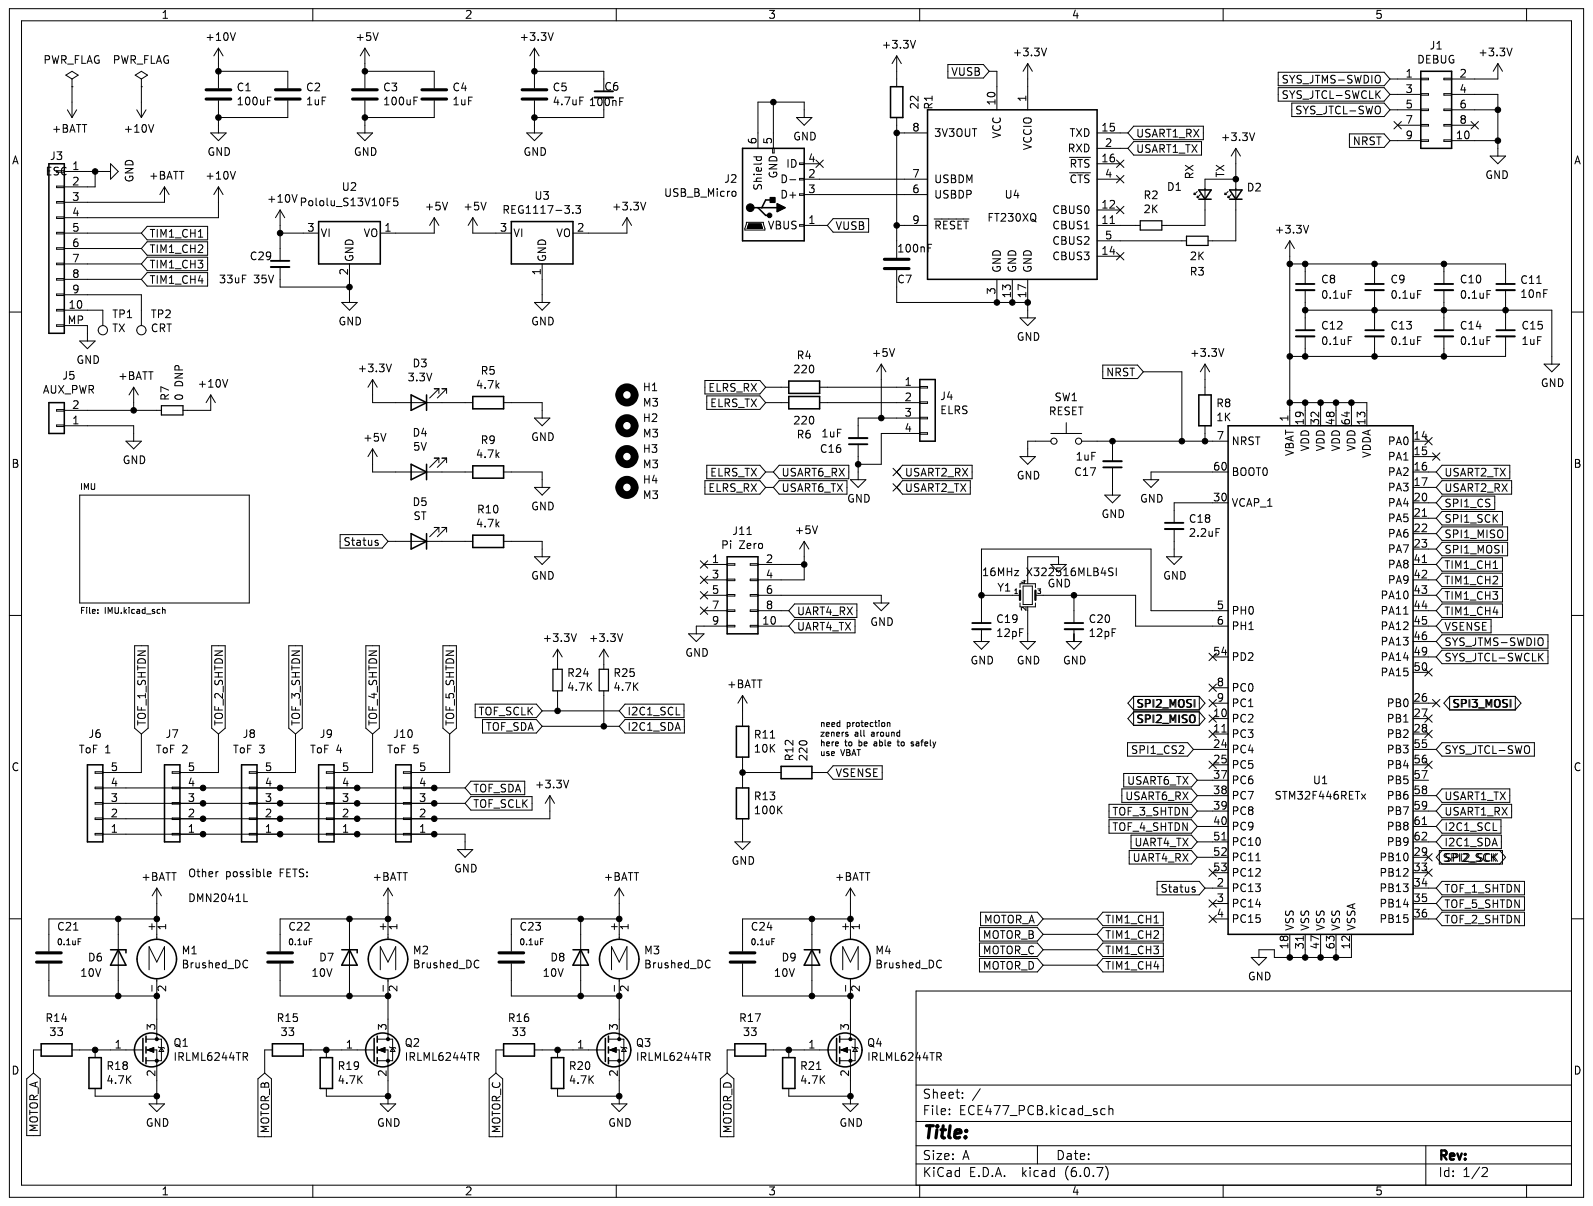
[picture p400: page 1]

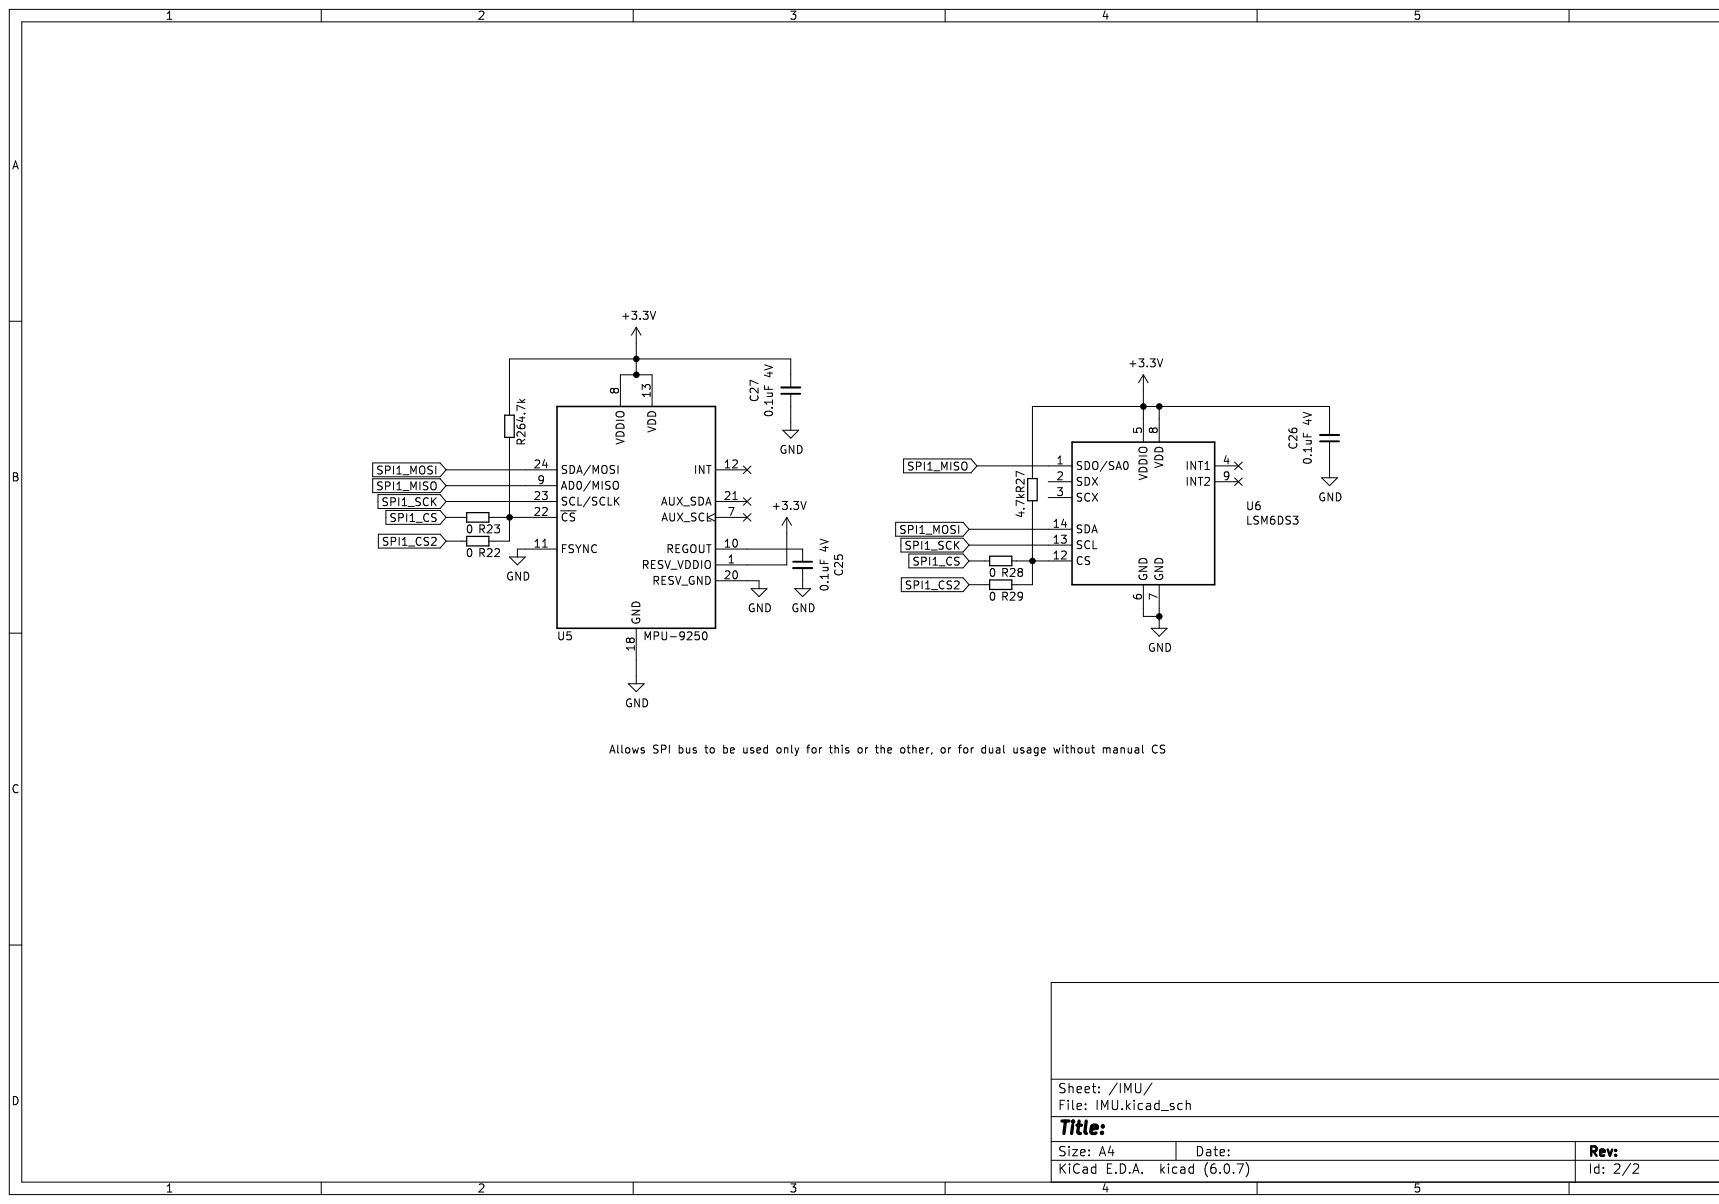
[picture p401: page 2]
