michaellangford99/ECE47700/pcb/ECE477_PCB/Printouts/top-10-5-2022.pdf

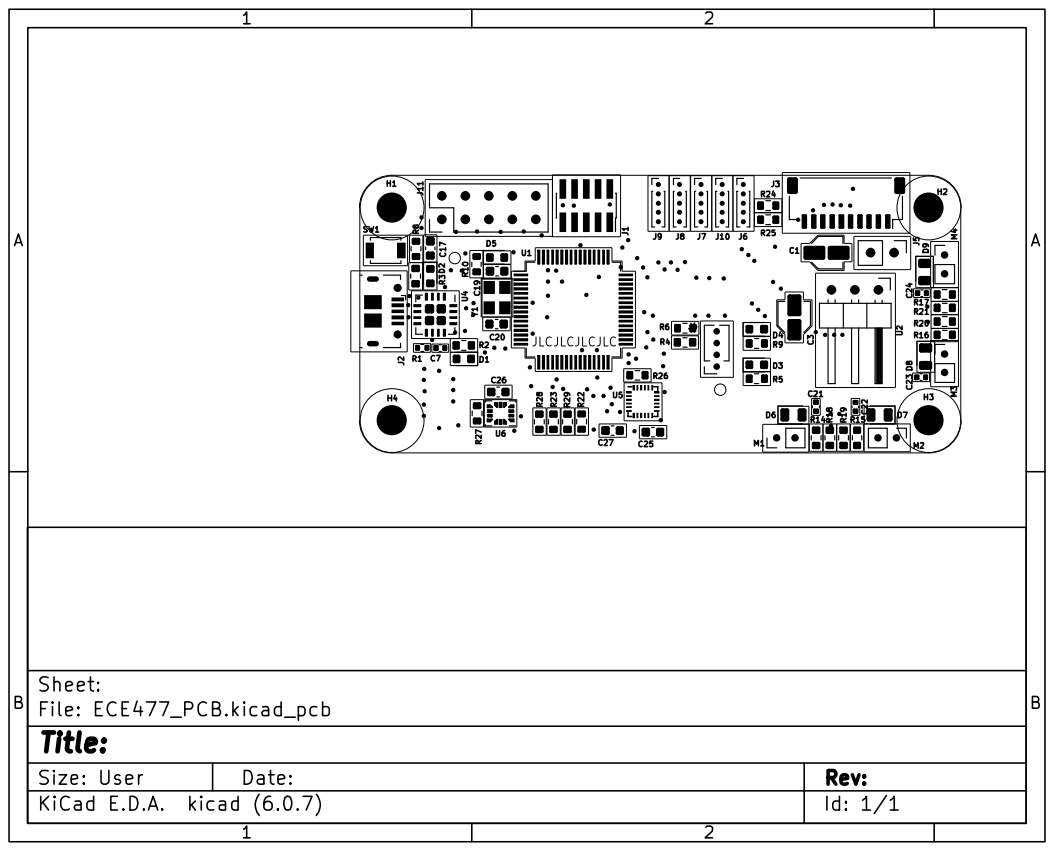
[picture p402: page 1]
