michaellangford99/ECE47700/pcb/ECE477_PCB/Printouts/top_drill_mark-10-5-2022.pdf

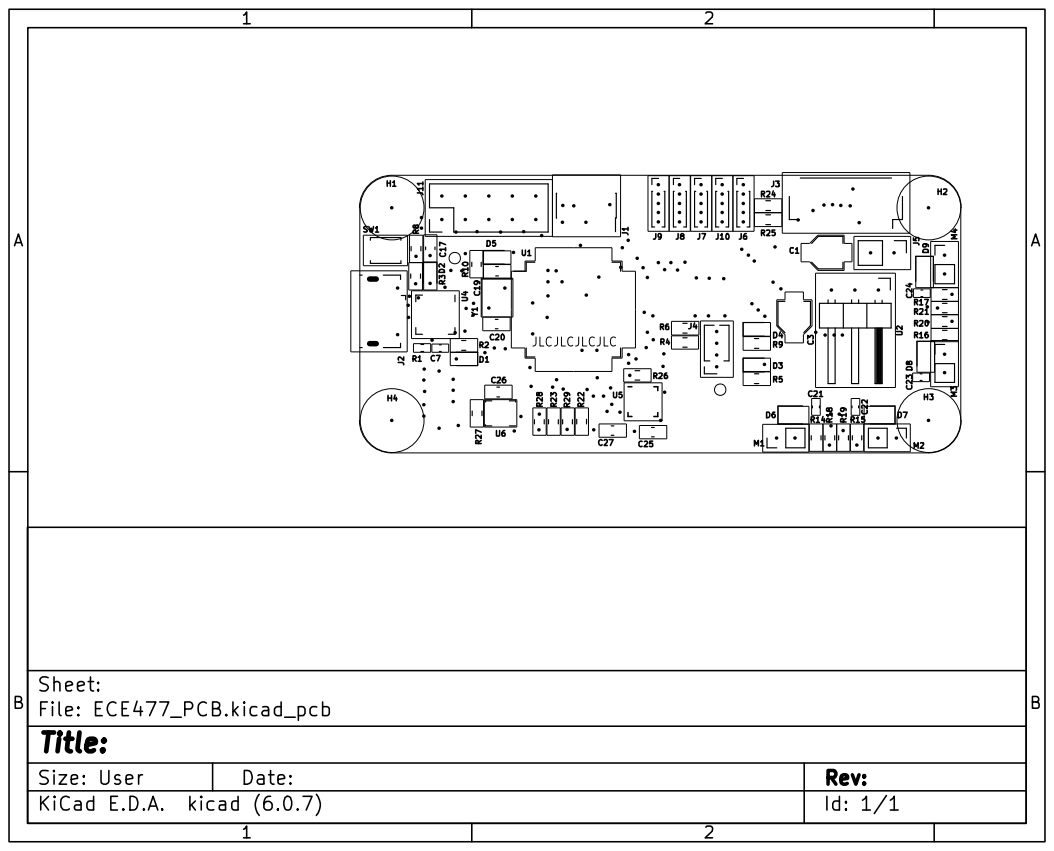
[picture p403: page 1]
