michaellangford99/ECE47700/pcb/ECE477_PCB/ECE477_PCB.kicad_pcb

## KiCad design pcb/ECE477_PCB/ECE477_PCB.kicad_pcb (2022-10-27)

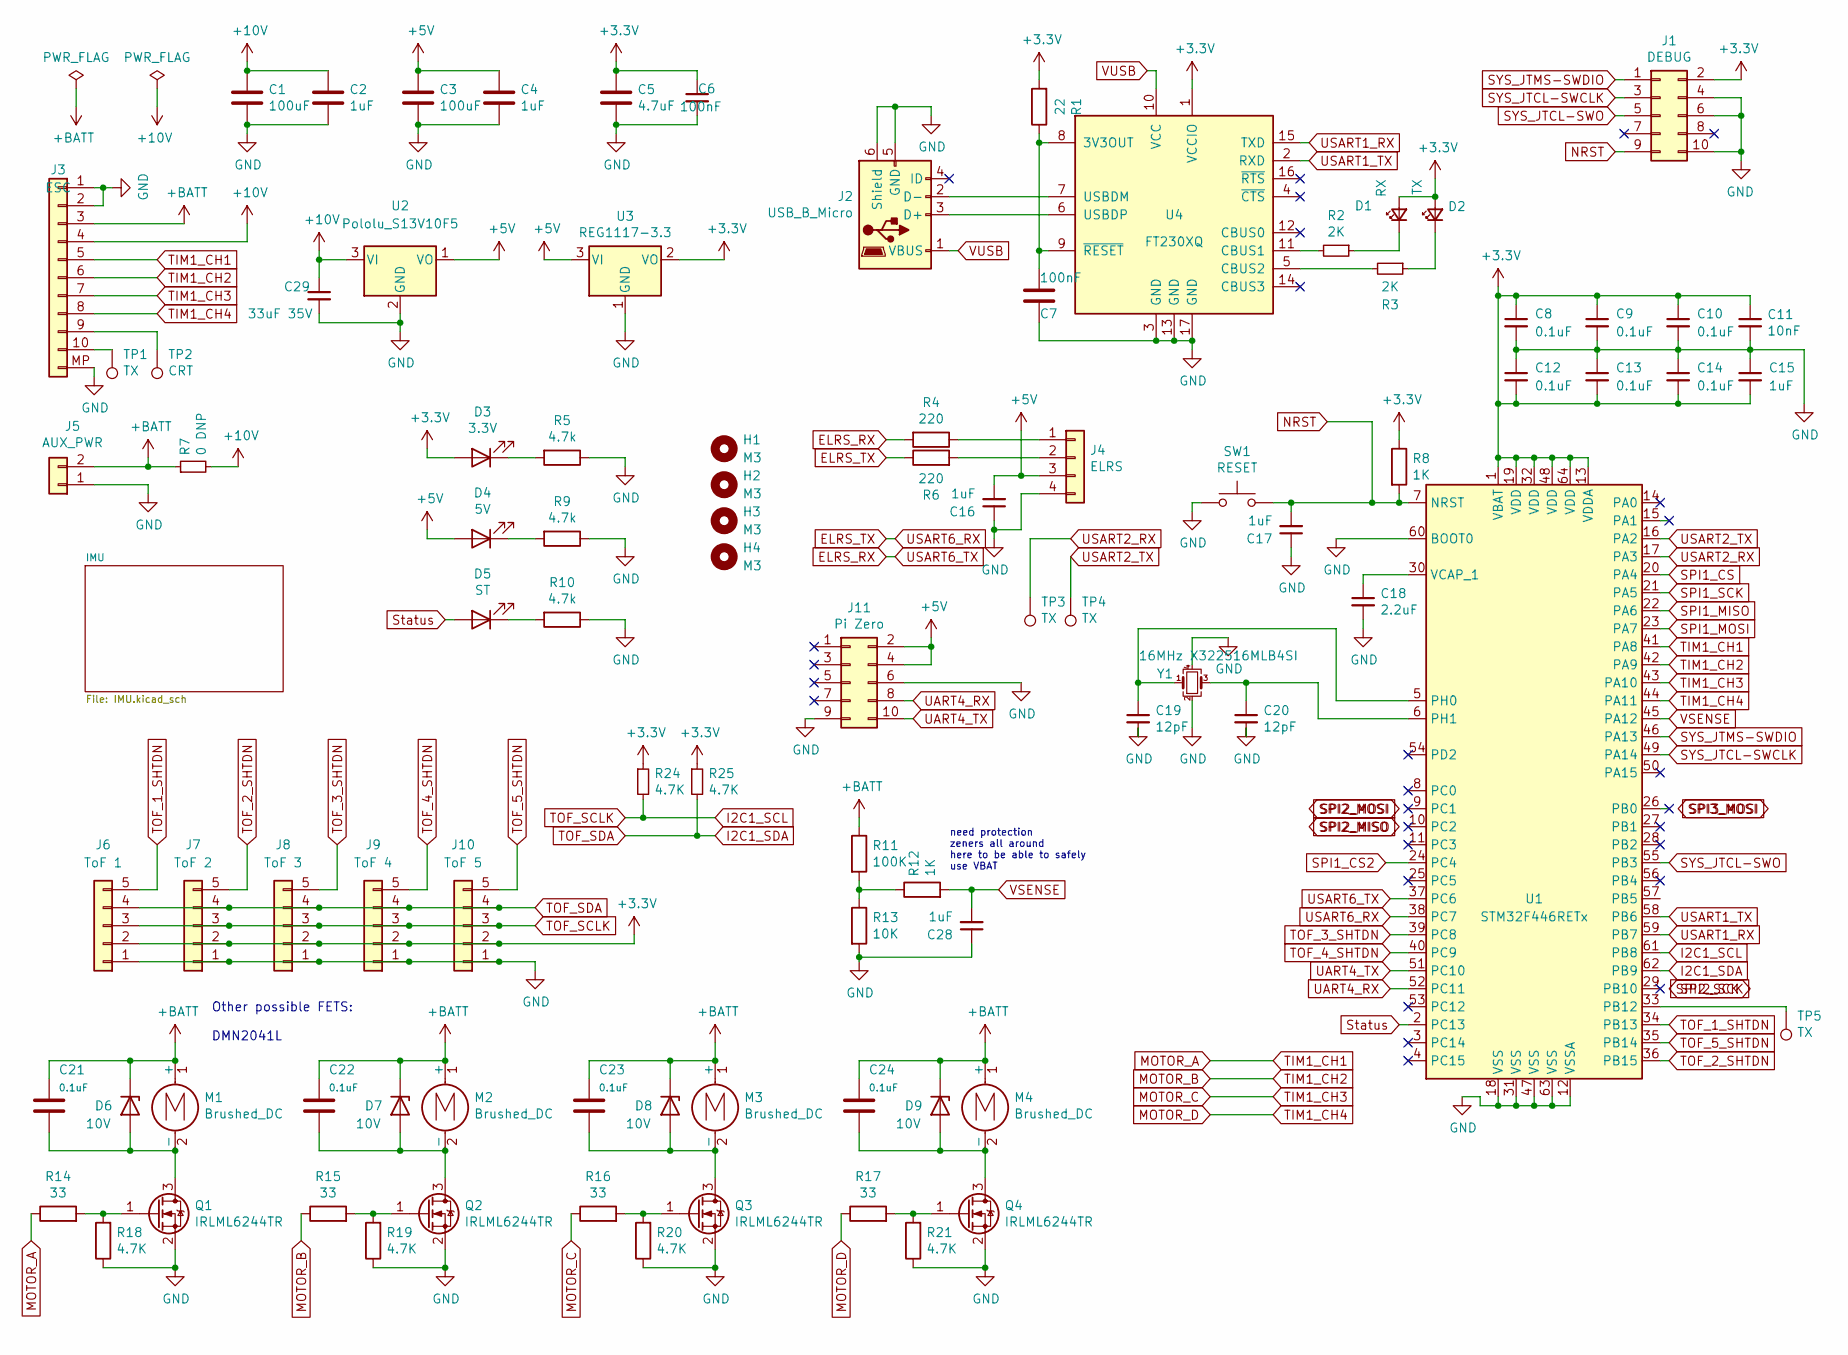
[picture p404: schematic ECE477_PCB.kicad_sch]

Parts:
C1, C3: 100uF; C_Elec_3x5.4; JLCPCB BOM 0
C2, C4, C15, C16, C17, C28: 1uF; C_0603_1608Metric; LCSC Part # C15849
C5: 4.7uF; C_1210_3225Metric; JLCPCB BOM 0
C6, C7: 100nF; C_0402_1005Metric; LCSC Part # C1525
C8, C9, C10, C12, C13, C14: 0.1uF; C_0603_1608Metric
C11: 10nF; C_0603_1608Metric; LCSC Part # C57112
C18: 2.2uF; C_0603_1608Metric; LCSC Part # C23630
C19, C20: 12pF; C_0603_1608Metric; LCSC Part # C38523
C21, C22, C23, C24: 0.1uF; C_0402_1005Metric; LCSC Part # C1525
C29: 33uF 35V; C_1206_3216Metric
D1: RX; LED_0603_1608Metric; LCSC Part # C72041
D2: TX; LED_0603_1608Metric; LCSC Part # C2286
D3: 3.3V; LED_0603_1608Metric; LCSC Part # C72038
D4: 5V; LED_0603_1608Metric; LCSC Part # C72038
D5: ST; LED_0603_1608Metric; LCSC Part # C72043
D6, D7, D8, D9: 10V; D_0805_2012Metric; JLCPCB BOM 0
H1, H2, H3, H4: M3; MountingHole_3.2mm_M3
J1: DEBUG; PinSocket_2x05_P1.27mm_Vertical_SMD; JLCPCB BOM 0
J2: USB_B_Micro; USB_Micro-B_Molex-105017-0001; JLCPCB BOM 0
J3: ESC; JST_SH_SM10B-SRSS-TB_1x10-1MP_P1.00mm_Horizontal
J4: ELRS; PinSocket_1x04_P1.27mm_Vertical; JLCPCB BOM 0
J5: AUX_PWR; PinHeader_1x02_P2.54mm_Vertical; JLCPCB BOM 0
J6: ToF 1; PinHeader_1x05_P1.00mm_Vertical
J7: ToF 2; PinHeader_1x05_P1.00mm_Vertical
J8: ToF 3; PinHeader_1x05_P1.00mm_Vertical
J9: ToF 4; PinHeader_1x05_P1.00mm_Vertical
J10: ToF 5; PinHeader_1x05_P1.00mm_Vertical
J11: Pi Zero; PinHeader_2x05_P2.54mm_Vertical; JLCPCB BOM 0
M1, M2, M3, M4: Brushed_DC; PinHeader_1x02_P2.00mm_Vertical; JLCPCB BOM 0
Q1, Q2, Q3, Q4: IRLML6244TR; SOT-23_Handsoldering; JLCPCB BOM 0
R1: 22; R_0402_1005Metric; LCSC Part # C25092
R2, R3: 2K; R_0603_1608Metric; LCSC Part # C22975
R4, R6: 220; R_0603_1608Metric; LCSC Part # C22962
R5, R9, R10: 4.7k; R_0603_1608Metric; LCSC Part # C23162
R7: 0 DNP; R_0603_1608Metric; LCSC Part # C23162
R8: 1K; R_0603_1608Metric; LCSC Part # C21190
R11: 100K; R_0603_1608Metric; LCSC Part # C22984
R12: 1K; R_0603_1608Metric; LCSC Part # C22984
R13: 10K; R_0603_1608Metric; LCSC Part # C25803
R14, R15, R16, R17: 33; R_0603_1608Metric; LCSC Part # C23140
R18, R19, R20, R21, R24, R25: 4.7K; R_0603_1608Metric; LCSC Part # C23162
SW1: RESET; SW_SPST_B3U-1000P; JLCPCB BOM 0
TP1, TP3, TP4, TP5: TX; TestPoint_Pad_D1.0mm
TP2: CRT; TestPoint_Pad_D1.0mm
U1: STM32F446RETx; LQFP-64_10x10mm_P0.5mm; LCSC Part # C69336
U2: Pololu_S13V10F5; PinHeader_1x03_P2.54mm_Horizontal
U3: REG1117-3.3; SOT-223
U4: FT230XQ; QFN-16-1EP_4x4mm_P0.65mm_EP2.5x2.5mm; LCSC Part # C128629
Y1: 16MHz X322516MLB4SI; Crystal_SMD_3225-4Pin_3.2x2.5mm; LCSC Part # C13738

Connections:
+3V3: C5.1, C6.1, C8.1, C9.1, C10.1, C11.1, C12.2, C13.2, C14.2, C15.2, D1.2 (A), D2.2 (A), D3.2 (A), J1.2, J6.2, J7.2, J8.2, J9.2, J10.2, R1.2, R8.1, R24.1, R25.1, U1.1 (VBAT), U1.13 (VDDA), U1.19 (VDD), U1.32 (VDD), U1.48 (VDD), U1.64 (VDD), U3.2 (VO), U4.1 (VCCIO); also elsewhere on the board
+5V: C3.1, C4.1, C16.2, D4.2 (A), J4.3, J11.2, J11.4, U2.1 (VO), U3.3 (VI)
+10V: C1.1, C2.1, C29.1, J3.4, R7.2, U2.3 (VI)
+BATT: C21.1, C22.1, C23.1, C24.1, D6.1 (K), D7.1 (K), D8.1 (K), D9.1 (K), J3.3, J5.2, M1.1 (+), M2.1 (+), M3.1 (+), M4.1 (+), R7.1, R11.1
ELRS_RX: R4.2, U1.37 (PC6)
ELRS_TX: R6.1, U1.38 (PC7)
GND: C1.2, C2.2, C3.2, C4.2, C5.2, C6.2, C7.1, C8.2, C9.2, C10.2, C11.2, C12.1, C13.1, C14.1, C15.1, C16.1, C17.1, C18.2, C19.2, C20.2, C28.1, C29.2, J1.4, J1.6, J1.10, J2.5 (GND), J2.6 (Shield), J3.1, J3.2, J3.MP (Pin_11), J4.4, J5.1, J6.1, J7.1, J8.1, J9.1, J10.1, J11.6, J11.9, Q1.2 (S), Q2.2 (S), Q3.2 (S), Q4.2 (S), R5.1, R9.1, R10.1, R13.2, R18.1, R19.1, R20.1, R21.1, SW1.1, U1.12 (VSSA), U1.18 (VSS), U1.31 (VSS), U1.47 (VSS), U1.60 (BOOT0), U1.63 (VSS), U2.2 (GND), U3.1 (GND), U4.3 (GND), U4.13 (GND), U4.17 (GND), Y1.2, Y1.4; also elsewhere on the board
I2C1_SCL: J6.3, J7.3, J8.3, J9.3, J10.3, R24.2, U1.61 (PB8)
I2C1_SDA: J6.4, J7.4, J8.4, J9.4, J10.4, R25.2, U1.62 (PB9)
MOTOR_A: J3.5, R14.1, U1.41 (PA8)
MOTOR_B: J3.6, R15.1, U1.42 (PA9)
MOTOR_C: J3.7, R16.1, U1.43 (PA10)
MOTOR_D: J3.8, R17.1, U1.44 (PA11)
NRST: C17.2, J1.9, R8.2, SW1.2, U1.7 (NRST)
unnamed: C7.2, R1.1, U4.8 (3V3OUT), U4.9 (~RESET)
unnamed: C18.1, U1.30 (VCAP_1)
unnamed: C19.1, U1.5 (PH0), Y1.1
unnamed: C20.1, U1.6 (PH1), Y1.3
unnamed: C21.2, D6.2 (A), M1.2 (-), Q1.3 (D)
unnamed: C22.2, D7.2 (A), M2.2 (-), Q2.3 (D)
unnamed: C23.2, D8.2 (A), M3.2 (-), Q3.3 (D)
unnamed: C24.2, D9.2 (A), M4.2 (-), Q4.3 (D)
unnamed: D1.1 (K), R2.1
unnamed: D2.1 (K), R3.1
unnamed: D3.1 (K), R5.2
unnamed: D4.1 (K), R9.2
unnamed: D5.1 (K), R10.2
unnamed: J2.2 (D-), U4.7 (USBDM)
unnamed: J2.3 (D+), U4.6 (USBDP)
unnamed: J3.9, TP2.1
unnamed: J3.10, TP1.1
unnamed: J4.1, R4.1
unnamed: J4.2, R6.2
unnamed: Q1.1 (G), R14.2, R18.2
unnamed: Q2.1 (G), R15.2, R19.2
unnamed: Q3.1 (G), R16.2, R20.2
unnamed: Q4.1 (G), R17.2, R21.2
unnamed: R2.2, U4.11 (CBUS1)
unnamed: R3.2, U4.5 (CBUS2)
unnamed: R11.2, R12.1, R13.1
unnamed: TP5.1, U1.33 (PB12)
SPI1_CS: U1.20 (PA4); also elsewhere on the board
SPI1_CS2: U1.24 (PC4); also elsewhere on the board
SPI1_MISO: U1.22 (PA6); also elsewhere on the board
SPI1_MOSI: U1.23 (PA7); also elsewhere on the board
SPI1_SCK: U1.21 (PA5); also elsewhere on the board
SYS_JTCL-SWCLK: J1.3, U1.49 (PA14)
SYS_JTCL-SWO: J1.5, U1.55 (PB3)
SYS_JTMS-SWDIO: J1.1, U1.46 (PA13)
Status: D5.2 (A), U1.2 (PC13)
TOF_1_SHTDN: J6.5, U1.34 (PB13)
TOF_2_SHTDN: J7.5, U1.36 (PB15)
TOF_3_SHTDN: J8.5, U1.39 (PC8)
TOF_4_SHTDN: J9.5, U1.40 (PC9)
TOF_5_SHTDN: J10.5, U1.35 (PB14)
UART4_RX: J11.8, U1.52 (PC11)
UART4_TX: J11.10, U1.51 (PC10)
USART1_RX: U1.59 (PB7), U4.15 (TXD)
USART1_TX: U1.58 (PB6), U4.2 (RXD)
USART2_RX: TP3.1, U1.17 (PA3)
USART2_TX: TP4.1, U1.16 (PA2)
VSENSE: C28.2, R12.2, U1.45 (PA12)
VUSB: J2.1 (VBUS), U4.10 (VCC)

Notes on the sheet:
need protection zeners all around here to be able to safely use VBAT
Other possible FETS: DMN2041L

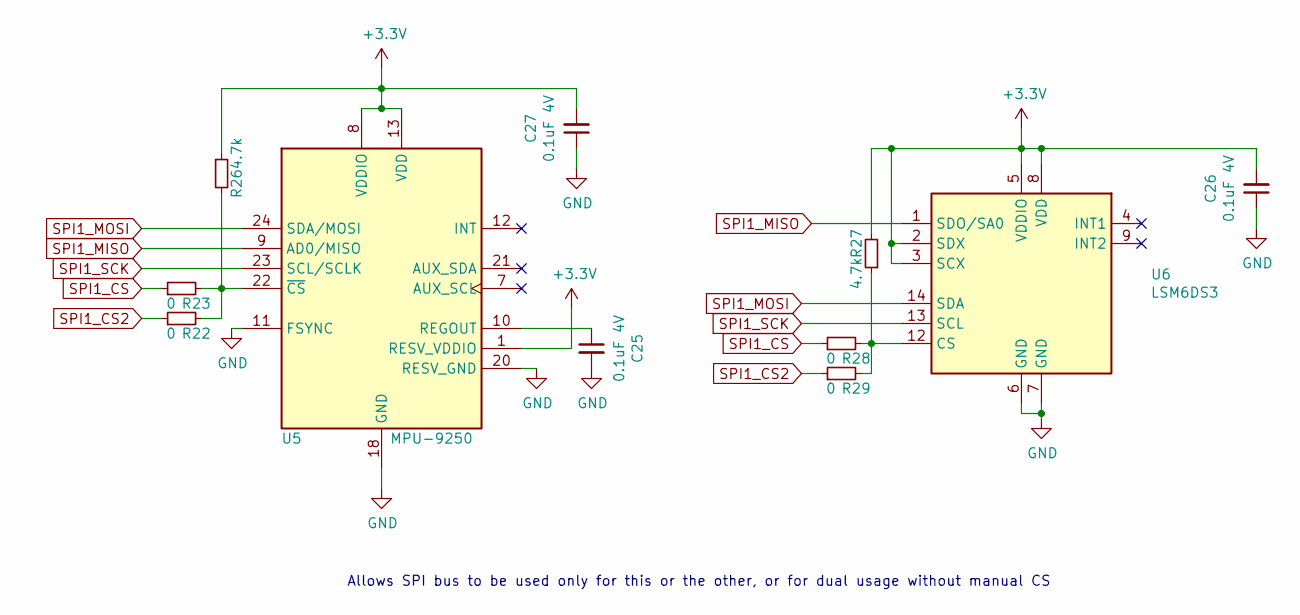
[picture p405: schematic IMU.kicad_sch]

Parts:
C25, C26, C27: 0.1uF 4V; C_0603_1608Metric; LCSC Part # C1525
R22, R23, R28, R29: 0; R_0603_1608Metric; LCSC Part # C23162
R26, R27: 4.7k; R_0603_1608Metric
U5: MPU-9250; InvenSense_QFN-24_3x3mm_P0.4mm
U6: LSM6DS3; LGA-14_3x2.5mm_P0.5mm_LayoutBorder3x4y

Connections:
+3V3: C26.2, C27.2, R26.1, R27.2, U5.1 (RESV_VDDIO), U5.8 (VDDIO), U5.13 (VDD), U6.2 (SDX), U6.3 (SCX), U6.5 (VDDIO), U6.8 (VDD); also elsewhere on the board
GND: C25.2, C26.1, C27.1, U5.11 (FSYNC), U5.18 (GND), U5.20 (RESV_GND), U6.6 (GND), U6.7 (GND); also elsewhere on the board
unnamed: C25.1, U5.10 (REGOUT)
unnamed: R22.2, R23.2, R26.2, U5.22 (~CS)
unnamed: R27.1, R28.2, R29.2, U6.12 (CS)
SPI1_CS: R23.1, R28.1; also elsewhere on the board
SPI1_CS2: R22.1, R29.1; also elsewhere on the board
SPI1_MISO: U5.9 (AD0/MISO), U6.1 (SDO/SA0); also elsewhere on the board
SPI1_MOSI: U5.24 (SDA/MOSI), U6.14 (SDA); also elsewhere on the board
SPI1_SCK: U5.23 (SCL/SCLK), U6.13 (SCL); also elsewhere on the board

Notes on the sheet:
Allows SPI bus to be used only for this or the other, or for dual usage without manual CS

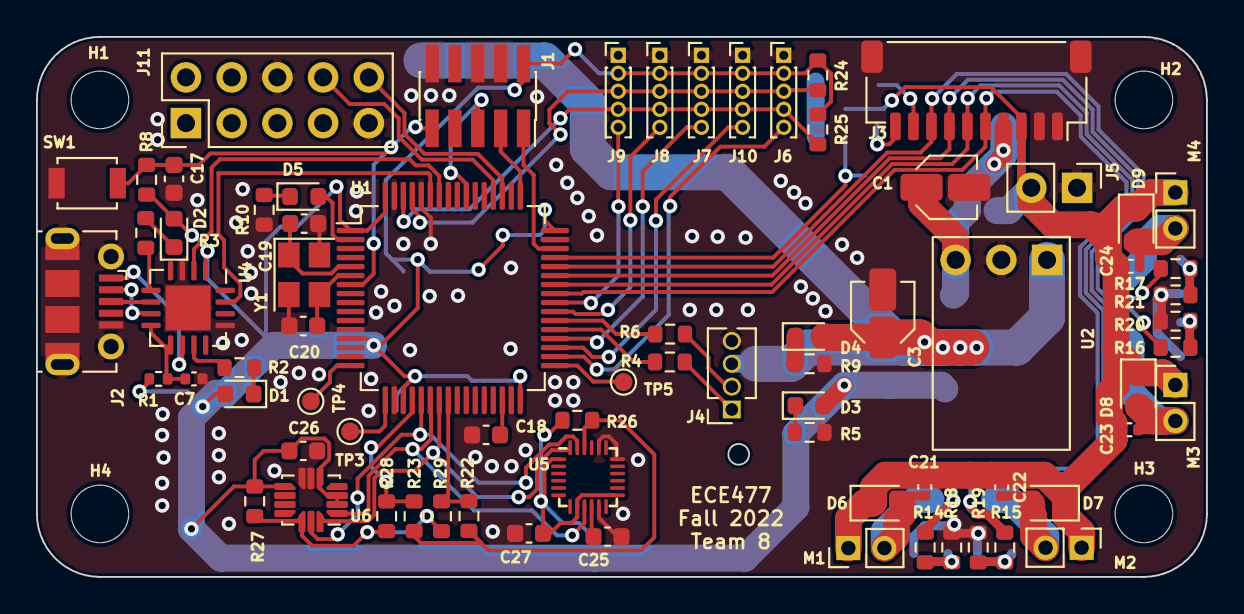
[picture p406: board ECE477_PCB.kicad_pcb from above]

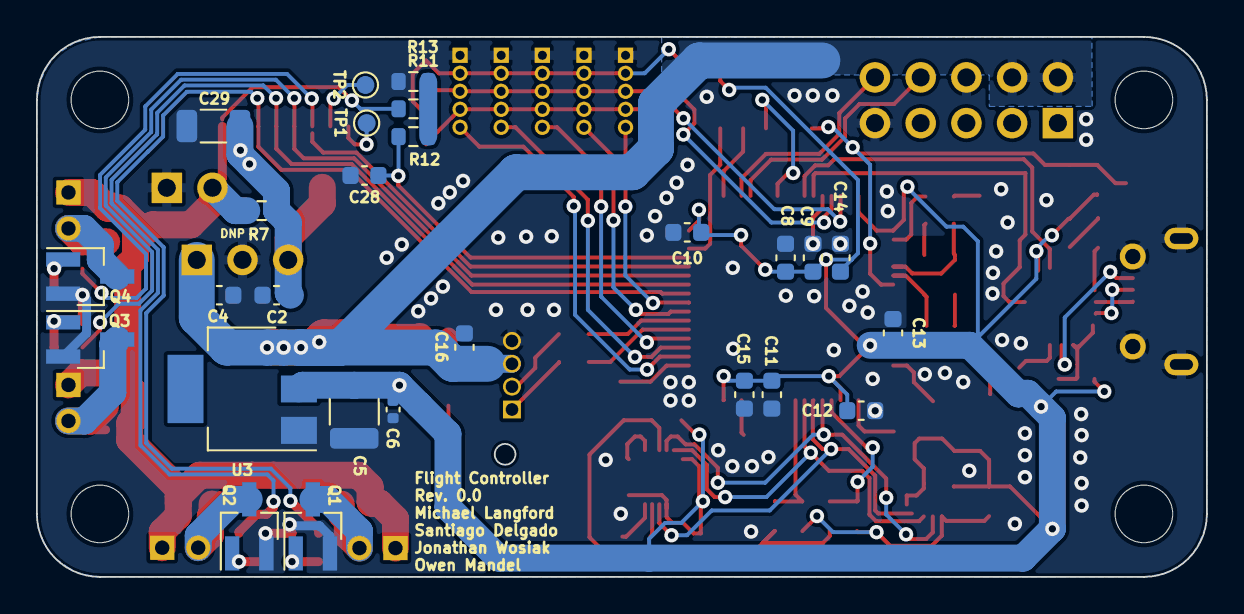
[picture p407: board ECE477_PCB.kicad_pcb from below]

Board: 2 copper layers, 65.0 x 30.0 mm, 103 parts (26 on the bottom side), 66 nets.
