michaellangford99/ECE47700/src/ECE477/src/fir.c

#include "stm32f4xx.h"
#include "string.h"
#include "systick.h"
#include "math.h"
#include "fir.h"

const float hanning_8[8] = {
	0,
	0.1883,
	0.6113,
	0.9505,
	0.9505,
	0.6113,
	0.1883,
	0
};

const float hanning_64[64] = {
        0,
   0.0025,
   0.0099,
   0.0222,
   0.0393,
   0.0609,
   0.0869,
   0.1170,
   0.1509,
   0.1883,
   0.2287,
   0.2719,
   0.3173,
   0.3646,
   0.4132,
   0.4626,
   0.5125,
   0.5622,
   0.6113,
   0.6592,
   0.7056,
   0.7500,
   0.7919,
   0.8308,
   0.8665,
   0.8986,
   0.9266,
   0.9505,
   0.9698,
   0.9845,
   0.9944,
   0.9994,
   0.9994,
   0.9944,
   0.9845,
   0.9698,
   0.9505,
   0.9266,
   0.8986,
   0.8665,
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
        };

const float hanning_256[256] = {
	0,
	0.00015177f,
	0.000607f,
	0.0013654f,
	0.0024265f,
	0.0037897f,
	0.0054542f,
	0.0074189f,
	0.0096826f,
	0.012244f,
	0.015102f,
	0.018253f,
	0.021698f,
	0.025433f,
	0.029455f,
	0.033764f,
	0.038355f,
	0.043227f,
	0.048376f,
	0.0538f,
	0.059494f,
	0.065456f,
	0.071681f,
	0.078166f,
	0.084908f,
	0.091902f,
	0.099143f,
	0.10663f,
	0.11435f,
	0.12231f,
	0.1305f,
	0.13891f,
	0.14754f,
	0.15638f,
	0.16543f,
	0.17469f,
	0.18414f,
	0.19379f,
	0.20362f,
	0.21363f,
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
};

float compute_filter(struct fir_filter* f)
{
	float conv_sum = 0.0f;

	for (int i = 0; i < f->length; i++)
	{
		conv_sum += f->impulse_response[i] * f->circular_buffer[(f->first_element + i) % f->length];
	}

	return conv_sum/((f->length-1)/2.0f);
}

float update_filter(struct fir_filter* f, float new_value)
{
	shift_filter(f, &new_value, 1);

	return compute_filter(f);
}

void shift_filter(struct fir_filter* f, float* new_values, int count)
{
	for (int i = 0; i < count; i++)
	{
		f->circular_buffer[f->first_element] = new_values[i];
		f->first_element++;
		f->first_element = f->first_element%f->length;
	}
}
