michaellangford99/ECE47700/src/ECE477/inc/rx_usart.h

#ifndef __RX_USART_H__
#define __RX_USART_H__

#define CRSF_RX_BAUDRATE 420000
#define CRSF_OPENTX_BAUDRATE 400000
#define CRSF_OPENTX_SLOW_BAUDRATE 115200 // Used for QX7 not supporting 400kbps
#define CRSF_NUM_CHANNELS 16
#define CRSF_CHANNEL_VALUE_MIN 172
#define CRSF_CHANNEL_VALUE_MID 992
#define CRSF_CHANNEL_VALUE_MAX 1811
#define CRSF_MAX_PACKET_LEN 64

typedef struct
{
    uint16_t ch0 : 11;
    uint16_t ch1 : 11;
    uint16_t ch2 : 11;
    uint16_t ch3 : 11;
    uint16_t ch4 : 11;
    uint16_t ch5 : 11;
    uint16_t ch6 : 11;
    uint16_t ch7 : 11;
    uint16_t ch8 : 11;
    uint16_t ch9 : 11;
    uint16_t ch10 : 11;
    uint16_t ch11 : 11;
    uint16_t ch12 : 11;
    uint16_t ch13 : 11;
    uint16_t ch14 : 11;
    uint16_t ch15 : 11;
} __attribute__ ((packed)) crsf_channels_t;

typedef struct
{
    uint8_t device_addr; // from crsf_addr_e
    uint8_t frame_size;  // counts size after this byte, so it must be the payload size + 2 (type and crc)
    uint8_t type;        // from crsf_frame_type_e
} __attribute__ ((packed)) crsf_header_t;

/*
// Used by extended header frames (type in range 0x28 to 0x96)
typedef struct
{
    // Common header fields, see crsf_header_t
    uint8_t device_addr;
    uint8_t frame_size;
    uint8_t type;
    // Extended fields
    uint8_t dest_addr;
    uint8_t orig_addr;
} __attribute__ ((packed)) crsf_ext_header_t;*/

typedef struct
{
	crsf_header_t header;
	crsf_channels_t channels;
	uint8_t crc;
} __attribute__ ((packed)) crsf_packet_t;

typedef enum
{
    CRSF_FRAMETYPE_GPS = 0x02,
    CRSF_FRAMETYPE_BATTERY_SENSOR = 0x08,
    CRSF_FRAMETYPE_LINK_STATISTICS = 0x14,
    CRSF_FRAMETYPE_RC_CHANNELS_PACKED = 0x16,
    CRSF_FRAMETYPE_ATTITUDE = 0x1E,
    CRSF_FRAMETYPE_FLIGHT_MODE = 0x21,
    // Extended Header Frames, range: 0x28 to 0x96
    CRSF_FRAMETYPE_DEVICE_PING = 0x28,
    CRSF_FRAMETYPE_DEVICE_INFO = 0x29,
    CRSF_FRAMETYPE_PARAMETER_SETTINGS_ENTRY = 0x2B,
    CRSF_FRAMETYPE_PARAMETER_READ = 0x2C,
    CRSF_FRAMETYPE_PARAMETER_WRITE = 0x2D,
    CRSF_FRAMETYPE_COMMAND = 0x32,
    // MSP commands
    CRSF_FRAMETYPE_MSP_REQ = 0x7A,   // response request using msp sequence as command
    CRSF_FRAMETYPE_MSP_RESP = 0x7B,  // reply with 58 byte chunked binary
    CRSF_FRAMETYPE_MSP_WRITE = 0x7C, // write with 8 byte chunked binary (OpenTX outbound telemetry buffer limit)
} crsf_frame_type_e;


typedef enum
{
    CRSF_ADDRESS_BROADCAST = 0x00,
    CRSF_ADDRESS_USB = 0x10,
    CRSF_ADDRESS_TBS_CORE_PNP_PRO = 0x80,
    CRSF_ADDRESS_RESERVED1 = 0x8A,
    CRSF_ADDRESS_CURRENT_SENSOR = 0xC0,
    CRSF_ADDRESS_GPS = 0xC2,
    CRSF_ADDRESS_TBS_BLACKBOX = 0xC4,
    CRSF_ADDRESS_FLIGHT_CONTROLLER = 0xC8,
    CRSF_ADDRESS_RESERVED2 = 0xCA,
    CRSF_ADDRESS_RACE_TAG = 0xCC,
    CRSF_ADDRESS_RADIO_TRANSMITTER = 0xEA,
    CRSF_ADDRESS_CRSF_RECEIVER = 0xEC,
    CRSF_ADDRESS_CRSF_TRANSMITTER = 0xEE,
} crsf_addr_e;

/*
 * 0x14 Link statistics
 * Payload:
 *
 * uint8_t Uplink RSSI Ant. 1 ( dBm * -1 )
 * uint8_t Uplink RSSI Ant. 2 ( dBm * -1 )
 * uint8_t Uplink Package success rate / Link quality ( % )
 * int8_t Uplink SNR ( db )
 * uint8_t Diversity active antenna ( enum ant. 1 = 0, ant. 2 )
 * uint8_t RF Mode ( enum 4fps = 0 , 50fps, 150hz)
 * uint8_t Uplink TX Power ( enum 0mW = 0, 10mW, 25 mW, 100 mW, 500 mW, 1000 mW, 2000mW )
 * uint8_t Downlink RSSI ( dBm * -1 )
 * uint8_t Downlink package success rate / Link quality ( % )
 * int8_t Downlink SNR ( db )
 * Uplink is the connection from the ground to the UAV and downlink the opposite direction.
 */

typedef struct crsfPayloadLinkstatistics_s
{
    uint8_t uplink_RSSI_1;
    uint8_t uplink_RSSI_2;
    uint8_t uplink_Link_quality;
    int8_t uplink_SNR;
    uint8_t active_antenna;
    uint8_t rf_Mode;
    uint8_t uplink_TX_Power;
    uint8_t downlink_RSSI;
    uint8_t downlink_Link_quality;
    int8_t downlink_SNR;
} crsfLinkStatistics_t;

#define ELRS_ROLL		ch0
#define ELRS_PITCH		ch1
#define ELRS_THROTTLE	ch2
#define ELRS_YAW		ch3

#define ELRS_SA			ch4
#define ELRS_SB			ch5
#define ELRS_SC			ch6
#define ELRS_SD			ch7

#define ELRS_ARM_CHANNEL ELRS_SA

#define ELRS_AUX_MIN	191
#define ELRS_AUX_MID	992
#define ELRS_AUX_MAX	1792

void init_RX_USART(void);
crsf_channels_t* RX_USART_get_channels();
uint16_t RX_USART_convert_channel_to_motor_range(uint16_t ch);
float RX_USART_convert_channel_to_unit_range(uint16_t ch);

uint8_t radio_signal_status();
uint8_t current_radio_signal_status();

#endif /* __RX_USART_H__ */
