michaellangford99/ECE47700/(commit log)

2022-09-02 added some source files
    [Connectors.SchDoc, MB1136.PcbDoc, MB1136.PrjPCB, MB1136.SCHLIB, MB1136.SchDoc, MCU_64.SchDoc, New_configuration.cfg, Requirements.xlsx]
2022-09-15 removed old files
    [New_configuration.cfg, test_old_f446_green_board Debug.cfg, uart_test_project Run.cfg]
2022-09-15 added all files
    [Flight Controller Task Breakdown.xlsx, Requirements.xlsx, SO_v4_5inch_arm_4mm_4x.dxf, uart_test_project Run.cfg]
2022-09-23 new source code, additional folders
    [Requirements.xlsx, acq0001.csv, acq0002.csv, acq0003.csv, acq0004.csv, acq0005.csv, acq0006.csv, acq0007.csv]
2022-09-26 created progress rpt, new PCB folder properly named via template use, fixed initial radio text code (it works now)
    [BLHeli32DefaultsX.cfg, Bill of Materials.xlsx, ECE477_PCB Full BOM.csv, ECE477_PCB-BOM.csv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]
2022-09-30 added new test project with pwm and motors
    [PPMPrac01 Run.cfg, pwm_and_radio_test Run.cfg]
2022-09-30 updated PCB to Kicad 6
    [DataLogger.kicad_sch, DataLogger.sch, ECE477_PCB.kicad_pcb, ECE477_PCB.kicad_sch, ECE477_PCB.sch, IMU.kicad_sch, IMU.sch]
2022-09-30 found and converted to .wrl 3d model file for connector
2022-10-01 modified layout of motor control and power, added minimal initial schematic for LiDAR and footprints
    [ECE477_PCB.kicad_pcb, ECE477_PCB.kicad_sch, IMU.kicad_sch]
2022-10-02 updated schematic I2C and UART connections
    [ECE477_PCB.kicad_pcb, ECE477_PCB.kicad_sch, IMU.kicad_sch, Requirements.xlsx]
2022-10-04 getting pretty close. fixed DRC errors, moved UARTS and radio connector, added pi zero connector
    [ECE477_PCB.kicad_pcb, ECE477_PCB.kicad_sch]
2022-10-05 completed first rev of PCB. looks like the Pi connector needs moved slightly, board radius is off but drill positions are still the same
    [ECE477_PCB.kicad_pcb, ECE477_PCB.kicad_sch, IMU.kicad_sch]
2022-10-05 Non-working SPI code
2022-10-06 fixed pi zero connector position
    [ECE477_PCB.kicad_pcb]
2022-10-06 initial rev of LIDAR lib
2022-10-06 switch VL... lib to C
2022-10-08 fixed ESC connector placement
    [ECE477_PCB.kicad_pcb, ECE477_PCB.kicad_sch]
2022-10-08 adding zip of pcb project for inspection
2022-10-09 VL53L1X.c, main.c, i2c.c
    Changed VL53L1X.c to include our register code
2022-10-09 i2c.h, VL53L1X.h
2022-10-10 further integrated LiDAR library, not all the way there yet
2022-10-11 additional changes
    [I2C_LIDAR Debug.cfg]
2022-10-11 added new docs
    [Requirements.xlsx]
2022-10-12 motors running, not the prettiest code yet though
2022-10-13 fixed vias, added test points, fixed ground plane in some spots
    [ECE477_PCB.kicad_pcb, ECE477_PCB.kicad_sch, IMU.kicad_sch]
2022-10-13 fixed more ground plane risks
    [ECE477_PCB.kicad_pcb]
2022-10-13 fixed potential issues with mounting holes
    [ECE477_PCB.kicad_pcb]
2022-10-13 removing old pcb from history
    [Connectors.SchDoc, MB1136.PcbDoc, MB1136.PrjPCB, MB1136.SCHLIB, MB1136.SchDoc, MCU_64.SchDoc, Requirements.xlsx, STM32_SMD_Quadcopter Full BOM.csv]
2022-10-14 updated powerpoint
2022-10-14 updated reqs, block diagram, BOM, added datasheets
    [Bill of Materials.xlsx, Requirements.xlsx]
2022-10-14 added a couple PCB screenshots
2022-10-14 fixed resistor divider and added keepout under the oscillator
    [ECE477_PCB.kicad_pcb, ECE477_PCB.kicad_sch]
2022-10-18 SPI code (working?)
    work on in ManLab
2022-10-19 extended qfn pads, added 3d model
    [5v-1.5a-step-up-step-down-voltage-regulator-s13v15f5.step, 5v-1a-step-up-step-down-voltage-regulator-s13v10f5.step, 5v-2a-step-up-step-down-voltage-regulator-s13v20f5.step, ECE477_PCB.kicad_pcb]
2022-10-20 committing before large change to FTDI
    [ECE477_PCB.kicad_pcb]
2022-10-20 last fixes, ready to order (I think)
    [ECE477_PCB-B_Adhesive.gbr, ECE477_PCB-B_Cu.gbr, ECE477_PCB-B_Mask.gbr, ECE477_PCB-B_Paste.gbr, ECE477_PCB-B_Silkscreen.gbr, ECE477_PCB-Edge_Cuts.gbr, ECE477_PCB-F_Adhesive.gbr, ECE477_PCB-F_Cu.gbr]
2022-10-20 updated PCB zip file
2022-10-20 ready to order
    [ECE477_PCB-B_Adhesive.gbr, ECE477_PCB-B_Cu.gbr, ECE477_PCB-B_Mask.gbr, ECE477_PCB-B_Paste.gbr, ECE477_PCB-B_Silkscreen.gbr, ECE477_PCB-Edge_Cuts.gbr, ECE477_PCB-F_Adhesive.gbr, ECE477_PCB-F_Cu.gbr]
2022-10-21 purchase version gerbers
    [ECE477_PCB-B_Adhes.gbr, ECE477_PCB-B_Adhesive.gbr, ECE477_PCB-B_Cu.gbr, ECE477_PCB-B_Mask.gbr, ECE477_PCB-B_Paste.gbr, ECE477_PCB-B_SilkS.gbr, ECE477_PCB-B_Silkscreen.gbr, ECE477_PCB-Edge_Cuts.gbr]
2022-10-25 FULL SPI WORKING Code with UART
2022-10-25 SPI not zipped
    [SPI on STM32F4 Debug.cfg, SPI on STM32F4 Run.cfg]
2022-10-25 SPI working better
    [SPI on STM32F4 Run.cfg]
2022-10-25 went full scale, added quick implementation of angle integration and calibration
2022-10-26 adding projects for full board, and for just the LSM6 on the F411. Added systick code with #defines, and modified USART to compute baudrate settings. almost done there.
    [New_configuration.cfg]
2022-10-26 cleaned up SPI and LSM code with define statements
    [ECE477 Debug.cfg]
2022-10-30 good data from LIDAR
    [I2C_LIDAR Run.cfg]
2022-10-30 updated drivers with better #defines. more to come.
2022-11-02 updating pin definitions, adding drivers
2022-11-02 add psuedocode, fix formatting
    [i2c.c, i2c.h, main.c]
2022-11-02 getting system working on correct pins. big headache
    [ECE477 Run.cfg]
2022-11-02 motor pwm working on all pins
2022-11-03 got accelerometer working
2022-11-03 got accelerometer working better
2022-11-05 Not finnished but translated to not use arduino library
2022-11-09 added mechanical models and prints
    [0204 - Capacitor Brown.SLDPRT, 0204 - Capacitor Brown.ipt, 0204 - Capacitor.SLDPRT, 0204 - Capacitor.ipt, 0204- Resistor.SLDPRT, 0204- Resistor.ipt, 0805- Capacitor.SLDPRT, 0805- Capacitor.ipt]
2022-11-10 temp location for i2c pi code
2022-11-10 FINAALLYYYgit add I2C_LIDARgit add I2C_LIDAR
2022-11-16 IMU working, all non-nav computer PSSCs met
    [ECE477 Run.cfg]
2022-11-16 added 3D models
    [ECE477_PCB.dxf, ECE477_PCB.iges]
2022-11-17 switched to HSI, PLL to 180MHz, motor PWM and clock constants fixed
    [lsm6ds3.c, lsm6ds3.h, main.c, pwm.c, rx_usart.c, spi.c, spi.h, system.h]
2022-11-17 IMU complementary filter working
2022-11-18 updated mount and assembly
    [ECE477.0013.iam, ECE477.0018.iam, ECE477.iam, Flight Controller Mount.0007.ipt, Flight Controller Mount.ipt]
2022-11-18 exported new mount stl
    [Flight Controller Mount v2.stl]
2022-11-21 complementary filter fixed, added adaptive gain feature
    [fir.c, fir.h, lsm6ds3.c, lsm6ds3.h, main.c, pid.c, pid.h]
2022-11-21 untuned, but motors and PID all work
2022-11-26 added decimating FIR option, motor filtering.
2022-11-26 add mpu6500 1st rev, CS pin control in SPI driver
2022-11-29 created common IMU struct, fixed mpu6500 driver, made both work in tandem
    [imu.h, lsm6ds3.c, lsm6ds3.h, mpu6500.c, mpu6500.h, spi.c]
2022-11-29 fixed pi uart clock rate, added debug dumps
    [i2c.c, pi_usart.c, pi_usart.h, pid.h]
2022-11-29 incororated imu updates, changed LPF on motors from loop_rate/256 to loop_rate/64
2022-11-29 added docs and data
    [BM10B-SRSS-TB.STEP, Requirements.xlsx, SM10B-SRSS-TB.STEP, gyro_data_500dps.csv]
2022-11-30 disabled accelerometer filter for noise power estimation
    [lsm6ds3.c, mpu6500.c]
2022-11-30 changed motor decimation, integrating pi uart
2022-12-02 added bounds on each PID response type
2022-12-02 fixed pi frame format
    [pi_usart.h]
2022-12-02 added IMU and ESC docs
2022-12-02 TMF8801 lidar sensor working
    [ECE477 Run.cfg]
2022-12-05 fixed and tuned variable complementary filter gain
    [lsm6ds3.c, lsm6ds3.h]
2022-12-06 IT FLIES ok now I'll be professional. tuned PIDs, finished mocing code to safety section, reduced LPF on motors
2022-12-09 added I2C lidar, auto-throttle, watchdog, filtering in I2c
2022-12-10 first successful auto-throttle flight code
2022-12-10 updated PID tune, added integral yaw control
2022-12-16 more docs
    [Requirements.xlsx]
2023-01-17 moved test stuff
    [ECE477_STM32F446RET6_Test Run.cfg, I2C Run.cfg, I2C_LIDAR Debug.cfg, I2C_LIDAR Run.cfg, New_configuration.cfg, PPMPrac01 Run.cfg, SPI on STM32F4 Debug.cfg, SPI on STM32F4 Run.cfg]
